SebKuzminsky/MazakVQC1540/machine-pics/PXL_20220612_192915210.jpg

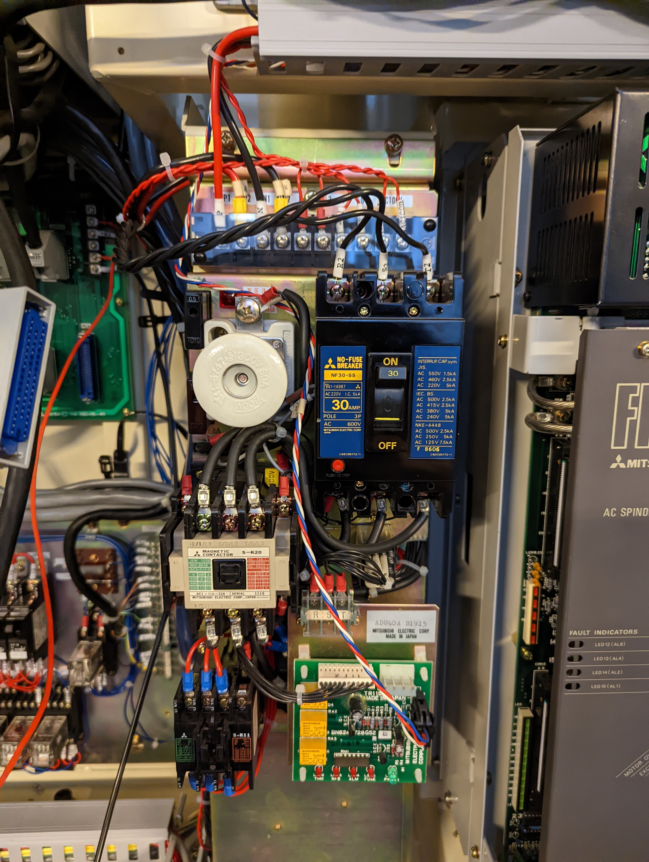
machine-pics/PXL_20220612_192915210.jpg
