SebKuzminsky/MazakVQC1540/machine-pics/PXL_20220614_065109930.jpg

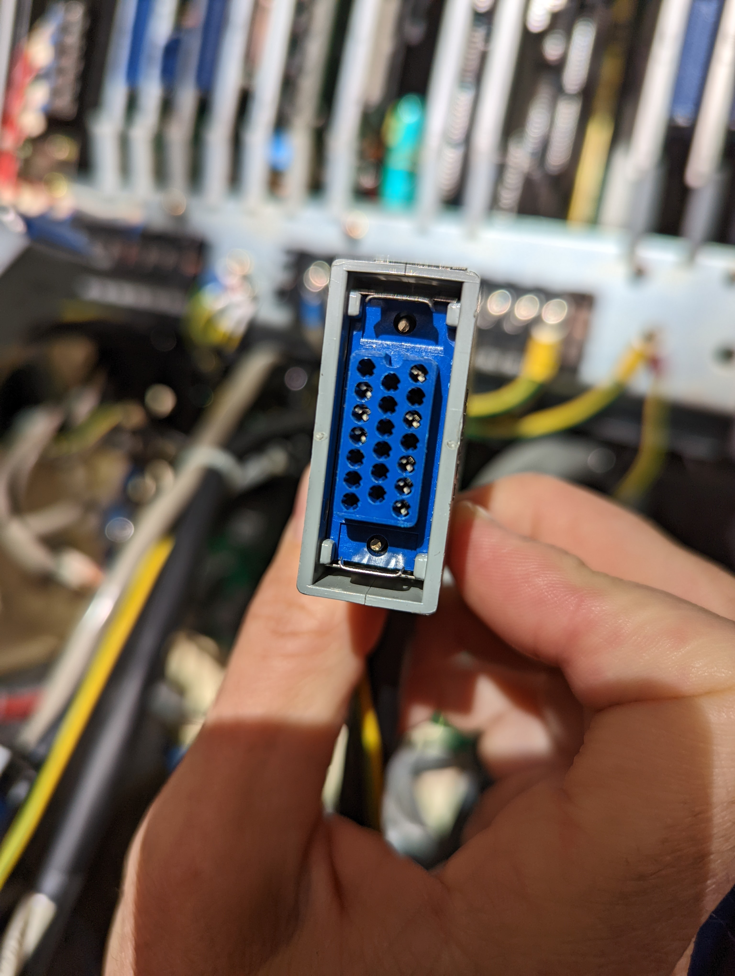
machine-pics/PXL_20220614_065109930.jpg
