SebKuzminsky/MazakVQC1540/docs/README.md

Documentation downloaded from the Internet
==========================================

* 8-channel-5v-relay-module/
* mesa/

* Meldas-Servo-Amp-maintenance-manual.pdf
  https://www.rgbautomatyka.pl/en/p/file/f828d04fb4ae38ead861076fa228e53f/TRA-41A-SERVO-DRIVE-MITSUBISHI-MANUAL.pdf
* meldas_trs50.pdf
  https://www.manualslib.com/manual/2310879/Mitsubishi-Meldas-Trs50.html
* Mitsubishi-Freqrol-SF-maintenance-manual.pdf
  http://cncmanual.com/mitsubishi-ac-spindle-drive-freqrol-sf-maintenance-manual/
* Mitsubishi-Freqrol-FR-SE-Maintenance-Manual.pdf
  http://cncmanual.com/mitsubishi-freqrol-ac-spindle-controller-fr-se-maintenance-manual/
* MR-connectors.pdf
  https://www.onlinecomponents.com/en/datasheet/mr50l-42248021/
* mrp-m1( )( ).pdf
  https://www.onlinecomponents.com/en/datasheet/mrpm112-41909323/
* MazatrolM2OperatorManual.pdf - Operating Manual for Mazak Mazatrol Cam M-2
  http://catiadoc.free.fr/img/MazatrolM2OperatorManual.pdf
* Mitsubishi-Freqrol-SE-Standard-Specification.pdf
  https://elektrotanya.com/mitsubishi_freqrol_fr-se_ac-spindle-controller_ver-3.00_instruction_sm.zip/download.html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
* Mazak-VQC-15-40-1986-Electrical-Circuit-Diagrams.pdf
  https://pastebin.com/uzooZah6
