SebKuzminsky/MazakVQC1540/Mazak-Oil.md

| CHEVRON | MOBIL |
|---|---|
| Waylube 68? $73.45  | Vactra 2 |
| Regal R&O 32 $70.80 | DTE Light  |
| Rando 10 $67.80 | Velocite 6 |
