SebKuzminsky/MazakVQC1540/machine-pics/mesa-cutting-board.jpeg

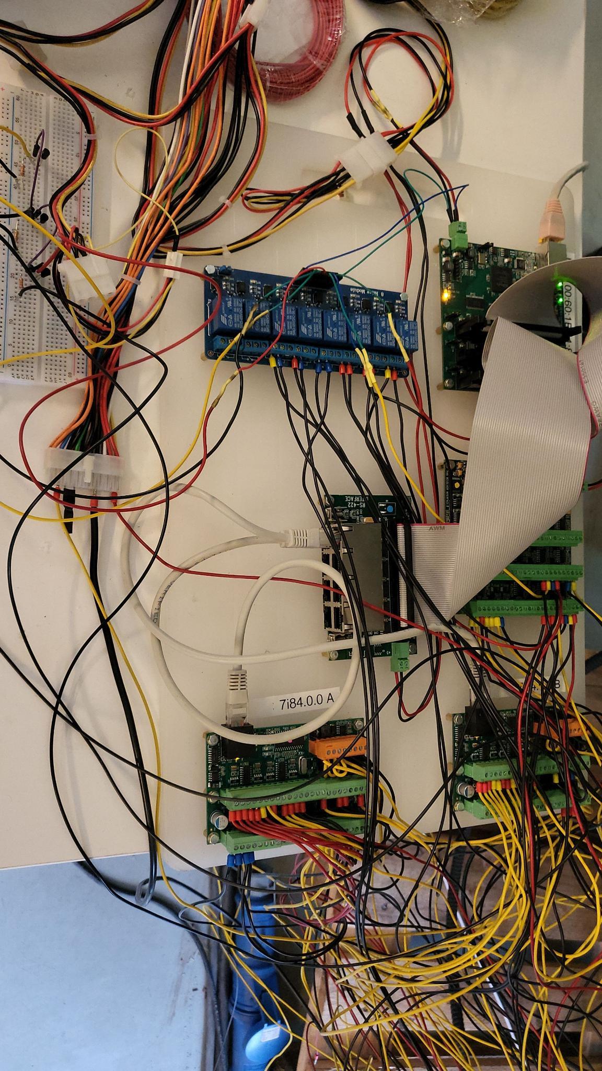
machine-pics/mesa-cutting-board.jpeg
