SebKuzminsky/MazakVQC1540/machine-pics/PXL_20220612_154800086.jpg

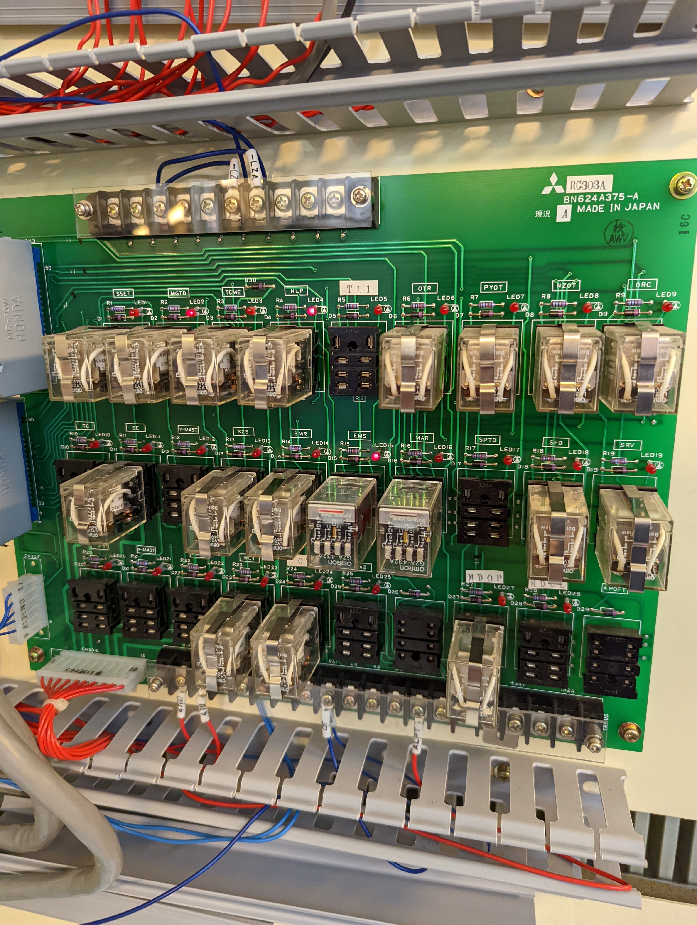
machine-pics/PXL_20220612_154800086.jpg
