SebKuzminsky/MazakVQC1540/machine-pics/PXL_20220612_192840629.jpg

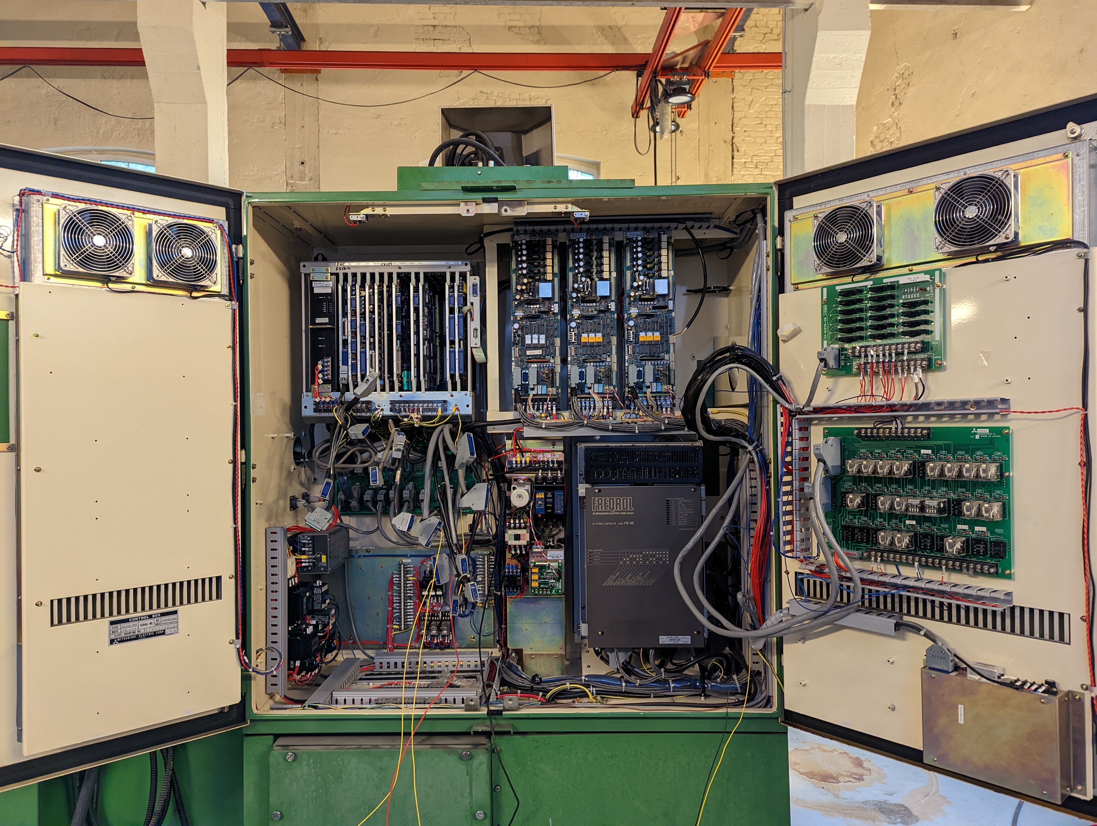
machine-pics/PXL_20220612_192840629.jpg
