SebKuzminsky/MazakVQC1540/machine-pics/PXL_20220612_192848661.jpg

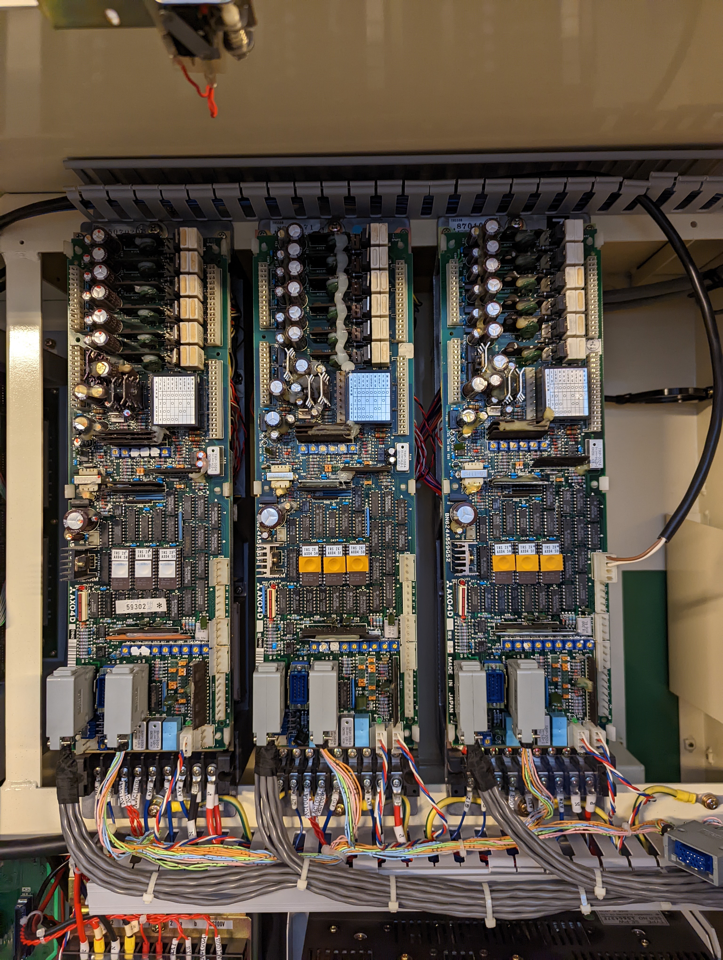
machine-pics/PXL_20220612_192848661.jpg
