SebKuzminsky/MazakVQC1540/machine-pics/PXL_20220612_192853894.jpg

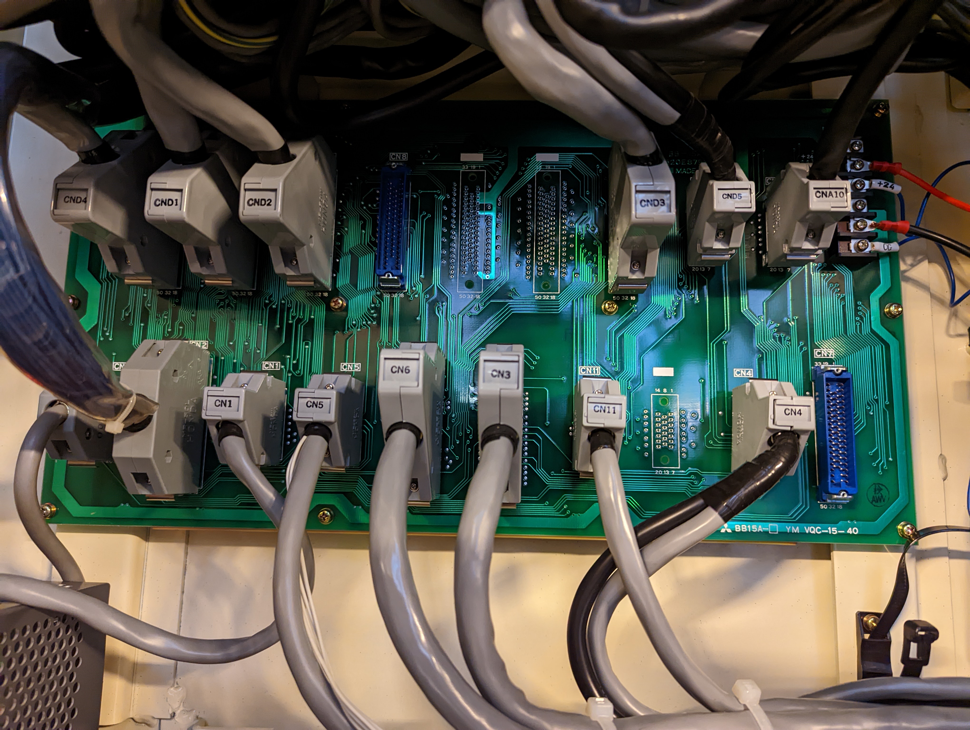
machine-pics/PXL_20220612_192853894.jpg
