SebKuzminsky/MazakVQC1540/machine-pics/PXL_20220612_192858269.jpg

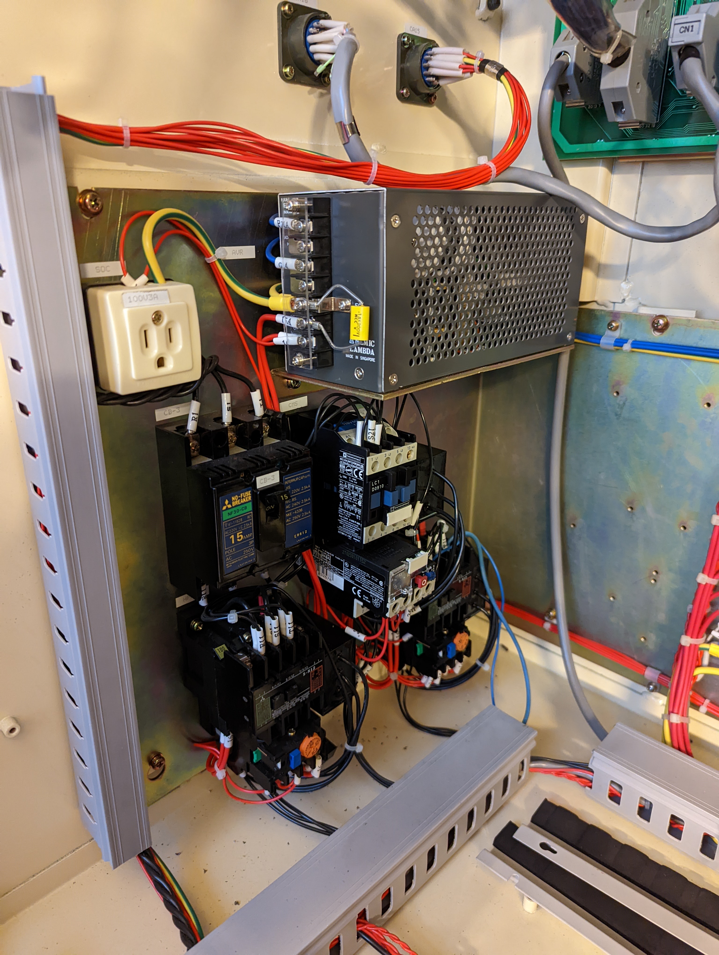
machine-pics/PXL_20220612_192858269.jpg
