SebKuzminsky/MazakVQC1540/machine-pics/PXL_20220612_192907922.jpg

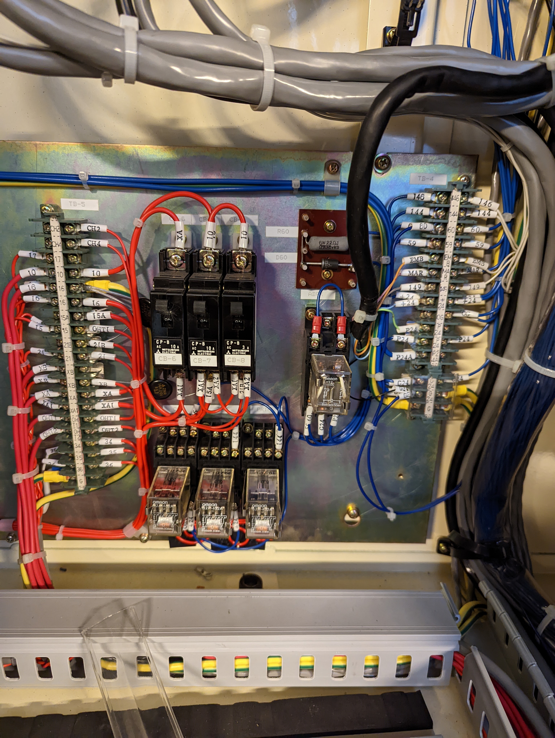
machine-pics/PXL_20220612_192907922.jpg
