SebKuzminsky/MazakVQC1540/machine-pics/PXL_20220612_192912369.jpg

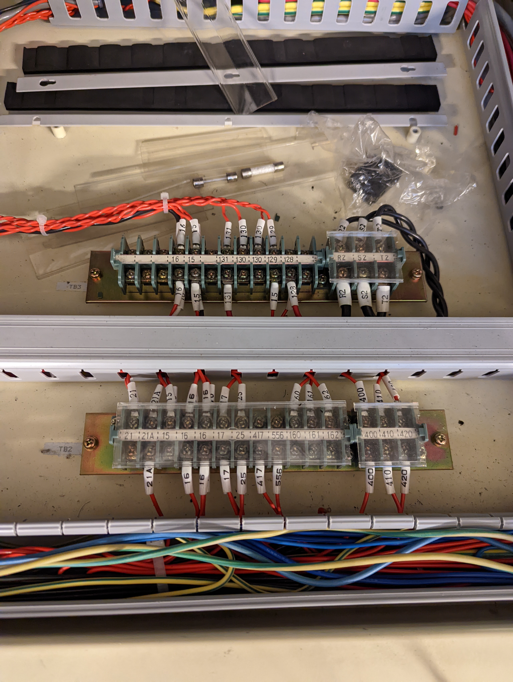
machine-pics/PXL_20220612_192912369.jpg
