SebKuzminsky/MazakVQC1540/machine-pics/PXL_20220612_192921102.jpg

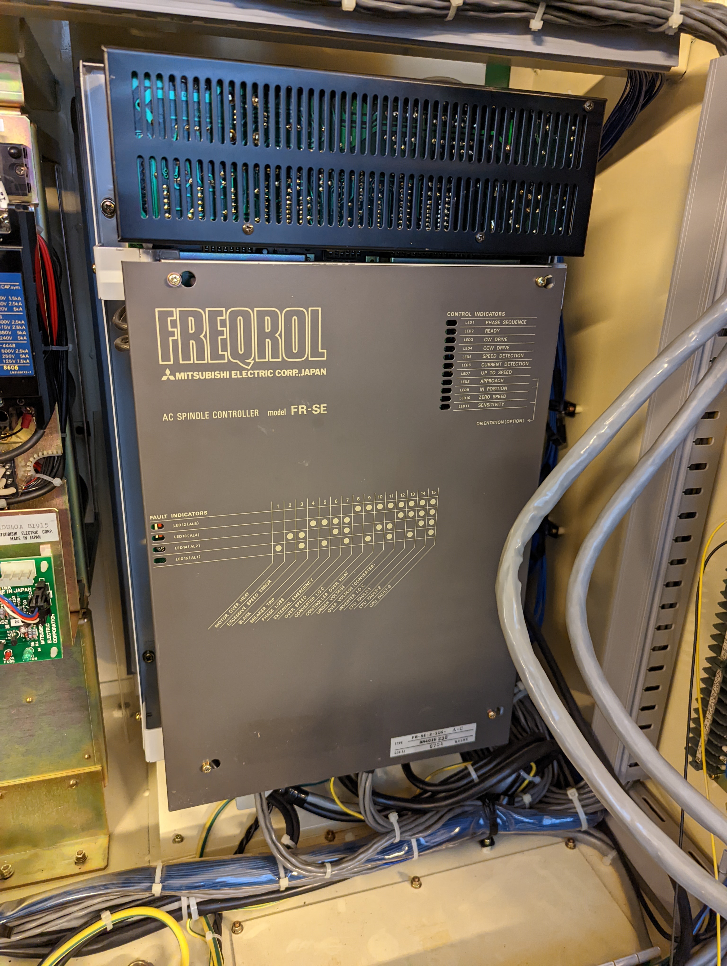
machine-pics/PXL_20220612_192921102.jpg
