SebKuzminsky/MazakVQC1540/machine-pics/PXL_20220612_192928278.jpg

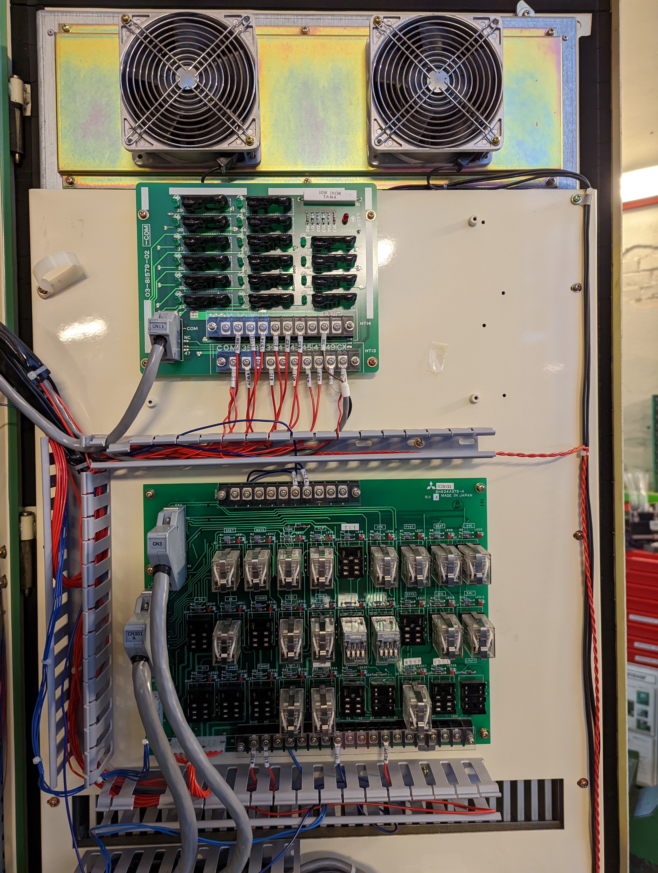
machine-pics/PXL_20220612_192928278.jpg
