SebKuzminsky/MazakVQC1540/machine-pics/PXL_20220613_133133988.jpg

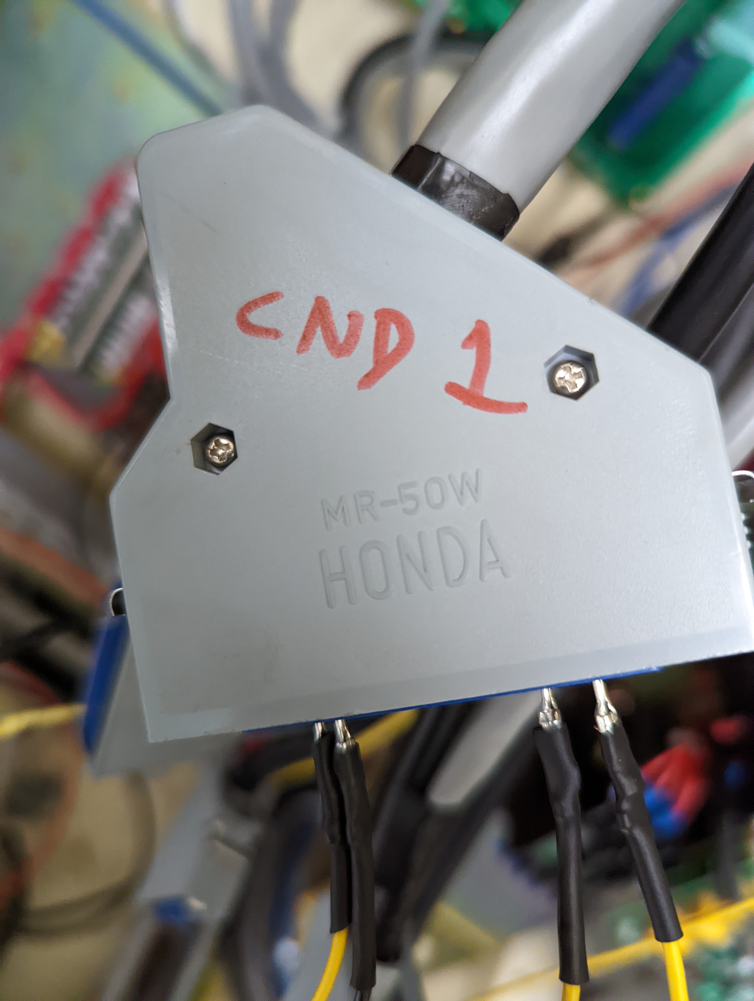
machine-pics/PXL_20220613_133133988.jpg
