SebKuzminsky/MazakVQC1540/machine-pics/PXL_20220614_065118337.jpg

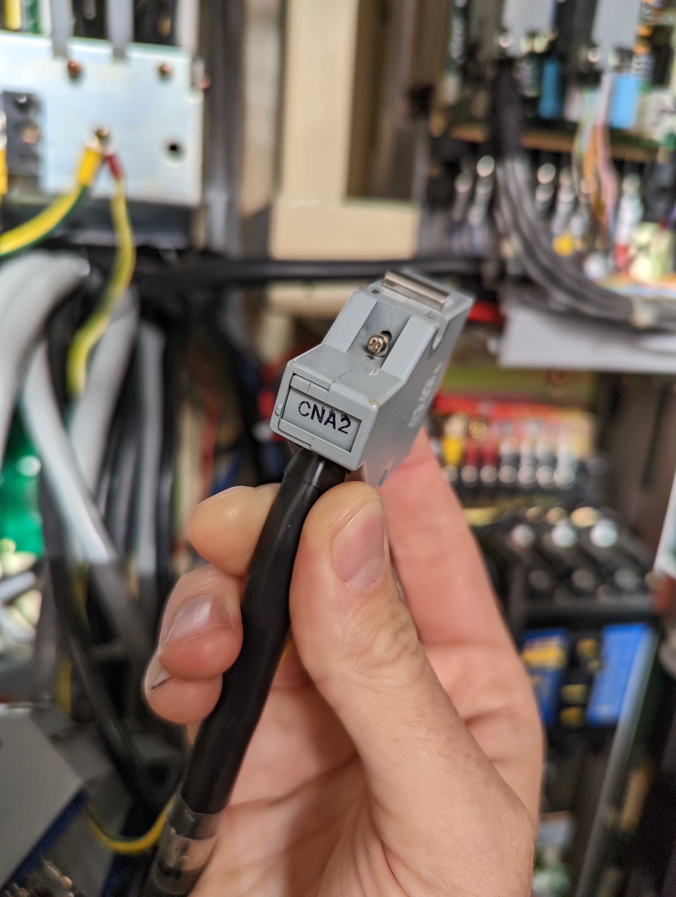
machine-pics/PXL_20220614_065118337.jpg
