SebKuzminsky/MazakVQC1540/machine-pics/PXL_20220614_075249411.jpg

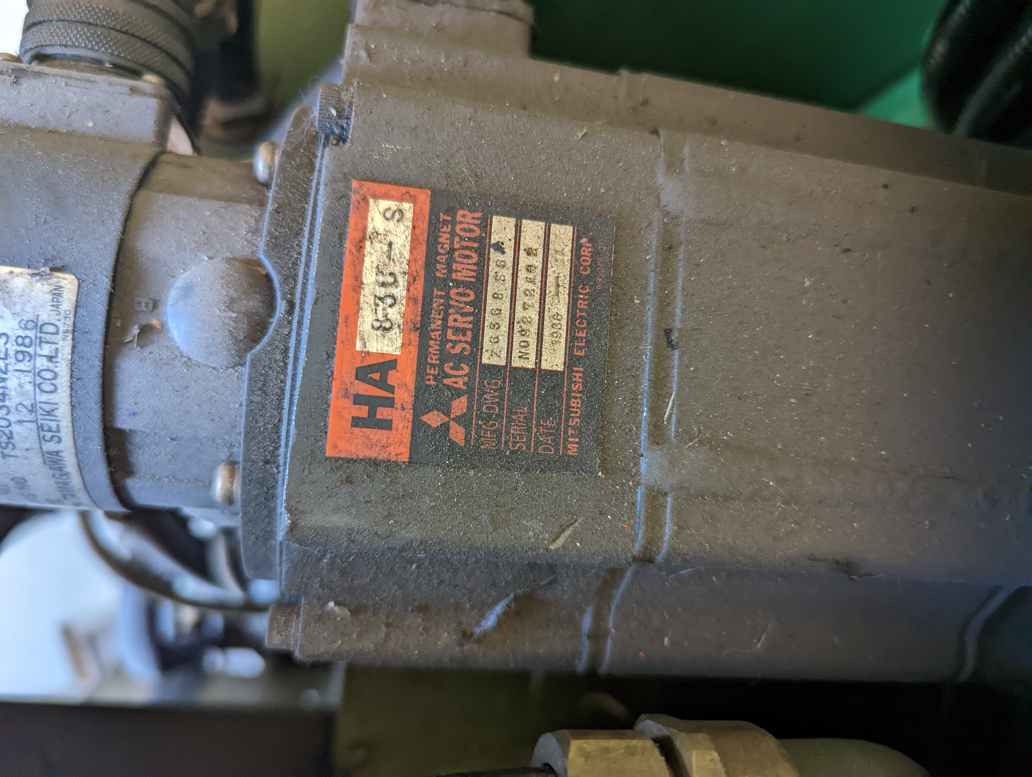
machine-pics/PXL_20220614_075249411.jpg
