SebKuzminsky/MazakVQC1540/machine-pics/PXL_20220614_075259628.jpg

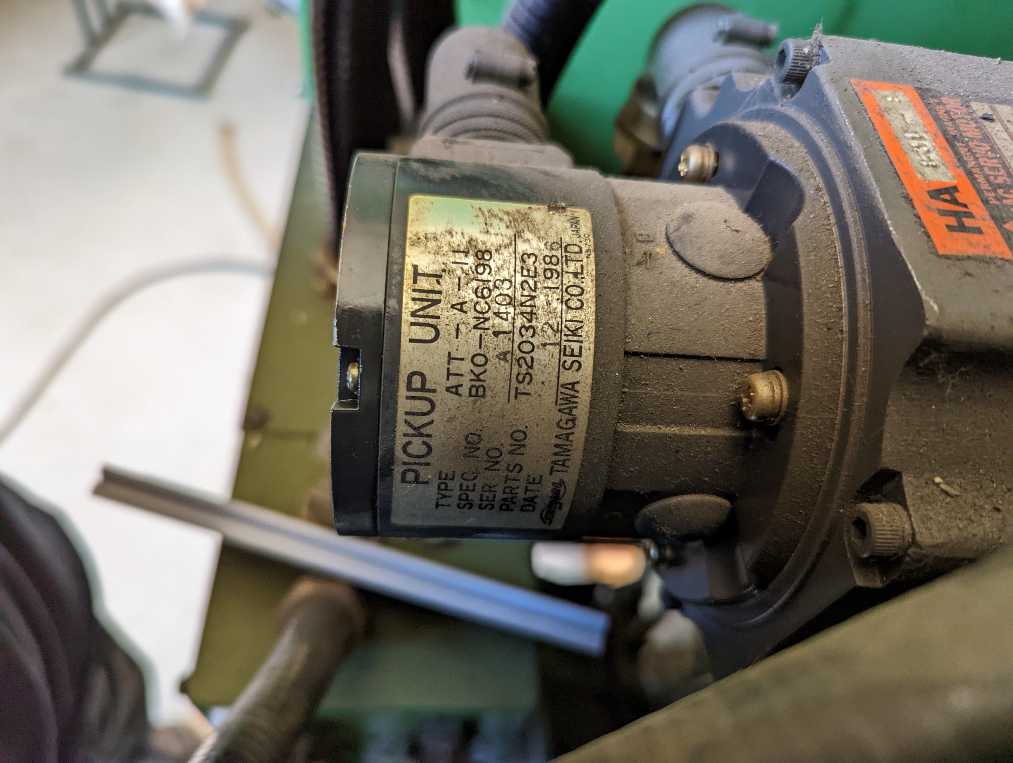
machine-pics/PXL_20220614_075259628.jpg
