SebKuzminsky/MazakVQC1540/machine-pics/PXL_20220614_083736623.jpg

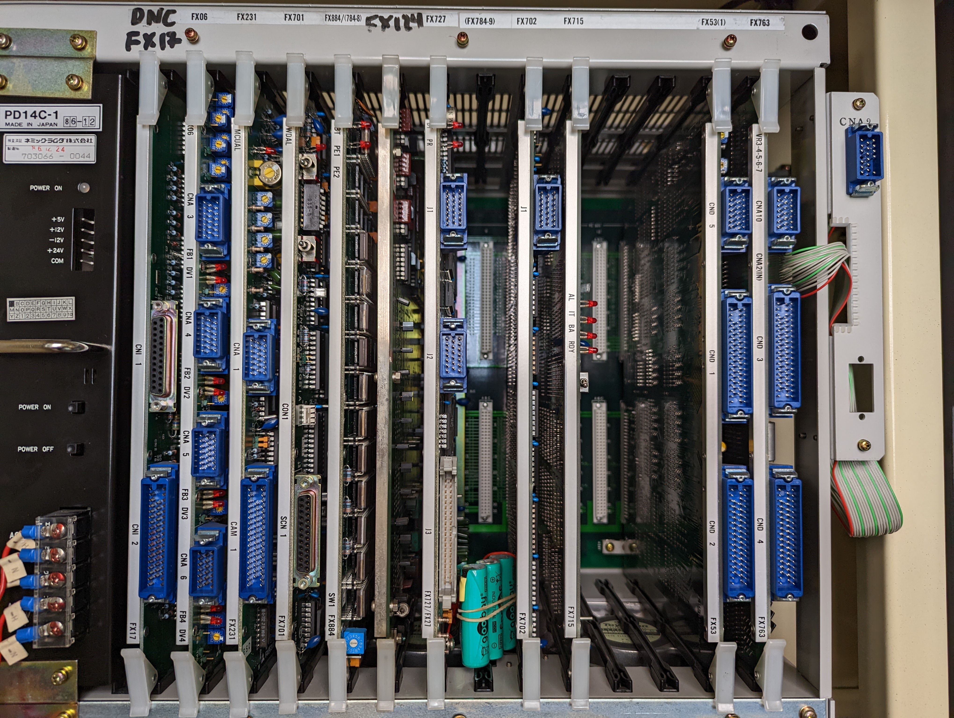
machine-pics/PXL_20220614_083736623.jpg
