SebKuzminsky/MazakVQC1540/docs/Altivar-71-3kW-240V/ATV71_communication_parameters_EN_V5.7_IE67.xls

Sheet: Parameters
Code | Name | Logic address | CANopen index | INTERBUS index | DeviceNet path | Link | Category | Access | Type | Units | Factory setting | Range | Display | Menu | Order
CMD | Control word | 16#2199 = 8601 (speed) 16#2135 = 8501 (frequency) | 16#6040/00 | 16#6040/00 | 16#8B/01/66 = 139/01/102 | CMD | Control parameters | R/W | WORD (BitString16) | - |  | - | [Cmd value] (CMd) | [COMMUNICATION MAP] (CMM-) | 1
CMI | Extended control word | 16#2138 = 8504 | 16#2037/5 | 16#5FB6/1E | 16#8B/01/69 = 139/01/105 | CMI | Control parameters | R/W | WORD (BitString16) | - |  | - |  |  | 2
RPR | Reset counters command | 16#0C30 = 3120 | 16#2001/15 | 16#5FB6/01 | 16#70/01/79 = 112/01/121 | RPR | Control parameters | R/W | WORD (Enumeration) | - | [No] (nO) | - | [Operating t. reset] (rPr) | [RUN Elapsed Time Reset] (Etr-) | 3
LFRD | Speed setpoint | 16#219A = 8602 | 16#6042/00 | 16#6042/00 | 16#2A/01/08 = 42/1/8 (messaging) 16#8C/01/03 = 140/1/3 (assembly) | - | Setpoint parameters | R/W | INT (Signed16) | 1 rpm | 0 rpm | - |  |  | 4
LFR | Frequency setpoint | 16#2136 = 8502 | 16#2037/3 | 16#5FB6/1C | 16#8B/01/67 = 139/01/103 | - | Setpoint parameters | R/W | INT (Signed16) | 0.1 Hz | 0.0 Hz | -3276.7 Hz ... 3276.7 Hz | [Frequency ref.] (LFr) | [MONITORING] (SUP-) | 5
LTR | Torque setpoint | 16#2139 = 8505 | 16#6071/00 | 16#5FB6/1F | 16#8B/01/6A = 139/01/106 | - | Setpoint parameters | R/W | INT (Signed16) | 0.1 % | 0.0 % | -300.0 % ... 300.0 % | [Torque ref.] (Ltr) | [MONITORING] (SUP-) | 6
PISP | PID regulator setpoint | 16#2137 = 8503 | 16#2037/4 | 16#5FB6/1D | 16#8B/01/68 = 139/01/104 | - | Setpoint parameters | R/W | UINT (Unsigned16) | 1 |  | 0 ... 1000 |  |  | 7
AIV1 | PID regulator feedback | 16#14A1 = 5281 | 16#2016/52 | 16#5FB6/5B | 16#7B/01/52 = 123/01/82 | - | Setpoint parameters | R/W | INT (Signed16) | 1 | 0 | -8192 ... 8192 |  |  | 8
MFR | Multiplying coefficient | 16#2E37 = 11831 | 16#2058/20 | 16#5FB6/3E | 16#9C/01/20 = 156/01/32 | - | Setpoint parameters | R/W | UINT (Unsigned16) | 1 % |  | 0 % ... 100 % | [Multiplying coeff.] (MFr) | [MONITORING] (SUP-) [SETTINGS] (SEt-) | 9
ETA | Status word | 16#219B = 8603 (speed) 16#0C81 = 3201 (frequency) | 16#6041/00 | 16#6041/00 | 16#71/01/02 = 113/01/02 | ETA | Status parameters | R | WORD (BitString16) | - |  | - | [ETA state word] (EtA) | [COMMUNICATION MAP] (CMM-) | 10
HMIS | Drive state | 16#0CA8 = 3240 | 16#2002/29 | 16#5FB9/1B | 16#71/01/29 = 113/01/41 | HMIS | Status parameters | R | WORD (Enumeration) | - |  | - |  |  | 11
ETI | Extended status word | 16#0C86 = 3206 | 16#2002/7 | 16#5FB9/08 | 16#71/01/07 = 113/01/07 | ETI | Status parameters | R | WORD (BitString16) | - |  | - |  |  | 12
LRS1 | Extended status word 1 | 16#0CB2 = 3250 | 16#2002/33 | 16#5FB9/1C | 16#71/01/33 = 113/01/51 | LRS1 | Status parameters | R | WORD (BitString16) | - |  | - |  |  | 13
LRS2 | Extended status word 2 | 16#0CB3 = 3251 | 16#2002/34 | 16#5FB9/1D | 16#71/01/34 = 113/01/52 | LRS2 | Status parameters | R | WORD (BitString16) | - |  | - |  |  | 14
LRS3 | Extended status word 3 | 16#0CB4 = 3252 | 16#2002/35 | 16#5FB9/1E | 16#71/01/35 = 113/01/53 | LRS3 | Status parameters | R | WORD (BitString16) | - |  | - |  |  | 15
LRS4 | Extended status word 4 | 16#0CB5 = 3253 | 16#2002/36 | 16#5FB9/1F | 16#71/01/36 = 113/01/54 | LRS4 | Status parameters | R | WORD (BitString16) | - |  | - |  |  | 16
LRS5 | Extended status word 5 | 16#0CB6 = 3254 | 16#2002/37 | 16#5FB9/20 | 16#71/01/37 = 113/01/55 | LRS5 | Status parameters | R | WORD (BitString16) | - |  | - |  |  | 17
LRS6 | Extended status word 6 | 16#0CB7 = 3255 | 16#2002/38 | 16#5FB9/21 | 16#71/01/38 = 113/01/56 | LRS6 | Status parameters | R | WORD (BitString16) | - |  | - |  |  | 18
LRS7 | Extended status word 7 | 16#0CB8 = 3256 | 16#2002/39 | 16#5FB9/22 | 16#71/01/39 = 113/01/57 | LRS7 | Status parameters | R | WORD (BitString16) | - |  | - |  |  | 19
LRS8 | Extended status word 8 | 16#0CB9 = 3257 | 16#2002/3A | 16#5FB9/23 | 16#71/01/3A = 113/01/58 | LRS8 | Status parameters | R | WORD (BitString16) | - |  | - |  |  | 20
CRC | Active reference channel | 16#20F9 = 8441 | 16#2036/2A | 16#5FB9/CE | 16#8B/01/2A = 139/01/42 | CRC | Status parameters | R | WORD (BitString16) | - |  | - |  |  | 21
CCC | Active command channel | 16#20FA = 8442 | 16#2036/2B | 16#5FB9/CF | 16#8B/01/2B = 139/01/43 | CCC | Status parameters | R | WORD (BitString16) | - |  | - |  |  | 22
CNFS | Config. active | 16#1F54 = 8020 | 16#2032/15 | 16#5FB9/CD | 16#89/01/15 = 137/01/21 | CNFS | Status parameters | R | WORD (Enumeration) | - |  | - | [Config. active] (CnFS) | [MONITORING] (SUP-) | 23
ECSS | EtherCAT Slave Status | 16#1A22 = 6690 | 16#2024/5B | - | 16#82/01/5B = 130/01/91 | ETST | Status parameters | R | WORD (Enumeration) | - |  | - | [EthCat slave status] (ECSS) | [COMMUNICATION CARD] (Cbd-) | 24
ECAA | EtherCAT second Address actual value | 16#1A24 = 6692 | 16#2024/5D | - | 16#82/01/5D = 130/01/93 | - | Status parameters | R | UINT (Unsigned16) | 1 | 0 | 0 ... 65535 | [EthCat addr] (ECAA) | [COMMUNICATION CARD] (Cbd-) | 25
RFRD | Output velocity | 16#219C = 8604 | 16#6044/00 | 16#6044/00 | 16#2A/01/07 = 42/1/7 (messaging) 16#8C/01/05 = 140/1/5 (assembly) | - | Actual values parameters | R | INT (Signed16) | 1 rpm |  | - |  |  | 26
RFR | Output frequency | 16#0C82 = 3202 | 16#2002/3 | 16#5FB9/04 | 16#71/01/03 = 113/01/03 | - | Actual values parameters | R | INT (Signed16) | 0.1 Hz |  | -3276.7 Hz ... 3276.7 Hz | [Output frequency] (rFr) | [MONITORING] (SUP-) | 27
OTR | Motor torque | 16#0C85 = 3205 | 16#6077/00 | 16#5FB9/07 | 16#71/01/06 = 113/01/06 | - | Actual values parameters | R | INT (Signed16) | Refer to programming manual |  | Refer to programming manual | [Motor torque] (Otr) | [MONITORING] (SUP-) | 28
LCR | Motor current | 16#0C84 = 3204 | 16#2002/5 | 16#5FB9/06 | 16#2A/01/09 = 42/1/9 (messaging) 16#71/01/05 = 113/1/5 (assembly) | - | Actual values parameters | R | UINT (Unsigned16) | Refer to programming manual |  | Refer to programming manual | [Motor current] (LCr) | [MONITORING] (SUP-) | 29
UOP | Motor voltage | 16#0C88 = 3208 | 16#2002/9 | 16#5FB9/0A | 16#71/01/09 = 113/01/09 | - | Actual values parameters | R | UINT (Unsigned16) | 1 V |  | 0 V ... 65535 V | [Motor voltage] (UOP) | [MONITORING] (SUP-) | 30
OPR | Motor power | 16#0C8B = 3211 | 16#2002/C | 16#5FB9/0C | 16#71/01/0C = 113/01/12 | - | Actual values parameters | R | INT (Signed16) | 1 % |  | -32767 % ... 32767 % | [Motor power] (OPr) | [MONITORING] (SUP-) | 31
AVS | ENA average speed | 16#2F46 = 12102 | 16#205B/3 | 16#5FB9/EA | 16#9D/01/67 = 157/01/103 | - | Actual values parameters | R | INT (Signed16) | 0.1 Hz |  | -3276.7 Hz ... 3276.7 Hz | [ENA avg speed] (AUS) | [MONITORING] (SUP-) | 32
FRHD | Speed reference before ramp | 16#219D = 8605 | 16#2038/6 | 16#6043/00 | 16#8C/01/06 = 140/01/06 | - | Reference parameters | R | INT (Signed16) | 1 rpm |  | - |  |  | 33
FROD | Speed reference after ramp | 16#21C1 = 8641 | 16#6043/00 | 16#5FB9/D8 | 16#8C/01/2A = 140/01/42 | - | Reference parameters | R | INT (Signed16) | 1 rpm |  | - |  |  | 34
FRH | Frequency reference before ramp | 16#0C83 = 3203 | 16#2002/4 | 16#5FB9/05 | 16#71/01/04 = 113/01/04 | - | Reference parameters | R | INT (Signed16) | 0.1 Hz |  | -1600.0 Hz ... 1600.0 Hz | [Frequency ref.] (FrH) | [MONITORING] (SUP-) [COMMUNICATION MAP] (CMM-) | 35
FRO | Frequency reference after ramp | 16#233D = 9021 | 16#203C/16 | 16#5FB9/D9 | 16#8E/01/16 = 142/01/22 | - | Reference parameters | R | INT (Signed16) | 0.1 Hz |  | - |  |  | 36
TRR | Torque reference before ramp | 16#240F = 9231 | 16#203E/20 | 16#5FB9/DB | 16#8F/01/20 = 143/01/32 | - | Reference parameters | R | INT (Signed16) | 0.1 % |  | - | [Torque reference] (trr) | [MONITORING] (SUP-) | 37
RPC | PID reference after ramp | 16#2ECE = 11982 | 16#2059/53 | 16#5FB9/E7 | 16#9C/01/B7 = 156/01/183 | - | Reference parameters | R | UINT (Unsigned16) | 1 |  | 0 ... 65535 | [PID reference] (rPC) | [MONITORING] (SUP-) | 38
RPF | PID regulator feedback reference | 16#2ECD = 11981 | 16#2059/52 | 16#5FB9/E6 | 16#9C/01/B6 = 156/01/182 | - | Reference parameters | R | UINT (Unsigned16) | 1 |  | 0 ... 65535 | [PID feedback] (rPF) | [MONITORING] (SUP-) | 39
RPE | PID regulator discrepancy | 16#2ECC = 11980 | 16#2059/51 | 16#5FB9/E5 | 16#9C/01/B5 = 156/01/181 | - | Reference parameters | R | INT (Signed16) | 1 |  | -32767 ... 32767 | [PID error] (rPE) | [MONITORING] (SUP-) | 40
RPO | PID regulator limit output reference | 16#2ECF = 11983 | 16#2059/54 | 16#5FB9/E8 | 16#9C/01/B8 = 156/01/184 | - | Reference parameters | R | INT (Signed16) | 0.1 Hz |  | -3276.7 Hz ... 3276.7 Hz | [PID Output] (rPO) | [MONITORING] (SUP-) | 41
DAY | Date | 16#1CDF = 7391 | 16#202B/5C | 16#5FB9/CA | 16#85/01/C0 = 133/01/192 | - | Measurement parameters | R/W | UINT (Unsigned16) | 1 |  | 0 ... 65535 | (dAY) | (CLO-) | 42
TIME | Time | 16#1CE0 = 7392 | 16#202B/5D | 16#5FB9/CB | 16#85/01/C1 = 133/01/193 | - | Measurement parameters | R/W | UINT (Unsigned16) | 1 |  | 0 ... 65535 | (tIME) | (CLO-) | 43
ULN | Mains voltage | 16#0C87 = 3207 | 16#2002/8 | 16#5FB9/09 | 16#71/01/08 = 113/01/08 | - | Measurement parameters | R | UINT (Unsigned16) | 0.1 V |  | [No meas.] (----) ... 6553.5 V | [Mains voltage] (ULn) | [U CALIBRATION RESULT] (CAU-) [MONITORING] (SUP-) | 44
APH | Energy consumption | 16#0C9E = 3230 | 16#2002/1F | 16#5FB9/15 | 16#71/01/1F = 113/01/31 | - | Measurement parameters | R | UINT (Unsigned16) | Refer to programming manual |  | Refer to programming manual | [Consumption] (APH) | [MONITORING] (SUP-) | 45
THD | Drive thermal state | 16#0C89 = 3209 | 16#2002/A | 16#5FB9/0B | 16#71/01/0A = 113/01/10 | - | Measurement parameters | R | UINT (Unsigned16) | 1 % |  | 0 % ... 200 % | [Drv. thermal state] (tHd) | [MONITORING] (SUP-) | 46
THR | Motor thermal state | 16#259E = 9630 | 16#2042/1F | 16#5FB9/DE | 16#91/01/1F = 145/01/31 | - | Measurement parameters | R | UINT (Unsigned16) | 1 % |  | 0 % ... 200 % | [Motor thermal state] (tHr) | [MONITORING] (SUP-) | 47
THB | Resistor thermal state | 16#3722 = 14114 | 16#206F/F | 16#5FBA/6A | 16#A7/01/73 = 167/01/115 | - | Measurement parameters | R | UINT (Unsigned16) | 1 % |  | 0 % ... 65535 % | [DBR thermal state] (tHb) | [MONITORING] (SUP-) | 48
RTH | Total motor operating time | 16#0C9F = 3231 | 16#2002/20 | 16#5FB9/16 | 16#71/01/20 = 113/01/32 | - | Measurement parameters | R | UINT (Unsigned16) | Refer to programming manual |  | Refer to programming manual | [Run time] (rtH) | [MONITORING] (SUP-) | 49
PTH | Total drive operating time | 16#0CA1 = 3233 | 16#2002/22 | 16#5FB9/18 | 16#71/01/22 = 113/01/34 | - | Measurement parameters | R | UINT (Unsigned16) | Refer to programming manual |  | Refer to programming manual | [Power on time] (PtH) | [MONITORING] (SUP-) | 50
TAC | IGBT alarm time | 16#0CA3 = 3235 | 16#2002/24 | 16#5FB9/1A | 16#71/01/24 = 113/01/36 | - | Measurement parameters | R/WS | UINT (Unsigned16) | 1 s |  | 0 s ... 65535 s | [IGBT alarm counter] (tAC) | [MONITORING] (SUP-) | 51
IL1R | Logic inputs states | 16#1452 = 5202 | 16#2016/3 | 16#5FB9/28 | 16#7B/01/03 = 123/01/03 | IL1R | I/O parameters | R | WORD (BitString16) | - |  | - |  |  | 52
OL1R | Logic outputs states | 16#145C = 5212 | 16#2016/D | 16#5FB9/2A (R) 16#5FB6/54 (W) | 16#7B/01/0D = 123/01/13 | OL1R | I/O parameters | R/W | WORD (BitString16) | - |  | - |  |  | 53
AI1C | Analog input 1 physical value | 16#147A = 5242 | 16#2016/2B | 16#5FB9/33 | 16#7B/01/2B = 123/01/43 | - | I/O parameters | R | INT (Signed16) | Refer to programming manual |  | - |  |  | 54
AI1R | Analog input 1 standardized value | 16#1470 = 5232 | 16#2016/21 | 16#5FB9/2F | 16#7B/01/21 = 123/01/33 | - | I/O parameters | R | INT (Signed16) | 1 |  | - |  |  | 55
AI2C | Analog input 2 physical value | 16#147B = 5243 | 16#2016/2C | 16#5FB9/34 | 16#7B/01/2C = 123/01/44 | - | I/O parameters | R | INT (Signed16) | Refer to programming manual |  | - |  |  | 56
AI2R | Analog input 2 standardized value | 16#1471 = 5233 | 16#2016/22 | 16#5FB9/30 | 16#7B/01/22 = 123/01/34 | - | I/O parameters | R | INT (Signed16) | 1 |  | - |  |  | 57
AI3C | Analog input 3 physical value | 16#147C = 5244 | 16#2016/2D | 16#5FB9/35 | 16#7B/01/2D = 123/01/45 | - | I/O parameters | R | INT (Signed16) | Refer to programming manual |  | - |  |  | 58
AI3R | Analog input 3 standardized value | 16#1472 = 5234 | 16#2016/23 | 16#5FB9/31 | 16#7B/01/23 = 123/01/35 | - | I/O parameters | R/W | INT (Signed16) | 1 |  | - |  |  | 59
AI4C | Analog input 4 physical value | 16#147D = 5245 | 16#2016/2E | 16#5FB9/36 | 16#7B/01/2E = 123/01/46 | - | I/O parameters | R | INT (Signed16) | Refer to programming manual |  | - |  |  | 60
AI4R | Analog input 4 standardized value | 16#1473 = 5235 | 16#2016/24 | 16#5FB9/32 | 16#7B/01/24 = 123/01/36 | - | I/O parameters | R | INT (Signed16) | 1 |  | - |  |  | 61
AO1C | Analog output 1 physical value | 16#1497 = 5271 | 16#2016/48 | 16#5FB9/3D (R) 16#5FB6/56 (W) | 16#7B/01/48 = 123/01/72 | - | I/O parameters | R/W | INT (Signed16) | Refer to programming manual |  | - |  |  | 62
AO1R | Analog output 1 standardized value | 16#148D = 5261 | 16#2016/3E | 16#5FB9/3A (R) 16#5FB6/55 (W) | 16#7B/01/3E = 123/01/62 | - | I/O parameters | R/W | INT (Signed16) | 1 |  | - |  |  | 63
AO2C | Analog output 2 physical value | 16#1498 = 5272 | 16#2016/49 | 16#5FB9/3E (R) 16#5FB6/58 (W) | 16#7B/01/49 = 123/01/73 | - | I/O parameters | R/W | INT (Signed16) | Refer to programming manual |  | - |  |  | 64
AO2R | Analog output 2 standardized value | 16#148E = 5262 | 16#2016/3F | 16#5FB9/3B (R) 16#5FB6/57 (W) | 16#7B/01/3F = 123/01/63 | - | I/O parameters | R/W | INT (Signed16) | 1 |  | - |  |  | 65
AO3C | Analog output 3 physical value | 16#1499 = 5273 | 16#2016/4A | 16#5FB9/3F (R) 16#5FB6/5A (W) | 16#7B/01/4A = 123/01/74 | - | I/O parameters | R/W | INT (Signed16) | Refer to programming manual |  | - |  |  | 66
AO3R | Analog output 3 standardized value | 16#148F = 5263 | 16#2016/40 | 16#5FB9/3C (R) 16#5FB6/59 (W) | 16#7B/01/40 = 123/01/64 | - | I/O parameters | R/W | INT (Signed16) | 1 |  | - |  |  | 67
FQS | Pulse input frequency | 16#390B = 14603 | 16#2074/4 | 16#5FBA/6B | 16#AA/01/04 = 170/01/04 | - | I/O parameters | R | UINT (Unsigned16) | 1 Hz |  | 0 Hz ... 30000 Hz | [Pulse in. work. freq.] (FqS) | [MONITORING] (SUP-) | 68
PUC | Encoder counter value | 16#15EB = 5611 | 16#201A/C | 16#5FB9/41 | 16#7D/01/0C = 125/01/12 | - | I/O parameters | R | UINT (Unsigned16) | 1 |  | - |  |  | 69
MMF | Encoder frequency | 16#0C93 = 3219 | 16#2002/14 | 16#5FBA/28 | 16#71/01/14 = 113/01/20 | - | I/O parameters | R | INT (Signed16) | 0.1 Hz |  | -3276.7 Hz ... 3276.7 Hz | [Measured output fr.] (MMF) | [MONITORING] (SUP-) | 70
PIL1 | Controller logic inputs states | 16#1AF5 = 6901 | 16#2027/2 | 16#5FB9/49 | 16#83/01/66 = 131/01/102 | PIL1 | I/O parameters | R | WORD (BitString16) | - |  | - |  |  | 71
POL1 | Controller logic outputs states | 16#1AFF = 6911 | 16#2027/C | 16#5FB9/4A | 16#83/01/70 = 131/01/112 | POL1 | I/O parameters | R | WORD (BitString16) | - |  | - |  |  | 72
PAI1 | Controller analog input 1 physical value | 16#1B1E = 6942 | 16#2027/2B | 16#5FB9/4B | 16#83/01/8F = 131/01/143 | - | I/O parameters | R | UINT (Unsigned16) | 0.001 mA |  | 0.000 mA ... 65.535 mA | [AI51] (PAI1) | [Controller inside AI MAP] (PAI-) | 73
PAI2 | Controller analog input 2 physical value | 16#1B1F = 6943 | 16#2027/2C | 16#5FB9/4C | 16#83/01/90 = 131/01/144 | - | I/O parameters | R | UINT (Unsigned16) | 0.001 mA |  | 0.000 mA ... 65.535 mA | [AI52] (PAI2) | [Controller inside AI MAP] (PAI-) | 74
PAO1 | Controller analog output 1 physical value | 16#1B3B = 6971 | 16#2027/48 | 16#5FB9/4D | 16#83/01/AC = 131/01/172 | - | I/O parameters | R | UINT (Unsigned16) | 0.001 mA |  | 0.000 mA ... 65.535 mA | [AO51] (PAO1) | [Controller inside AO MAP] (PAO-) | 75
PAO2 | Controller analog output 2 physical value | 16#1B3C = 6972 | 16#2027/49 | 16#5FB9/4E | 16#83/01/AD = 131/01/173 | - | I/O parameters | R | UINT (Unsigned16) | 0.001 mA |  | 0.000 mA ... 65.535 mA | [AO52] (PAO2) | [Controller inside AO MAP] (PAO-) | 76
ERRD | CiA402 fault code | 16#219E = 8606 | 16#603F/00 | 16#603F/00 | 16#29/01/0D = 41/1/13 (messaging) 16#8C/01/07 = 140/1/7 (assembly) | ERRD | Fault parameters | R | WORD (BitString16) | - |  | - |  |  | 77
LFT | Altivar fault code | 16#1BD1 = 7121 | 16#2029/16 | 16#5FB9/54 | 16#84/01/7A = 132/01/122 | LFT | Fault parameters | R | WORD (Enumeration) | - |  | - |  |  | 78
CIC | Incorrect configuration | 16#1BDA = 7130 | 16#2029/1F | 16#5FB6/1A | 16#84/01/83 = 132/01/131 | CIC | Fault parameters | R/WS | WORD (BitString16) | - |  | - |  |  | 79
APF | Controller Inside card fault code | 16#1BDD = 7133 | 16#2029/22 | 16#5FB0/97 | 16#84/01/86 = 132/01/134 | - | Fault parameters | R | UINT (Unsigned16) | 1 |  | 0 ... 65535 | [Application fault] (APF) | [MORE FAULT INFO] (AFI-) | 80
CNF | Network card fault code | 16#1BDC = 7132 | 16#2029/21 | 16#5FB0/96 | 16#84/01/85 = 132/01/133 | - | Fault parameters | R | UINT (Unsigned16) | 1 |  | 0 ... 65535 | [Network fault] (CnF) | [MORE FAULT INFO] (AFI-) | 81
ILF1 | Option card 1 fault code | 16#1BDE = 7134 | 16#2029/23 | 16#5FB0/98 | 16#84/01/87 = 132/01/135 | - | Fault parameters | R | UINT (Unsigned16) | 1 |  | 0 ... 65535 | [Internal link fault 1] (ILF1) | [MORE FAULT INFO] (AFI-) | 82
ILF2 | Option card 2 fault code | 16#1BDF = 7135 | 16#2029/24 | 16#5FB0/99 | 16#84/01/88 = 132/01/136 | - | Fault parameters | R | UINT (Unsigned16) | 1 |  | 0 ... 65535 | [Internal link fault 2] (ILF2) | [MORE FAULT INFO] (AFI-) | 83
FDRD | Ethernet fault code | 16#FAE9 = 64233 | - | - | - | - | Fault parameters | R | UINT (Unsigned16) | 1 |  | 0 ... 65535 | [FDR fault] (Fdrd) | [COMMUNICATION CARD] (Cbd-) | 84
FNB | Fault counter | 16#1CE1 = 7393 | 16#202B/5E | 16#5FB9/CC | 16#85/01/C2 = 133/01/194 | - | Fault parameters | R | UINT (Unsigned16) | 1 |  | 0 ... 65535 |  |  | 85
RZOP | Option Card auto reset | 16#1BE4 = 7140 | 16#2029/29 | - | 16#84/01/8D = 132/01/141 | - | Fault parameters | R | UINT (Unsigned16) | 1 |  | 0 ... 65535 |  |  | 86
IPAD | Profinet: Last error Code | 16#FB18 = 64280 | - | - | - | - | Fault parameters | R | UINT (Unsigned16) | 1 |  | 0 ... 5 | [iPar Error Cod] (IPAd) | [COMMUNICATION CARD] (Cbd-) | 87
ERR | Communication option: Ethernet specific error code | 16#FB0E = 64270 | - | - | - | - | Fault parameters | R | UINT (Unsigned16) | 1 | 0 | 0 ... 65535 | [Ethernet Error Code] (Err) | [COMMUNICATION CARD] (Cbd-) | 88
DP0 | Fault code on last fault | 16#1C20 = 7200 | 16#202A/1 | 16#5FB9/55 | 16#85/01/01 = 133/01/01 | LFT | History parameters | R | WORD (Enumeration) | - |  | - |  |  | 89
ULP0 | Power supply voltage on last fault | 16#1C66 = 7270 | 16#202A/47 | 16#5FB9/94 | 16#85/01/47 = 133/01/71 | - | History parameters | R | UINT (Unsigned16) | 0.1 V |  | [No meas.] (----) ... 6553.5 V |  |  | 90
LCP0 | Motor current on last fault | 16#1C48 = 7240 | 16#202A/29 | 16#5FB9/79 | 16#85/01/29 = 133/01/41 | - | History parameters | R | INT (Signed16) | Refer to programming manual |  | Refer to programming manual |  |  | 91
RFP0 | Output frequency on last fault | 16#1C52 = 7250 | 16#202A/33 | 16#5FB9/82 | 16#85/01/33 = 133/01/51 | - | History parameters | R | INT (Signed16) | 0.1 Hz |  | -3276.7 Hz ... 3276.7 Hz |  |  | 92
THP0 | Motor thermal state on last fault | 16#1C70 = 7280 | 16#202A/51 | 16#5FB9/9D | 16#85/01/51 = 133/01/81 | - | History parameters | R | UINT (Unsigned16) | 1 % |  | 0 % ... 65535 % |  |  | 93
EP0 | Status word on last fault | 16#1C2A = 7210 | 16#202A/B | 16#5FB9/5E | 16#85/01/0B = 133/01/11 | ETA | History parameters | R | WORD (BitString16) | - |  | - |  |  | 94
IP0 | Extended status word on last fault | 16#1C34 = 7220 | 16#202A/15 | 16#5FB9/67 | 16#85/01/15 = 133/01/21 | ETI | History parameters | R | WORD (BitString16) | - |  | - |  |  | 95
CMP0 | Command word on last fault | 16#1C3E = 7230 | 16#202A/1F | 16#5FB9/70 | 16#85/01/1F = 133/01/31 | CMD | History parameters | R | WORD (BitString16) | - |  | - |  |  | 96
DCC0 | Command channel active on last fault | 16#FB2C = 64300 | - | 16#5FBA/08 | - | CNL | History parameters | R | WORD (Enumeration) | - |  | - |  |  | 97
DRC0 | Reference channel active on last fault | 16#FB36 = 64310 | - | 16#5FBA/11 | - | CNL | History parameters | R | WORD (Enumeration) | - |  | - |  |  | 98
CRP0 | Channels active on last fault | 16#1C7A = 7290 | 16#202A/5B | 16#5FB9/A6 | 16#85/01/5B = 133/01/91 | CRP0 | History parameters | R | WORD (BitString16) | - |  | - |  |  | 99
RTP0 | Motor operating time on last fault | 16#1C5C = 7260 | 16#202A/3D | 16#5FB9/8B | 16#85/01/3D = 133/01/61 | - | History parameters | R | UINT (Unsigned16) | 1 h |  | 0 h ... 65535 h |  |  | 100
MD0 | Date on last fault | 16#1C84 = 7300 | 16#202B/1 | 16#5FB9/AF | 16#85/01/65 = 133/01/101 | - | History parameters | R | UINT (Unsigned16) | 1 |  | 0 ... 65535 |  |  | 101
DM0 | Time on last fault | 16#1C8E = 7310 | 16#202B/B | 16#5FB9/B8 | 16#85/01/6F = 133/01/111 | - | History parameters | R | UINT (Unsigned16) | 1 |  | 0 ... 65535 |  |  | 102
DP1 | Fault code on fault n-1 | 16#1C21 = 7201 | 16#202A/2 | 16#5FB9/56 | 16#85/01/02 = 133/01/02 | LFT | History parameters | R | WORD (Enumeration) | - |  | - |  |  | 103
ULP1 | Supply voltage on fault n-1 | 16#1C67 = 7271 | 16#202A/48 | 16#5FB9/95 | 16#85/01/48 = 133/01/72 | - | History parameters | R | UINT (Unsigned16) | 0.1 V |  | [No meas.] (----) ... 6553.5 V |  |  | 104
LCP1 | Motor current on fault n-1 | 16#1C49 = 7241 | 16#202A/2A | 16#5FB9/7A | 16#85/01/2A = 133/01/42 | - | History parameters | R | INT (Signed16) | Refer to programming manual |  | Refer to programming manual |  |  | 105
RFP1 | Output frequency on fault n-1 | 16#1C53 = 7251 | 16#202A/34 | 16#5FB9/83 | 16#85/01/34 = 133/01/52 | - | History parameters | R | INT (Signed16) | 0.1 Hz |  | -3276.7 Hz ... 3276.7 Hz |  |  | 106
THP1 | Motor thermal state on fault n-1 | 16#1C71 = 7281 | 16#202A/52 | 16#5FB9/9E | 16#85/01/52 = 133/01/82 | - | History parameters | R | UINT (Unsigned16) | 1 % |  | 0 % ... 65535 % |  |  | 107
EP1 | Status word on fault n-1 | 16#1C2B = 7211 | 16#202A/C | 16#5FB9/5F | 16#85/01/0C = 133/01/12 | ETA | History parameters | R | WORD (BitString16) | - |  | - |  |  | 108
IP1 | Extended status word on fault n-1 | 16#1C35 = 7221 | 16#202A/16 | 16#5FB9/68 | 16#85/01/16 = 133/01/22 | ETI | History parameters | R | WORD (BitString16) | - |  | - |  |  | 109
CMP1 | Command word on fault n-1 | 16#1C3F = 7231 | 16#202A/20 | 16#5FB9/71 | 16#85/01/20 = 133/01/32 | CMD | History parameters | R | WORD (BitString16) | - |  | - |  |  | 110
DCC1 | Active command channel on fault n-1 | 16#FB2D = 64301 | - | 16#5FBA/09 | - | CNL | History parameters | R | WORD (Enumeration) | - |  | - |  |  | 111
DRC1 | Active reference channel on fault n-1 | 16#FB37 = 64311 | - | 16#5FBA/12 | - | CNL | History parameters | R | WORD (Enumeration) | - |  | - |  |  | 112
CRP1 | Active channels on fault n-1 | 16#1C7B = 7291 | 16#202A/5C | 16#5FB9/A7 | 16#85/01/5C = 133/01/92 | CRP0 | History parameters | R | WORD (BitString16) | - |  | - |  |  | 113
RTP1 | Motor operating time on fault n-1 | 16#1C5D = 7261 | 16#202A/3E | 16#5FB9/8C | 16#85/01/3E = 133/01/62 | - | History parameters | R | UINT (Unsigned16) | 1 h |  | 0 h ... 65535 h |  |  | 114
MD1 | Date on fault n-1 | 16#1C85 = 7301 | 16#202B/2 | 16#5FB9/B0 | 16#85/01/66 = 133/01/102 | - | History parameters | R | UINT (Unsigned16) | 1 |  | 0 ... 65535 |  |  | 115
DM1 | Time on fault n-1 | 16#1C8F = 7311 | 16#202B/C | 16#5FB9/B9 | 16#85/01/70 = 133/01/112 | - | History parameters | R | UINT (Unsigned16) | 1 |  | 0 ... 65535 |  |  | 116
DP2 | Fault code on fault n-2 | 16#1C22 = 7202 | 16#202A/3 | 16#5FB9/57 | 16#85/01/03 = 133/01/03 | LFT | History parameters | R | WORD (Enumeration) | - |  | - |  |  | 117
ULP2 | Supply voltage on fault n-2 | 16#1C68 = 7272 | 16#202A/49 | 16#5FB9/96 | 16#85/01/49 = 133/01/73 | - | History parameters | R | UINT (Unsigned16) | 0.1 V |  | [No meas.] (----) ... 6553.5 V |  |  | 118
LCP2 | Motor current on fault n-2 | 16#1C4A = 7242 | 16#202A/2B | 16#5FB9/7B | 16#85/01/2B = 133/01/43 | - | History parameters | R | INT (Signed16) | Refer to programming manual |  | Refer to programming manual |  |  | 119
RFP2 | Output frequency on fault n-2 | 16#1C54 = 7252 | 16#202A/35 | 16#5FB9/84 | 16#85/01/35 = 133/01/53 | - | History parameters | R | INT (Signed16) | 0.1 Hz |  | -3276.7 Hz ... 3276.7 Hz |  |  | 120
THP2 | Motor thermal state on fault n-2 | 16#1C72 = 7282 | 16#202A/53 | 16#5FB9/9F | 16#85/01/53 = 133/01/83 | - | History parameters | R | UINT (Unsigned16) | 1 % |  | 0 % ... 65535 % |  |  | 121
EP2 | Status word on fault n-2 | 16#1C2C = 7212 | 16#202A/D | 16#5FB9/60 | 16#85/01/0D = 133/01/13 | ETA | History parameters | R | WORD (BitString16) | - |  | - |  |  | 122
IP2 | Extended status word on fault n-2 | 16#1C36 = 7222 | 16#202A/17 | 16#5FB9/69 | 16#85/01/17 = 133/01/23 | ETI | History parameters | R | WORD (BitString16) | - |  | - |  |  | 123
CMP2 | Command word on fault n-2 | 16#1C40 = 7232 | 16#202A/21 | 16#5FB9/72 | 16#85/01/21 = 133/01/33 | CMD | History parameters | R | WORD (BitString16) | - |  | - |  |  | 124
DCC2 | Active command channel on fault n-2 | 16#FB2E = 64302 | - | 16#5FBA/0A | - | CNL | History parameters | R | WORD (Enumeration) | - |  | - |  |  | 125
DRC2 | Active reference channel on fault n-2 | 16#FB38 = 64312 | - | 16#5FBA/13 | - | CNL | History parameters | R | WORD (Enumeration) | - |  | - |  |  | 126
CRP2 | Active channels on fault n-2 | 16#1C7C = 7292 | 16#202A/5D | 16#5FB9/A8 | 16#85/01/5D = 133/01/93 | CRP0 | History parameters | R | WORD (BitString16) | - |  | - |  |  | 127
RTP2 | Motor operating time on fault n-2 | 16#1C5E = 7262 | 16#202A/3F | 16#5FB9/8D | 16#85/01/3F = 133/01/63 | - | History parameters | R | UINT (Unsigned16) | 1 h |  | 0 h ... 65535 h |  |  | 128
MD2 | Date on fault n-2 | 16#1C86 = 7302 | 16#202B/3 | 16#5FB9/B1 | 16#85/01/67 = 133/01/103 | - | History parameters | R | UINT (Unsigned16) | 1 |  | 0 ... 65535 |  |  | 129
DM2 | Time on fault n-2 | 16#1C90 = 7312 | 16#202B/D | 16#5FB9/BA | 16#85/01/71 = 133/01/113 | - | History parameters | R | UINT (Unsigned16) | 1 |  | 0 ... 65535 |  |  | 130
DP3 | Fault code on fault n-3 | 16#1C23 = 7203 | 16#202A/4 | 16#5FB9/58 | 16#85/01/04 = 133/01/04 | LFT | History parameters | R | WORD (Enumeration) | - |  | - |  |  | 131
ULP3 | Supply voltage on fault n-3 | 16#1C69 = 7273 | 16#202A/4A | 16#5FB9/97 | 16#85/01/4A = 133/01/74 | - | History parameters | R | UINT (Unsigned16) | 0.1 V |  | [No meas.] (----) ... 6553.5 V |  |  | 132
LCP3 | Motor current on fault n-3 | 16#1C4B = 7243 | 16#202A/2C | 16#5FB9/7C | 16#85/01/2C = 133/01/44 | - | History parameters | R | INT (Signed16) | Refer to programming manual |  | Refer to programming manual |  |  | 133
RFP3 | Output frequency on fault n-3 | 16#1C55 = 7253 | 16#202A/36 | 16#5FB9/85 | 16#85/01/36 = 133/01/54 | - | History parameters | R | INT (Signed16) | 0.1 Hz |  | -3276.7 Hz ... 3276.7 Hz |  |  | 134
THP3 | Motor thermal state on fault n-3 | 16#1C73 = 7283 | 16#202A/54 | 16#5FB9/A0 | 16#85/01/54 = 133/01/84 | - | History parameters | R | UINT (Unsigned16) | 1 % |  | 0 % ... 65535 % |  |  | 135
EP3 | Status word on fault n-3 | 16#1C2D = 7213 | 16#202A/E | 16#5FB9/61 | 16#85/01/0E = 133/01/14 | ETA | History parameters | R | WORD (BitString16) | - |  | - |  |  | 136
IP3 | Extended status word on fault n-3 | 16#1C37 = 7223 | 16#202A/18 | 16#5FB9/6A | 16#85/01/18 = 133/01/24 | ETI | History parameters | R | WORD (BitString16) | - |  | - |  |  | 137
CMP3 | Command word on fault n-3 | 16#1C41 = 7233 | 16#202A/22 | 16#5FB9/73 | 16#85/01/22 = 133/01/34 | CMD | History parameters | R | WORD (BitString16) | - |  | - |  |  | 138
DCC3 | Active command channel on fault n-3 | 16#FB2F = 64303 | - | 16#5FBA/0B | - | CNL | History parameters | R | WORD (Enumeration) | - |  | - |  |  | 139
DRC3 | Active reference channel on fault n-3 | 16#FB39 = 64313 | - | 16#5FBA/14 | - | CNL | History parameters | R | WORD (Enumeration) | - |  | - |  |  | 140
CRP3 | Active channels on fault n-3 | 16#1C7D = 7293 | 16#202A/5E | 16#5FB9/A9 | 16#85/01/5E = 133/01/94 | CRP0 | History parameters | R | WORD (BitString16) | - |  | - |  |  | 141
RTP3 | Motor operating time on fault n-3 | 16#1C5F = 7263 | 16#202A/40 | 16#5FB9/8E | 16#85/01/40 = 133/01/64 | - | History parameters | R | UINT (Unsigned16) | 1 h |  | 0 h ... 65535 h |  |  | 142
MD3 | Date on fault n-3 | 16#1C87 = 7303 | 16#202B/4 | 16#5FB9/B2 | 16#85/01/68 = 133/01/104 | - | History parameters | R | UINT (Unsigned16) | 1 |  | 0 ... 65535 |  |  | 143
DM3 | Time on fault n-3 | 16#1C91 = 7313 | 16#202B/E | 16#5FB9/BB | 16#85/01/72 = 133/01/114 | - | History parameters | R | UINT (Unsigned16) | 1 |  | 0 ... 65535 |  |  | 144
DP4 | Fault code on fault n-4 | 16#1C24 = 7204 | 16#202A/5 | 16#5FB9/59 | 16#85/01/05 = 133/01/05 | LFT | History parameters | R | WORD (Enumeration) | - |  | - |  |  | 145
ULP4 | Supply voltage on fault n-4 | 16#1C6A = 7274 | 16#202A/4B | 16#5FB9/98 | 16#85/01/4B = 133/01/75 | - | History parameters | R | UINT (Unsigned16) | 0.1 V |  | [No meas.] (----) ... 6553.5 V |  |  | 146
LCP4 | Motor current on fault n-4 | 16#1C4C = 7244 | 16#202A/2D | 16#5FB9/7D | 16#85/01/2D = 133/01/45 | - | History parameters | R | INT (Signed16) | Refer to programming manual |  | Refer to programming manual |  |  | 147
RFP4 | Output frequency on fault n-4 | 16#1C56 = 7254 | 16#202A/37 | 16#5FB9/86 | 16#85/01/37 = 133/01/55 | - | History parameters | R | INT (Signed16) | 0.1 Hz |  | -3276.7 Hz ... 3276.7 Hz |  |  | 148
THP4 | Motor thermal state on fault n-4 | 16#1C74 = 7284 | 16#202A/55 | 16#5FB9/A1 | 16#85/01/55 = 133/01/85 | - | History parameters | R | UINT (Unsigned16) | 1 % |  | 0 % ... 65535 % |  |  | 149
EP4 | Status word on fault n-4 | 16#1C2E = 7214 | 16#202A/F | 16#5FB9/62 | 16#85/01/0F = 133/01/15 | ETA | History parameters | R | WORD (BitString16) | - |  | - |  |  | 150
IP4 | Extended status word on fault n-4 | 16#1C38 = 7224 | 16#202A/19 | 16#5FB9/6B | 16#85/01/19 = 133/01/25 | ETI | History parameters | R | WORD (BitString16) | - |  | - |  |  | 151
CMP4 | Command word on fault n-4 | 16#1C42 = 7234 | 16#202A/23 | 16#5FB9/74 | 16#85/01/23 = 133/01/35 | CMD | History parameters | R | WORD (BitString16) | - |  | - |  |  | 152
DCC4 | Active command channel on fault n-4 | 16#FB30 = 64304 | - | 16#5FBA/0C | - | CNL | History parameters | R | WORD (Enumeration) | - |  | - |  |  | 153
DRC4 | Active reference channel on fault n-4 | 16#FB3A = 64314 | - | 16#5FBA/15 | - | CNL | History parameters | R | WORD (Enumeration) | - |  | - |  |  | 154
CRP4 | Active channels on fault n-4 | 16#1C7E = 7294 | 16#202A/5F | 16#5FB9/AA | 16#85/01/5F = 133/01/95 | CRP0 | History parameters | R | WORD (BitString16) | - |  | - |  |  | 155
RTP4 | Motor operating time on fault n-4 | 16#1C60 = 7264 | 16#202A/41 | 16#5FB9/8F | 16#85/01/41 = 133/01/65 | - | History parameters | R | UINT (Unsigned16) | 1 h |  | 0 h ... 65535 h |  |  | 156
MD4 | Date on fault n-4 | 16#1C88 = 7304 | 16#202B/5 | 16#5FB9/B3 | 16#85/01/69 = 133/01/105 | - | History parameters | R | UINT (Unsigned16) | 1 |  | 0 ... 65535 |  |  | 157
DM4 | Time on fault n-4 | 16#1C92 = 7314 | 16#202B/F | 16#5FB9/BC | 16#85/01/73 = 133/01/115 | - | History parameters | R | UINT (Unsigned16) | 1 |  | 0 ... 65535 |  |  | 158
DP5 | Fault code on fault n-5 | 16#1C25 = 7205 | 16#202A/6 | 16#5FB9/5A | 16#85/01/06 = 133/01/06 | LFT | History parameters | R | WORD (Enumeration) | - |  | - |  |  | 159
ULP5 | Supply voltage on fault n-5 | 16#1C6B = 7275 | 16#202A/4C | 16#5FB9/99 | 16#85/01/4C = 133/01/76 | - | History parameters | R | UINT (Unsigned16) | 0.1 V |  | [No meas.] (----) ... 6553.5 V |  |  | 160
LCP5 | Motor current on fault n-5 | 16#1C4D = 7245 | 16#202A/2E | 16#5FB9/7E | 16#85/01/2E = 133/01/46 | - | History parameters | R | INT (Signed16) | Refer to programming manual |  | Refer to programming manual |  |  | 161
RFP5 | Output frequency on fault n-5 | 16#1C57 = 7255 | 16#202A/38 | 16#5FB9/87 | 16#85/01/38 = 133/01/56 | - | History parameters | R | INT (Signed16) | 0.1 Hz |  | -3276.7 Hz ... 3276.7 Hz |  |  | 162
THP5 | Motor thermal state on fault n-5 | 16#1C75 = 7285 | 16#202A/56 | 16#5FB9/A2 | 16#85/01/56 = 133/01/86 | - | History parameters | R | UINT (Unsigned16) | 1 % |  | 0 % ... 65535 % |  |  | 163
EP5 | Status word on fault n-5 | 16#1C2F = 7215 | 16#202A/10 | 16#5FB9/63 | 16#85/01/10 = 133/01/16 | ETA | History parameters | R | WORD (BitString16) | - |  | - |  |  | 164
IP5 | Extended status word on fault n-5 | 16#1C39 = 7225 | 16#202A/1A | 16#5FB9/6C | 16#85/01/1A = 133/01/26 | ETI | History parameters | R | WORD (BitString16) | - |  | - |  |  | 165
CMP5 | Command word on fault n-5 | 16#1C43 = 7235 | 16#202A/24 | 16#5FB9/75 | 16#85/01/24 = 133/01/36 | CMD | History parameters | R | WORD (BitString16) | - |  | - |  |  | 166
DCC5 | Active command channel on fault n-5 | 16#FB31 = 64305 | - | 16#5FBA/0D | - | CNL | History parameters | R | WORD (Enumeration) | - |  | - |  |  | 167
DRC5 | Active reference channel on fault n-5 | 16#FB3B = 64315 | - | 16#5FBA/16 | - | CNL | History parameters | R | WORD (Enumeration) | - |  | - |  |  | 168
CRP5 | Active channels on fault n-5 | 16#1C7F = 7295 | 16#202A/60 | 16#5FB9/AB | 16#85/01/60 = 133/01/96 | CRP0 | History parameters | R | WORD (BitString16) | - |  | - |  |  | 169
RTP5 | Motor operating time on fault n-5 | 16#1C61 = 7265 | 16#202A/42 | 16#5FB9/90 | 16#85/01/42 = 133/01/66 | - | History parameters | R | UINT (Unsigned16) | 1 h |  | 0 h ... 65535 h |  |  | 170
MD5 | Date on fault n-5 | 16#1C89 = 7305 | 16#202B/6 | 16#5FB9/B4 | 16#85/01/6A = 133/01/106 | - | History parameters | R | UINT (Unsigned16) | 1 |  | 0 ... 65535 |  |  | 171
DM5 | Time on fault n-5 | 16#1C93 = 7315 | 16#202B/10 | 16#5FB9/BD | 16#85/01/74 = 133/01/116 | - | History parameters | R | UINT (Unsigned16) | 1 |  | 0 ... 65535 |  |  | 172
DP6 | Fault code on fault n-6 | 16#1C26 = 7206 | 16#202A/7 | 16#5FB9/5B | 16#85/01/07 = 133/01/07 | LFT | History parameters | R | WORD (Enumeration) | - |  | - |  |  | 173
ULP6 | Supply voltage on fault n-6 | 16#1C6C = 7276 | 16#202A/4D | 16#5FB9/9A | 16#85/01/4D = 133/01/77 | - | History parameters | R | UINT (Unsigned16) | 0.1 V |  | [No meas.] (----) ... 6553.5 V |  |  | 174
LCP6 | Motor current on fault n-6 | 16#1C4E = 7246 | 16#202A/2F | 16#5FB9/7F | 16#85/01/2F = 133/01/47 | - | History parameters | R | INT (Signed16) | Refer to programming manual |  | Refer to programming manual |  |  | 175
RFP6 | Output frequency on fault n-6 | 16#1C58 = 7256 | 16#202A/39 | 16#5FB9/88 | 16#85/01/39 = 133/01/57 | - | History parameters | R | INT (Signed16) | 0.1 Hz |  | -3276.7 Hz ... 3276.7 Hz |  |  | 176
THP6 | Motor thermal state on fault n-6 | 16#1C76 = 7286 | 16#202A/57 | 16#5FB9/A3 | 16#85/01/57 = 133/01/87 | - | History parameters | R | UINT (Unsigned16) | 1 % |  | 0 % ... 65535 % |  |  | 177
EP6 | Status word on fault n-6 | 16#1C30 = 7216 | 16#202A/11 | 16#5FB9/64 | 16#85/01/11 = 133/01/17 | ETA | History parameters | R | WORD (BitString16) | - |  | - |  |  | 178
IP6 | Extended status word on fault n-6 | 16#1C3A = 7226 | 16#202A/1B | 16#5FB9/6D | 16#85/01/1B = 133/01/27 | ETI | History parameters | R | WORD (BitString16) | - |  | - |  |  | 179
CMP6 | Command word on fault n-6 | 16#1C44 = 7236 | 16#202A/25 | 16#5FB9/76 | 16#85/01/25 = 133/01/37 | CMD | History parameters | R | WORD (BitString16) | - |  | - |  |  | 180
DCC6 | Active command channel on fault n-6 | 16#FB32 = 64306 | - | 16#5FBA/0E | - | CNL | History parameters | R | WORD (Enumeration) | - |  | - |  |  | 181
DRC6 | Active reference channel on fault n-6 | 16#FB3C = 64316 | - | 16#5FBA/17 | - | CNL | History parameters | R | WORD (Enumeration) | - |  | - |  |  | 182
CRP6 | Active channels on fault n-6 | 16#1C80 = 7296 | 16#202A/61 | 16#5FB9/AC | 16#85/01/61 = 133/01/97 | CRP0 | History parameters | R | WORD (BitString16) | - |  | - |  |  | 183
RTP6 | Motor operating time on fault n-6 | 16#1C62 = 7266 | 16#202A/43 | 16#5FB9/91 | 16#85/01/43 = 133/01/67 | - | History parameters | R | UINT (Unsigned16) | 1 h |  | 0 h ... 65535 h |  |  | 184
MD6 | Date on fault n-6 | 16#1C8A = 7306 | 16#202B/7 | 16#5FB9/B5 | 16#85/01/6B = 133/01/107 | - | History parameters | R | UINT (Unsigned16) | 1 |  | 0 ... 65535 |  |  | 185
DM6 | Time on fault n-6 | 16#1C94 = 7316 | 16#202B/11 | 16#5FB9/BE | 16#85/01/75 = 133/01/117 | - | History parameters | R | UINT (Unsigned16) | 1 |  | 0 ... 65535 |  |  | 186
DP7 | Fault code on fault n-7 | 16#1C27 = 7207 | 16#202A/8 | 16#5FB9/5C | 16#85/01/08 = 133/01/08 | LFT | History parameters | R | WORD (Enumeration) | - |  | - |  |  | 187
ULP7 | Supply voltage on fault n-7 | 16#1C6D = 7277 | 16#202A/4E | 16#5FB9/9B | 16#85/01/4E = 133/01/78 | - | History parameters | R | UINT (Unsigned16) | 0.1 V |  | [No meas.] (----) ... 6553.5 V |  |  | 188
LCP7 | Motor current on fault n-7 | 16#1C4F = 7247 | 16#202A/30 | 16#5FB9/80 | 16#85/01/30 = 133/01/48 | - | History parameters | R | INT (Signed16) | Refer to programming manual |  | Refer to programming manual |  |  | 189
RFP7 | Output frequency on fault n-7 | 16#1C59 = 7257 | 16#202A/3A | 16#5FB9/89 | 16#85/01/3A = 133/01/58 | - | History parameters | R | INT (Signed16) | 0.1 Hz |  | -3276.7 Hz ... 3276.7 Hz |  |  | 190
THP7 | Motor thermal state on fault n-7 | 16#1C77 = 7287 | 16#202A/58 | 16#5FB9/A4 | 16#85/01/58 = 133/01/88 | - | History parameters | R | UINT (Unsigned16) | 1 % |  | 0 % ... 65535 % |  |  | 191
EP7 | Status word on fault n-7 | 16#1C31 = 7217 | 16#202A/12 | 16#5FB9/65 | 16#85/01/12 = 133/01/18 | ETA | History parameters | R | WORD (BitString16) | - |  | - |  |  | 192
IP7 | Extended status word on fault n-7 | 16#1C3B = 7227 | 16#202A/1C | 16#5FB9/6E | 16#85/01/1C = 133/01/28 | ETI | History parameters | R | WORD (BitString16) | - |  | - |  |  | 193
CMP7 | Command word on fault n-7 | 16#1C45 = 7237 | 16#202A/26 | 16#5FB9/77 | 16#85/01/26 = 133/01/38 | CMD | History parameters | R | WORD (BitString16) | - |  | - |  |  | 194
DCC7 | Active command channel on fault n-7 | 16#FB33 = 64307 | - | 16#5FBA/0F | - | CNL | History parameters | R | WORD (Enumeration) | - |  | - |  |  | 195
DRC7 | Active reference channel on fault n-7 | 16#FB3D = 64317 | - | 16#5FBA/18 | - | CNL | History parameters | R | WORD (Enumeration) | - |  | - |  |  | 196
CRP7 | Active channels on fault n-7 | 16#1C81 = 7297 | 16#202A/62 | 16#5FB9/AD | 16#85/01/62 = 133/01/98 | CRP0 | History parameters | R | WORD (BitString16) | - |  | - |  |  | 197
RTP7 | Motor operating time on fault n-7 | 16#1C63 = 7267 | 16#202A/44 | 16#5FB9/92 | 16#85/01/44 = 133/01/68 | - | History parameters | R | UINT (Unsigned16) | 1 h |  | 0 h ... 65535 h |  |  | 198
MD7 | Date on fault n-7 | 16#1C8B = 7307 | 16#202B/8 | 16#5FB9/B6 | 16#85/01/6C = 133/01/108 | - | History parameters | R | UINT (Unsigned16) | 1 |  | 0 ... 65535 |  |  | 199
DM7 | Time on fault n-7 | 16#1C95 = 7317 | 16#202B/12 | 16#5FB9/BF | 16#85/01/76 = 133/01/118 | - | History parameters | R | UINT (Unsigned16) | 1 |  | 0 ... 65535 |  |  | 200
DP8 | Fault code on fault n-8 | 16#1C28 = 7208 | 16#202A/9 | 16#5FB9/5D | 16#85/01/09 = 133/01/09 | LFT | History parameters | R | WORD (Enumeration) | - |  | - |  |  | 201
ULP8 | Supply voltage on fault n-8 | 16#1C6E = 7278 | 16#202A/4F | 16#5FB9/9C | 16#85/01/4F = 133/01/79 | - | History parameters | R | UINT (Unsigned16) | 0.1 V |  | [No meas.] (----) ... 6553.5 V |  |  | 202
LCP8 | Motor current on fault n-8 | 16#1C50 = 7248 | 16#202A/31 | 16#5FB9/81 | 16#85/01/31 = 133/01/49 | - | History parameters | R | INT (Signed16) | Refer to programming manual |  | Refer to programming manual |  |  | 203
RFP8 | Output frequency on fault n-8 | 16#1C5A = 7258 | 16#202A/3B | 16#5FB9/8A | 16#85/01/3B = 133/01/59 | - | History parameters | R | INT (Signed16) | 0.1 Hz |  | -3276.7 Hz ... 3276.7 Hz |  |  | 204
THP8 | Motor thermal state on fault n-8 | 16#1C78 = 7288 | 16#202A/59 | 16#5FB9/A5 | 16#85/01/59 = 133/01/89 | - | History parameters | R | UINT (Unsigned16) | 1 % |  | 0 % ... 65535 % |  |  | 205
EP8 | Status word on fault n-8 | 16#1C32 = 7218 | 16#202A/13 | 16#5FB9/66 | 16#85/01/13 = 133/01/19 | ETA | History parameters | R | WORD (BitString16) | - |  | - |  |  | 206
IP8 | Extended status word on fault n-8 | 16#1C3C = 7228 | 16#202A/1D | 16#5FB9/6F | 16#85/01/1D = 133/01/29 | ETI | History parameters | R | WORD (BitString16) | - |  | - |  |  | 207
CMP8 | Command word on fault n-8 | 16#1C46 = 7238 | 16#202A/27 | 16#5FB9/78 | 16#85/01/27 = 133/01/39 | CMD | History parameters | R | WORD (BitString16) | - |  | - |  |  | 208
DCC8 | Active command channel on fault n-8 | 16#FB34 = 64308 | - | 16#5FBA/10 | - | CNL | History parameters | R | WORD (Enumeration) | - |  | - |  |  | 209
DRC8 | Active reference channel on fault n-8 | 16#FB3E = 64318 | - | 16#5FBA/19 | - | CNL | History parameters | R | WORD (Enumeration) | - |  | - |  |  | 210
CRP8 | Active channels on fault n-8 | 16#1C82 = 7298 | 16#202A/63 | 16#5FB9/AE | 16#85/01/63 = 133/01/99 | CRP0 | History parameters | R | WORD (BitString16) | - |  | - |  |  | 211
RTP8 | Motor operating time on fault n-8 | 16#1C64 = 7268 | 16#202A/45 | 16#5FB9/93 | 16#85/01/45 = 133/01/69 | - | History parameters | R | UINT (Unsigned16) | 1 h |  | 0 h ... 65535 h |  |  | 212
MD8 | Date on fault n-8 | 16#1C8C = 7308 | 16#202B/9 | 16#5FB9/B7 | 16#85/01/6D = 133/01/109 | - | History parameters | R | UINT (Unsigned16) | 1 |  | 0 ... 65535 |  |  | 213
DM8 | Time on fault n-8 | 16#1C96 = 7318 | 16#202B/13 | 16#5FB9/C0 | 16#85/01/77 = 133/01/119 | - | History parameters | R | UINT (Unsigned16) | 1 |  | 0 ... 65535 |  |  | 214
NCV | Drive nominal rating | 16#0BC3 = 3011 | 16#2000/C | 16#5FB0/02 | 16#70/01/0C = 112/01/12 | NCV | Identification parameters | R | WORD (Enumeration) | - | [Unknown rating] (nO) | - |  |  | 215
VCAL | Drive line voltage | 16#0BC4 = 3012 | 16#2000/D | 16#5FB0/03 | 16#70/01/0D = 112/01/13 | VCAL | Identification parameters | R | WORD (Enumeration) | - | [No] (nO) | - |  |  | 216
INV | Rated drive current | 16#0BC9 = 3017 | 16#2000/12 | 16#5FB0/07 | 16#70/01/12 = 112/01/18 | - | Identification parameters | R | UINT (Unsigned16) | Refer to programming manual | Depends of rating | - |  |  | 217
VDP | Drive software version | 16#0CE6 = 3302 | 16#2003/3 | 16#5FB0/0D | 16#71/01/67 = 113/01/103 | - | Identification parameters | R | UINT (Unsigned16) | 1 |  | 0 ... 65535 |  |  | 218
PAN0 | Device name (char 1 and 2) | 16#0D0C = 3340 | 16#2003/29 | 16#5FB0/25 | 16#71/01/8D = 113/01/141 | - | Identification parameters | R/W | UINT (Unsigned16) | 1 | 0 | 0 ... 65535 |  |  | 219
PAN1 | Device name (char 3 and 4) | 16#0D0D = 3341 | 16#2003/2A | 16#5FB0/26 | 16#71/01/8E = 113/01/142 | - | Identification parameters | R/W | UINT (Unsigned16) | 1 | 0 | 0 ... 65535 |  |  | 220
PAN2 | Device name (char 5 and 6) | 16#0D0E = 3342 | 16#2003/2B | 16#5FB0/27 | 16#71/01/8F = 113/01/143 | - | Identification parameters | R/W | UINT (Unsigned16) | 1 | 0 | 0 ... 65535 |  |  | 221
PAN3 | Device name (char 7 and 8) | 16#0D0F = 3343 | 16#2003/2C | 16#5FB0/28 | 16#71/01/90 = 113/01/144 | - | Identification parameters | R/W | UINT (Unsigned16) | 1 | 0 | 0 ... 65535 |  |  | 222
PAN4 | Device name (char 9 and 10) | 16#0D10 = 3344 | 16#2003/2D | 16#5FB0/29 | 16#71/01/91 = 113/01/145 | - | Identification parameters | R/W | UINT (Unsigned16) | 1 | 0 | 0 ... 65535 |  |  | 223
PAN5 | Device name (char 11 and 12) | 16#0D11 = 3345 | 16#2003/2E | 16#5FB0/2A | 16#71/01/92 = 113/01/146 | - | Identification parameters | R/W | UINT (Unsigned16) | 1 | 0 | 0 ... 65535 |  |  | 224
PAN6 | Device name (char 13 and 14) | 16#0D12 = 3346 | 16#2003/2F | 16#5FB0/2B | 16#71/01/93 = 113/01/147 | - | Identification parameters | R/W | UINT (Unsigned16) | 1 | 0 | 0 ... 65535 |  |  | 225
PAN7 | Device name (char 15 and 16) | 16#0D13 = 3347 | 16#2003/30 | 16#5FB0/2C | 16#71/01/94 = 113/01/148 | - | Identification parameters | R/W | UINT (Unsigned16) | 1 | 0 | 0 ... 65535 |  |  | 226
PAV1 | Controller name (char 1 and 2) | 16#1B45 = 6981 | 16#2027/52 | 16#5FB0/A4 | 16#83/01/B6 = 131/01/182 | - | Identification parameters | R/W | UINT (Unsigned16) | 1 | 0 | 0 ... 65535 |  |  | 227
PAV2 | Controller name (char 3 and 4) | 16#1B46 = 6982 | 16#2027/53 | 16#5FB0/A5 | 16#83/01/B7 = 131/01/183 | - | Identification parameters | R/W | UINT (Unsigned16) | 1 | 0 | 0 ... 65535 |  |  | 228
PAV3 | Controller name (char 5 and 6) | 16#1B47 = 6983 | 16#2027/54 | 16#5FB0/A6 | 16#83/01/B8 = 131/01/184 | - | Identification parameters | R/W | UINT (Unsigned16) | 1 | 0 | 0 ... 65535 |  |  | 229
PAV4 | Controller name (char 7 and 8) | 16#1B48 = 6984 | 16#2027/55 | 16#5FB0/A7 | 16#83/01/B9 = 131/01/185 | - | Identification parameters | R/W | UINT (Unsigned16) | 1 | 0 | 0 ... 65535 |  |  | 230
PAV5 | Controller name (char 9 and 10) | 16#1B49 = 6985 | 16#2027/56 | 16#5FB0/A8 | 16#83/01/BA = 131/01/186 | - | Identification parameters | R/W | UINT (Unsigned16) | 1 | 0 | 0 ... 65535 |  |  | 231
PAV6 | Controller name (char 11 and 12) | 16#1B4A = 6986 | 16#2027/57 | 16#5FB0/A9 | 16#83/01/BB = 131/01/187 | - | Identification parameters | R/W | UINT (Unsigned16) | 1 | 0 | 0 ... 65535 |  |  | 232
PAV7 | Controller name (char 13 and 14) | 16#1B4B = 6987 | 16#2027/58 | 16#5FB0/AA | 16#83/01/BC = 131/01/188 | - | Identification parameters | R/W | UINT (Unsigned16) | 1 | 0 | 0 ... 65535 |  |  | 233
PAV8 | Controller name (char 15 and 16) | 16#1B4C = 6988 | 16#2027/59 | 16#5FB0/AB | 16#83/01/BD = 131/01/189 | - | Identification parameters | R/W | UINT (Unsigned16) | 1 | 0 | 0 ... 65535 |  |  | 234
NC1 | Communication scanner, value of write word 1 | 16#31D9 = 12761 | 16#2061/3E | 16#5FB6/4B | 16#A0/01/A2 = 160/01/162 | - | Communication parameters | R | UINT (Unsigned16) | 1 |  | 0 ... 65535 | [Com Scan Out1 val.] (nC1) | [COM SCAN OUTPUT MAP] (OSA-) | 235
NC2 | Communication scanner, value of write word 2 | 16#31DA = 12762 | 16#2061/3F | 16#5FB6/4C | 16#A0/01/A3 = 160/01/163 | - | Communication parameters | R | UINT (Unsigned16) | 1 |  | 0 ... 65535 | [Com Scan Out2 val.] (nC2) | [COM SCAN OUTPUT MAP] (OSA-) | 236
NC3 | Communication scanner, value of write word 3 | 16#31DB = 12763 | 16#2061/40 | 16#5FB6/4D | 16#A0/01/A4 = 160/01/164 | - | Communication parameters | R | UINT (Unsigned16) | 1 |  | 0 ... 65535 | [Com Scan Out3 val.] (nC3) | [COM SCAN OUTPUT MAP] (OSA-) | 237
NC4 | Communication scanner, value of write word 4 | 16#31DC = 12764 | 16#2061/41 | 16#5FB6/4E | 16#A0/01/A5 = 160/01/165 | - | Communication parameters | R | UINT (Unsigned16) | 1 |  | 0 ... 65535 | [Com Scan Out4 val.] (nC4) | [COM SCAN OUTPUT MAP] (OSA-) | 238
NC5 | Communication scanner, value of write word 5 | 16#31DD = 12765 | 16#2061/42 | 16#5FB6/4F | 16#A0/01/A6 = 160/01/166 | - | Communication parameters | R | UINT (Unsigned16) | 1 |  | 0 ... 65535 | [Com Scan Out5 val.] (nC5) | [COM SCAN OUTPUT MAP] (OSA-) | 239
NC6 | Communication scanner, value of write word 6 | 16#31DE = 12766 | 16#2061/43 | 16#5FB6/50 | 16#A0/01/A7 = 160/01/167 | - | Communication parameters | R | UINT (Unsigned16) | 1 |  | 0 ... 65535 | [Com Scan Out6 val.] (nC6) | [COM SCAN OUTPUT MAP] (OSA-) | 240
NC7 | Communication scanner, value of write word 7 | 16#31DF = 12767 | 16#2061/44 | 16#5FB6/51 | 16#A0/01/A8 = 160/01/168 | - | Communication parameters | R | UINT (Unsigned16) | 1 |  | 0 ... 65535 | [Com Scan Out7 val.] (nC7) | [COM SCAN OUTPUT MAP] (OSA-) | 241
NC8 | Communication scanner, value of write word 8 | 16#31E0 = 12768 | 16#2061/45 | 16#5FB6/52 | 16#A0/01/A9 = 160/01/169 | - | Communication parameters | R | UINT (Unsigned16) | 1 |  | 0 ... 65535 | [Com Scan Out8 val.] (nC8) | [COM SCAN OUTPUT MAP] (OSA-) | 242
NM1 | Communication scanner, value of read word 1 | 16#31C5 = 12741 | 16#2061/2A | 16#5FB6/43 | 16#A0/01/8E = 160/01/142 | - | Communication parameters | R | UINT (Unsigned16) | 1 |  | 0 ... 65535 | [Com Scan In1 val.] (nM1) | [COM. SCANNER INPUT MAP] (ISA-) | 243
NM2 | Communication scanner, value of read word 2 | 16#31C6 = 12742 | 16#2061/2B | 16#5FB6/44 | 16#A0/01/8F = 160/01/143 | - | Communication parameters | R | UINT (Unsigned16) | 1 |  | 0 ... 65535 | [Com Scan In2 val.] (nM2) | [COM. SCANNER INPUT MAP] (ISA-) | 244
NM3 | Communication scanner, value of read word 3 | 16#31C7 = 12743 | 16#2061/2C | 16#5FB6/45 | 16#A0/01/90 = 160/01/144 | - | Communication parameters | R | UINT (Unsigned16) | 1 |  | 0 ... 65535 | [Com Scan In3 val.] (nM3) | [COM. SCANNER INPUT MAP] (ISA-) | 245
NM4 | Communication scanner, value of read word 4 | 16#31C8 = 12744 | 16#2061/2D | 16#5FB6/46 | 16#A0/01/91 = 160/01/145 | - | Communication parameters | R | UINT (Unsigned16) | 1 |  | 0 ... 65535 | [Com Scan In4 val.] (nM4) | [COM. SCANNER INPUT MAP] (ISA-) | 246
NM5 | Communication scanner, value of read word 5 | 16#31C9 = 12745 | 16#2061/2E | 16#5FB6/47 | 16#A0/01/92 = 160/01/146 | - | Communication parameters | R | UINT (Unsigned16) | 1 |  | 0 ... 65535 | [Com Scan In5 val.] (nM5) | [COM. SCANNER INPUT MAP] (ISA-) | 247
NM6 | Communication scanner, value of read word 6 | 16#31CA = 12746 | 16#2061/2F | 16#5FB6/48 | 16#A0/01/93 = 160/01/147 | - | Communication parameters | R | UINT (Unsigned16) | 1 |  | 0 ... 65535 | [Com Scan In6 val.] (nM6) | [COM. SCANNER INPUT MAP] (ISA-) | 248
NM7 | Communication scanner, value of read word 7 | 16#31CB = 12747 | 16#2061/30 | 16#5FB6/49 | 16#A0/01/94 = 160/01/148 | - | Communication parameters | R | UINT (Unsigned16) | 1 |  | 0 ... 65535 | [Com Scan In7 val.] (nM7) | [COM. SCANNER INPUT MAP] (ISA-) | 249
NM8 | Communication scanner, value of read word 8 | 16#31CC = 12748 | 16#2061/31 | 16#5FB6/4A | 16#A0/01/95 = 160/01/149 | - | Communication parameters | R | UINT (Unsigned16) | 1 |  | 0 ... 65535 | [Com Scan In8 val.] (nM8) | [COM. SCANNER INPUT MAP] (ISA-) | 250
ECSA | EtherCAT Second Address | 16#1A23 = 6691 | 16#2024/5C | 16#5FCB/14 | 16#82/01/5C = 130/01/92 | - | Communication parameters | R/W | UINT (Unsigned16) | 1 | 0 | 0 ... 65535 | [EthCat 2nd addr] (ECSA) | [COMMUNICATION CARD] (Cbd-) | 251
O01 | Controller Inside HMI word 1 | 16#1901 = 6401 | 16#2022/2 | 16#5FC8/01 | 16#81/01/02 = 129/01/02 | - | Controller Inside parameters | R/W | UINT (Unsigned16) | 1 | 0 | 0 ... 65535 | (O01) | [CONTROL. INSIDE CARD] (PLC-) | 252
O02 | Controller Inside HMI word 2 | 16#1902 = 6402 | 16#2022/3 | 16#5FC8/02 | 16#81/01/03 = 129/01/03 | - | Controller Inside parameters | R/W | UINT (Unsigned16) | 1 | 0 | 0 ... 65535 | (O02) | [CONTROL. INSIDE CARD] (PLC-) [MONITORING] (SUP-) | 253
O03 | Controller Inside HMI word 3 | 16#1903 = 6403 | 16#2022/4 | 16#5FC8/03 | 16#81/01/04 = 129/01/04 | - | Controller Inside parameters | R/W | UINT (Unsigned16) | 1 | 0 | 0 ... 65535 | (O03) | [CONTROL. INSIDE CARD] (PLC-) [MONITORING] (SUP-) | 254
O04 | Controller Inside HMI word 4 | 16#1904 = 6404 | 16#2022/5 | 16#5FC8/04 | 16#81/01/05 = 129/01/05 | - | Controller Inside parameters | R/W | UINT (Unsigned16) | 1 | 0 | 0 ... 65535 | (O04) | [CONTROL. INSIDE CARD] (PLC-) [MONITORING] (SUP-) | 255
O05 | Controller Inside HMI word 5 | 16#1905 = 6405 | 16#2022/6 | 16#5FC8/05 | 16#81/01/06 = 129/01/06 | - | Controller Inside parameters | R/W | UINT (Unsigned16) | 1 | 0 | 0 ... 65535 | (O05) | [CONTROL. INSIDE CARD] (PLC-) [MONITORING] (SUP-) | 256
O06 | Controller Inside HMI word 6 | 16#1906 = 6406 | 16#2022/7 | 16#5FC8/06 | 16#81/01/07 = 129/01/07 | - | Controller Inside parameters | R/W | UINT (Unsigned16) | 1 | 0 | 0 ... 65535 | (O06) | [CONTROL. INSIDE CARD] (PLC-) [MONITORING] (SUP-) | 257
O07 | Controller Inside HMI word 7 | 16#1907 = 6407 | 16#2022/8 | 16#5FC8/07 | 16#81/01/08 = 129/01/08 | - | Controller Inside parameters | R/W | UINT (Unsigned16) | 1 | 0 | 0 ... 65535 | (O07) | [CONTROL. INSIDE CARD] (PLC-) | 258
O08 | Controller Inside HMI word 8 | 16#1908 = 6408 | 16#2022/9 | 16#5FC8/08 | 16#81/01/09 = 129/01/09 | - | Controller Inside parameters | R/W | UINT (Unsigned16) | 1 | 0 | 0 ... 65535 | (O08) | [CONTROL. INSIDE CARD] (PLC-) | 259
O09 | Controller Inside HMI word 9 | 16#1909 = 6409 | 16#2022/A | 16#5FC8/09 | 16#81/01/0A = 129/01/10 | - | Controller Inside parameters | R/W | UINT (Unsigned16) | 1 | 0 | 0 ... 65535 | (O09) | [CONTROL. INSIDE CARD] (PLC-) | 260
O10 | Controller Inside HMI word 10 | 16#190A = 6410 | 16#2022/B | 16#5FC8/0A | 16#81/01/0B = 129/01/11 | - | Controller Inside parameters | R/W | UINT (Unsigned16) | 1 | 0 | 0 ... 65535 | (O10) | [CONTROL. INSIDE CARD] (PLC-) | 261
O11 | Controller Inside HMI word 11 | 16#190B = 6411 | 16#2022/C | 16#5FC8/0B | 16#81/01/0C = 129/01/12 | - | Controller Inside parameters | R/W | UINT (Unsigned16) | 1 | 0 | 0 ... 65535 | (O11) | [CONTROL. INSIDE CARD] (PLC-) | 262
O12 | Controller Inside HMI word 12 | 16#190C = 6412 | 16#2022/D | 16#5FC8/0C | 16#81/01/0D = 129/01/13 | - | Controller Inside parameters | R/W | UINT (Unsigned16) | 0.1 | 0.0 | 0.0 ... 6553.5 | (O12) | [CONTROL. INSIDE CARD] (PLC-) | 263
O13 | Controller Inside HMI word 13 | 16#190D = 6413 | 16#2022/E | 16#5FC8/0D | 16#81/01/0E = 129/01/14 | - | Controller Inside parameters | R/W | UINT (Unsigned16) | 0.1 | 0.0 | 0.0 ... 6553.5 | (O13) | [CONTROL. INSIDE CARD] (PLC-) | 264
O14 | Controller Inside HMI word 14 | 16#190E = 6414 | 16#2022/F | 16#5FC8/0E | 16#81/01/0F = 129/01/15 | - | Controller Inside parameters | R/W | UINT (Unsigned16) | 0.1 | 0.0 | 0.0 ... 6553.5 | (O14) | [CONTROL. INSIDE CARD] (PLC-) | 265
O15 | Controller Inside HMI word 15 | 16#190F = 6415 | 16#2022/10 | 16#5FC8/0F | 16#81/01/10 = 129/01/16 | - | Controller Inside parameters | R/W | UINT (Unsigned16) | 0.1 | 0.0 | 0.0 ... 6553.5 | (O15) | [CONTROL. INSIDE CARD] (PLC-) | 266
O16 | Controller Inside HMI word 16 | 16#1910 = 6416 | 16#2022/11 | 16#5FC8/10 | 16#81/01/11 = 129/01/17 | - | Controller Inside parameters | R/W | UINT (Unsigned16) | 0.1 | 0.0 | 0.0 ... 6553.5 | (O16) | [CONTROL. INSIDE CARD] (PLC-) | 267
O17 | Controller Inside HMI word 17 | 16#1911 = 6417 | 16#2022/12 | 16#5FC8/11 | 16#81/01/12 = 129/01/18 | - | Controller Inside parameters | R/W | UINT (Unsigned16) | 0.1 | 0.0 | 0.0 ... 6553.5 | (O17) | [CONTROL. INSIDE CARD] (PLC-) | 268
O18 | Controller Inside HMI word 18 | 16#1912 = 6418 | 16#2022/13 | 16#5FC8/12 | 16#81/01/13 = 129/01/19 | - | Controller Inside parameters | R/W | UINT (Unsigned16) | 0.01 | 0.00 | 0.00 ... 655.35 | (O18) | [CONTROL. INSIDE CARD] (PLC-) | 269
O19 | Controller Inside HMI word 19 | 16#1913 = 6419 | 16#2022/14 | 16#5FC8/13 | 16#81/01/14 = 129/01/20 | - | Controller Inside parameters | R/W | UINT (Unsigned16) | 0.01 | 0.00 | 0.00 ... 655.35 | (O19) | [CONTROL. INSIDE CARD] (PLC-) | 270
O20 | Controller Inside HMI word 20 | 16#1914 = 6420 | 16#2022/15 | 16#5FC8/14 | 16#81/01/15 = 129/01/21 | - | Controller Inside parameters | R/W | UINT (Unsigned16) | 0.01 | 0.00 | 0.00 ... 655.35 | (O20) | [CONTROL. INSIDE CARD] (PLC-) | 271
O21 | Controller Inside HMI word 21 | 16#1915 = 6421 | 16#2022/16 | 16#5FC8/15 | 16#81/01/16 = 129/01/22 | - | Controller Inside parameters | R/W | UINT (Unsigned16) | 0.1 | 0.0 | 0.0 ... 6553.5 | (O21) | [CONTROL. INSIDE CARD] (PLC-) | 272
O22 | Controller Inside HMI word 22 | 16#1916 = 6422 | 16#2022/17 | 16#5FC8/16 | 16#81/01/17 = 129/01/23 | - | Controller Inside parameters | R/W | UINT (Unsigned16) | 0.1 | 0.0 | 0.0 ... 6553.5 | (O22) | [CONTROL. INSIDE CARD] (PLC-) | 273
O23 | Controller Inside HMI word 23 | 16#1917 = 6423 | 16#2022/18 | 16#5FC8/17 | 16#81/01/18 = 129/01/24 | - | Controller Inside parameters | R/W | UINT (Unsigned16) | 0.1 | 0.0 | 0.0 ... 6553.5 | (O23) | [CONTROL. INSIDE CARD] (PLC-) | 274
O24 | Controller Inside HMI word 24 | 16#1918 = 6424 | 16#2022/19 | 16#5FC8/18 | 16#81/01/19 = 129/01/25 | - | Controller Inside parameters | R/W | UINT (Unsigned16) | 0.1 | 0.0 | 0.0 ... 6553.5 | (O24) | [CONTROL. INSIDE CARD] (PLC-) | 275
O25 | Controller Inside HMI word 25 | 16#1919 = 6425 | 16#2022/1A | 16#5FC8/19 | 16#81/01/1A = 129/01/26 | - | Controller Inside parameters | R/W | UINT (Unsigned16) | 0.1 | 0.0 | 0.0 ... 6553.5 | (O25) | [CONTROL. INSIDE CARD] (PLC-) | 276
O26 | Controller Inside HMI word 26 | 16#191A = 6426 | 16#2022/1B | 16#5FC8/1A | 16#81/01/1B = 129/01/27 | - | Controller Inside parameters | R/W | UINT (Unsigned16) | 0.1 | 0.0 | 0.0 ... 6553.5 | (O26) | [CONTROL. INSIDE CARD] (PLC-) | 277
O27 | Controller Inside HMI word 27 | 16#191B = 6427 | 16#2022/1C | 16#5FC8/1B | 16#81/01/1C = 129/01/28 | - | Controller Inside parameters | R/W | UINT (Unsigned16) | 0.1 | 0.0 | 0.0 ... 6553.5 | (O27) | [CONTROL. INSIDE CARD] (PLC-) | 278
O28 | Controller Inside HMI word 28 | 16#191C = 6428 | 16#2022/1D | 16#5FC8/1C | 16#81/01/1D = 129/01/29 | - | Controller Inside parameters | R/W | UINT (Unsigned16) | 0.1 | 0.0 | 0.0 ... 6553.5 | (O28) | [CONTROL. INSIDE CARD] (PLC-) | 279
O29 | Controller Inside HMI word 29 | 16#191D = 6429 | 16#2022/1E | 16#5FC8/1D | 16#81/01/1E = 129/01/30 | - | Controller Inside parameters | R/W | UINT (Unsigned16) | 0.1 | 0.0 | 0.0 ... 6553.5 | (O29) | [CONTROL. INSIDE CARD] (PLC-) | 280
O30 | Controller Inside HMI word 30 | 16#191E = 6430 | 16#2022/1F | 16#5FC8/1E | 16#81/01/1F = 129/01/31 | - | Controller Inside parameters | R/W | UINT (Unsigned16) | 0.1 | 0.0 | 0.0 ... 6553.5 | (O30) | [CONTROL. INSIDE CARD] (PLC-) | 281
O31 | Controller Inside HMI word 31 | 16#191F = 6431 | 16#2022/20 | 16#5FC8/1F | 16#81/01/20 = 129/01/32 | - | Controller Inside parameters | R/W | UINT (Unsigned16) | 0.1 | 0.0 | 0.0 ... 6553.5 | (O31) | [CONTROL. INSIDE CARD] (PLC-) | 282
O32 | Controller Inside HMI word 32 | 16#1920 = 6432 | 16#2022/21 | 16#5FC8/20 | 16#81/01/21 = 129/01/33 | - | Controller Inside parameters | R/W | UINT (Unsigned16) | 0.1 | 0.0 | 0.0 ... 6553.5 | (O32) | [CONTROL. INSIDE CARD] (PLC-) | 283
O33 | Controller Inside HMI word 33 | 16#1921 = 6433 | 16#2022/22 | 16#5FC8/21 | 16#81/01/22 = 129/01/34 | - | Controller Inside parameters | R/W | UINT (Unsigned16) | 0.1 | 0.0 | 0.0 ... 6553.5 | (O33) | [CONTROL. INSIDE CARD] (PLC-) | 284
O34 | Controller Inside HMI word 34 | 16#1922 = 6434 | 16#2022/23 | 16#5FC8/22 | 16#81/01/23 = 129/01/35 | - | Controller Inside parameters | R/W | UINT (Unsigned16) | 0.1 | 0.0 | 0.0 ... 6553.5 | (O34) | [CONTROL. INSIDE CARD] (PLC-) | 285
O35 | Controller Inside HMI word 35 | 16#1923 = 6435 | 16#2022/24 | 16#5FC8/23 | 16#81/01/24 = 129/01/36 | - | Controller Inside parameters | R/W | UINT (Unsigned16) | 0.1 | 0.0 | 0.0 ... 6553.5 | (O35) | [CONTROL. INSIDE CARD] (PLC-) | 286
O36 | Controller Inside HMI word 36 | 16#1924 = 6436 | 16#2022/25 | 16#5FC8/24 | 16#81/01/25 = 129/01/37 | - | Controller Inside parameters | R/W | UINT (Unsigned16) | 0.1 | 0.0 | 0.0 ... 6553.5 | (O36) | [CONTROL. INSIDE CARD] (PLC-) | 287
O37 | Controller Inside HMI word 37 | 16#1925 = 6437 | 16#2022/26 | 16#5FC8/25 | 16#81/01/26 = 129/01/38 | - | Controller Inside parameters | R/W | UINT (Unsigned16) | 0.1 | 0.0 | 0.0 ... 6553.5 | (O37) | [CONTROL. INSIDE CARD] (PLC-) | 288
O38 | Controller Inside HMI word 38 | 16#1926 = 6438 | 16#2022/27 | 16#5FC8/26 | 16#81/01/27 = 129/01/39 | - | Controller Inside parameters | R/W | UINT (Unsigned16) | 0.1 | 0.0 | 0.0 ... 6553.5 | (O38) | [CONTROL. INSIDE CARD] (PLC-) | 289
O39 | Controller Inside HMI word 39 | 16#1927 = 6439 | 16#2022/28 | 16#5FC8/27 | 16#81/01/28 = 129/01/40 | - | Controller Inside parameters | R/W | UINT (Unsigned16) | 0.1 | 0.0 | 0.0 ... 6553.5 | (O39) | [CONTROL. INSIDE CARD] (PLC-) | 290
O40 | Controller Inside HMI word 40 | 16#1928 = 6440 | 16#2022/29 | 16#5FC8/28 | 16#81/01/29 = 129/01/41 | - | Controller Inside parameters | R/W | UINT (Unsigned16) | 0.1 | 0.0 | 0.0 ... 6553.5 | (O40) | [CONTROL. INSIDE CARD] (PLC-) | 291
O41 | Controller Inside HMI word 41 | 16#1929 = 6441 | 16#2022/2A | 16#5FC8/29 | 16#81/01/2A = 129/01/42 | - | Controller Inside parameters | R/W | UINT (Unsigned16) | 0.1 | 0.0 | 0.0 ... 6553.5 | (O41) | [CONTROL. INSIDE CARD] (PLC-) | 292
O42 | Controller Inside HMI word 42 | 16#192A = 6442 | 16#2022/2B | 16#5FC8/2A | 16#81/01/2B = 129/01/43 | - | Controller Inside parameters | R/W | UINT (Unsigned16) | 0.1 | 0.0 | 0.0 ... 6553.5 | (O42) | [CONTROL. INSIDE CARD] (PLC-) | 293
O43 | Controller Inside HMI word 43 | 16#192B = 6443 | 16#2022/2C | 16#5FC8/2B | 16#81/01/2C = 129/01/44 | - | Controller Inside parameters | R/W | UINT (Unsigned16) | 0.1 | 0.0 | 0.0 ... 6553.5 | (O43) | [CONTROL. INSIDE CARD] (PLC-) | 294
O44 | Controller Inside HMI word 44 | 16#192C = 6444 | 16#2022/2D | 16#5FC8/2C | 16#81/01/2D = 129/01/45 | - | Controller Inside parameters | R/W | UINT (Unsigned16) | 0.1 | 0.0 | 0.0 ... 6553.5 | (O44) | [CONTROL. INSIDE CARD] (PLC-) | 295
O45 | Controller Inside HMI word 45 | 16#192D = 6445 | 16#2022/2E | 16#5FC8/2D | 16#81/01/2E = 129/01/46 | - | Controller Inside parameters | R/W | UINT (Unsigned16) | 0.1 | 0.0 | 0.0 ... 6553.5 | (O45) | [CONTROL. INSIDE CARD] (PLC-) | 296
O46 | Controller Inside HMI word 46 | 16#192E = 6446 | 16#2022/2F | 16#5FC8/2E | 16#81/01/2F = 129/01/47 | - | Controller Inside parameters | R/W | UINT (Unsigned16) | 0.1 | 0.0 | 0.0 ... 6553.5 | (O46) | [CONTROL. INSIDE CARD] (PLC-) | 297
O47 | Controller Inside HMI word 47 | 16#192F = 6447 | 16#2022/30 | 16#5FC8/2F | 16#81/01/30 = 129/01/48 | - | Controller Inside parameters | R/W | UINT (Unsigned16) | 0.1 | 0.0 | 0.0 ... 6553.5 | (O47) | [CONTROL. INSIDE CARD] (PLC-) | 298
O48 | Controller Inside HMI word 48 | 16#1930 = 6448 | 16#2022/31 | 16#5FC8/30 | 16#81/01/31 = 129/01/49 | - | Controller Inside parameters | R/W | UINT (Unsigned16) | 0.1 | 0.0 | 0.0 ... 6553.5 | (O48) | [CONTROL. INSIDE CARD] (PLC-) | 299
O49 | Controller Inside HMI word 49 | 16#1931 = 6449 | 16#2022/32 | 16#5FC8/31 | 16#81/01/32 = 129/01/50 | - | Controller Inside parameters | R/W | UINT (Unsigned16) | 0.1 | 0.0 | 0.0 ... 6553.5 | (O49) | [CONTROL. INSIDE CARD] (PLC-) | 300
O50 | Controller Inside HMI word 50 | 16#1932 = 6450 | 16#2022/33 | 16#5FC8/32 | 16#81/01/33 = 129/01/51 | - | Controller Inside parameters | R/W | UINT (Unsigned16) | 0.1 | 0.0 | 0.0 ... 6553.5 | (O50) | [CONTROL. INSIDE CARD] (PLC-) | 301
SMAL | Velocity max amount | 16#21A1 = 8609 (lsb) 16#21A2 = 8610 (msb) | 16#6046/02 | 16#6046/02 | 16#8C/01/0A = 140/01/10 | - | CiA 402 settings | R/W | UDINT | 1 rpm |  | 0 rpm ... 65535 rpm |  |  | 302
SMIL | Velocity min amount | 16#219F = 8607 (lsb) 16#21A0 = 8608 (msb) | 16#6046/01 | 16#6046/01 | 16#8C/01/08 = 140/01/08 | - | CiA 402 settings | R/W | UDINT | 1 rpm |  | 0 rpm ... 65535 rpm |  |  | 303
SPAL | Acceleration delta speed | 16#21A3 = 8611 (lsb) 16#21A4 = 8612 (msb) | 16#6048/01 | 16#6048/01 | 16#8C/01/0C = 140/01/12 | - | CiA 402 settings | R/W | UDINT | 1 rpm |  | 1 rpm ... 65535 rpm |  |  | 304
SPAT | Acceleration delta time | 16#21A5 = 8613 | 16#6048/02 | 16#6048/02 | 16#8C/01/0E = 140/01/14 | - | CiA 402 settings | R/W | UINT (Unsigned16) | 1 s |  | 0 s ... 65535 s |  |  | 305
SPDL | Deceleration delta speed | 16#21A6 = 8614 (lsb) 16#21A7 = 8615 (msb) | 16#6049/01 | 16#6049/01 | 16#8C/01/0F = 140/01/15 | - | CiA 402 settings | R/W | UDINT | 1 rpm |  | 1 rpm ... 65535 rpm |  |  | 306
SPDT | Deceleration delta time | 16#21A8 = 8616 | 16#6049/02 | 16#6049/02 | 16#8C/01/11 = 140/01/17 | - | CiA 402 settings | R/W | UINT (Unsigned16) | 1 s |  | 0 s ... 65535 s |  |  | 307
SPFN | Setpoint factor numerator | 16#21C2 = 8642 | 16#604B/01 | 16#5FBC/AE | 16#8C/01/2B = 140/01/43 | - | CiA 402 settings | R/WS | UINT (Unsigned16) | 1 | 1 | 1 ... 65535 |  |  | 308
SPFD | Setpoint factor denominator | 16#21C3 = 8643 | 16#604B/02 | 16#5FBC/AF | 16#8C/01/2C = 140/01/44 | - | CiA 402 settings | R/WS | UINT (Unsigned16) | 1 | 1 | 1 ... 65535 |  |  | 309
DOTD | Disable operation option code | 16#21CC = 8652 | 16#605C/00 | 16#5FBD/99 | 16#8C/01/35 = 140/01/53 | DOTD | CiA 402 settings | R/WS | WORD (Enumeration) | - | [Ramp stop] (rMP) | - | [Dis. operat opt code] (dOtd) | [STOP CONFIGURATION] (Stt-) | 310
QSTD | Quick stop option code | 16#21CB = 8651 | 16#605A/00 | 16#5FBD/98 | 16#8C/01/34 = 140/01/52 | QSTD | CiA 402 settings | R/WS | WORD (Enumeration) | - | (FSt6) | - |  |  | 311
ACCD | ODVA acceleration time | - | - | - | 16#2A/01/12 = 42/1/18 |  | ODVA settings | - | - | - | - | - |  |  | 312
DECD | ODVA deceleration time | - | - | - | 16#2A/01/13 = 42/1/19 |  | ODVA settings | - | - | - | - | - |  |  | 313
LSPD | Low speed limit | - | - | - | 16#2A/01/14 = 42/1/20 |  | ODVA settings | - | - | - | - | - |  |  | 314
HSPD | High speed limit | - | - | - | 16#2A/01/15 = 42/1/21 |  | ODVA settings | - | - | - | - | - |  |  | 315
SCS | Save configuration | 16#1F41 = 8001 | 16#2032/2 | 16#5FBC/9A | 16#89/01/02 = 137/01/02 | SCS | Configuration management | R/WS | WORD (Enumeration) | - | [No] (nO) | - | [Saving config.] (SCS) | [FACTORY SETTINGS] (FCS-) | 316
FCS | Restore configuration | 16#1F42 = 8002 | 16#2032/3 | 16#5FBC/9B | 16#89/01/03 = 137/01/03 | FCS | Configuration management | R/WS | WORD (Enumeration) | - | [NO] (nO) | - | [Restore config.] (FCS) | [FACTORY SETTINGS] (FCS-) | 317
FRY | Factory setting group | 16#0BCE = 3022 | 16#2000/17 | 16#5FBC/06 | 16#70/01/17 = 112/01/23 | FrY | Configuration management | R/WS | WORD (BitString16) | - | 0 | - |  |  | 318
CHA1 | 2 Parameter sets | 16#3266 = 12902 | 16#2063/3 | 16#5FBD/54 | 16#A1/01/67 = 161/01/103 | PSLIN | Parameter set switching | R/WS | WORD (Enumeration) | - | [No] (nO) | - | [2 Parameter sets] (CHA1) | [PARAM. SET SWITCHING] (MLP-) | 319
CHA2 | 3 Parameter sets | 16#3267 = 12903 | 16#2063/4 | 16#5FBD/55 | 16#A1/01/68 = 161/01/104 | PSLIN | Parameter set switching | R/WS | WORD (Enumeration) | - | [No] (nO) | - | [3 Parameter sets] (CHA2) | [PARAM. SET SWITCHING] (MLP-) | 320
CFPS | Active parameter set | 16#3264 = 12900 | 16#2063/1 | 16#5FB9/EC | 16#A1/01/65 = 161/01/101 | CFPS | Parameter set switching | R | WORD (Enumeration) | - |  | - | [Utilised param. set] (CFPS) | [MONITORING] (SUP-) | 321
VAL | Load parameter set command | 16#3265 = 12901 | 16#2063/2 | - | 16#A1/01/66 = 161/01/102 | - | Parameter set switching | R/W | UINT (Unsigned16) | 1 | 0 | 0 ... 1 |  |  | 322
AD01 | Parameter set address 1 | 16#326F = 12911 | 16#2063/C | 16#5FBF/8D | 16#A1/01/70 = 161/01/112 | - | Parameter set switching | R/W | UINT (Unsigned16) | 1 | 0 | 0 ... 65535 |  |  | 323
AD02 | Parameter set address 2 | 16#3270 = 12912 | 16#2063/D | 16#5FBF/8E | 16#A1/01/71 = 161/01/113 | - | Parameter set switching | R/W | UINT (Unsigned16) | 1 | 0 | 0 ... 65535 |  |  | 324
AD03 | Parameter set address 3 | 16#3271 = 12913 | 16#2063/E | 16#5FBF/8F | 16#A1/01/72 = 161/01/114 | - | Parameter set switching | R/W | UINT (Unsigned16) | 1 | 0 | 0 ... 65535 |  |  | 325
AD04 | Parameter set address 4 | 16#3272 = 12914 | 16#2063/F | 16#5FBF/90 | 16#A1/01/73 = 161/01/115 | - | Parameter set switching | R/W | UINT (Unsigned16) | 1 | 0 | 0 ... 65535 |  |  | 326
AD05 | Parameter set address 5 | 16#3273 = 12915 | 16#2063/10 | 16#5FBF/91 | 16#A1/01/74 = 161/01/116 | - | Parameter set switching | R/W | UINT (Unsigned16) | 1 | 0 | 0 ... 65535 |  |  | 327
AD06 | Parameter set address 6 | 16#3274 = 12916 | 16#2063/11 | 16#5FBF/92 | 16#A1/01/75 = 161/01/117 | - | Parameter set switching | R/W | UINT (Unsigned16) | 1 | 0 | 0 ... 65535 |  |  | 328
AD07 | Parameter set address 7 | 16#3275 = 12917 | 16#2063/12 | 16#5FBF/93 | 16#A1/01/76 = 161/01/118 | - | Parameter set switching | R/W | UINT (Unsigned16) | 1 | 0 | 0 ... 65535 |  |  | 329
AD08 | Parameter set address 8 | 16#3276 = 12918 | 16#2063/13 | 16#5FBF/94 | 16#A1/01/77 = 161/01/119 | - | Parameter set switching | R/W | UINT (Unsigned16) | 1 | 0 | 0 ... 65535 |  |  | 330
AD09 | Parameter set address 9 | 16#3277 = 12919 | 16#2063/14 | 16#5FBF/95 | 16#A1/01/78 = 161/01/120 | - | Parameter set switching | R/W | UINT (Unsigned16) | 1 | 0 | 0 ... 65535 |  |  | 331
AD10 | Parameter set address 10 | 16#3278 = 12920 | 16#2063/15 | 16#5FBF/96 | 16#A1/01/79 = 161/01/121 | - | Parameter set switching | R/W | UINT (Unsigned16) | 1 | 0 | 0 ... 65535 |  |  | 332
AD11 | Parameter set address 11 | 16#3279 = 12921 | 16#2063/16 | 16#5FBF/97 | 16#A1/01/7A = 161/01/122 | - | Parameter set switching | R/W | UINT (Unsigned16) | 1 | 0 | 0 ... 65535 |  |  | 333
AD12 | Parameter set address 12 | 16#327A = 12922 | 16#2063/17 | 16#5FBF/98 | 16#A1/01/7B = 161/01/123 | - | Parameter set switching | R/W | UINT (Unsigned16) | 1 | 0 | 0 ... 65535 |  |  | 334
AD13 | Parameter set address 13 | 16#327B = 12923 | 16#2063/18 | 16#5FBF/99 | 16#A1/01/7C = 161/01/124 | - | Parameter set switching | R/W | UINT (Unsigned16) | 1 | 0 | 0 ... 65535 |  |  | 335
AD14 | Parameter set address 14 | 16#327C = 12924 | 16#2063/19 | 16#5FBF/9A | 16#A1/01/7D = 161/01/125 | - | Parameter set switching | R/W | UINT (Unsigned16) | 1 | 0 | 0 ... 65535 |  |  | 336
AD15 | Parameter set address 15 | 16#327D = 12925 | 16#2063/1A | 16#5FBF/9B | 16#A1/01/7E = 161/01/126 | - | Parameter set switching | R/W | UINT (Unsigned16) | 1 | 0 | 0 ... 65535 |  |  | 337
S101 | Parameter set 1 value 1 | 16#3283 = 12931 | 16#2063/20 | 16#5FBF/9C | 16#A1/01/84 = 161/01/132 | - | Parameter set switching | R/W | UINT (Unsigned16) | 1 | 0 | 0 ... 65535 | (S101) | [SET 1] (PS1-) | 338
S102 | Parameter set 1 value 2 | 16#3284 = 12932 | 16#2063/21 | 16#5FBF/9D | 16#A1/01/85 = 161/01/133 | - | Parameter set switching | R/W | UINT (Unsigned16) | 1 | 0 | 0 ... 65535 | (S102) | [SET 1] (PS1-) | 339
S103 | Parameter set 1 value 3 | 16#3285 = 12933 | 16#2063/22 | 16#5FBF/9E | 16#A1/01/86 = 161/01/134 | - | Parameter set switching | R/W | UINT (Unsigned16) | 1 | 0 | 0 ... 65535 | (S103) | [SET 1] (PS1-) | 340
S104 | Parameter set 1 value 4 | 16#3286 = 12934 | 16#2063/23 | 16#5FBF/9F | 16#A1/01/87 = 161/01/135 | - | Parameter set switching | R/W | UINT (Unsigned16) | 1 | 0 | 0 ... 65535 | (S104) | [SET 1] (PS1-) | 341
S105 | Parameter set 1 value 5 | 16#3287 = 12935 | 16#2063/24 | 16#5FBF/A0 | 16#A1/01/88 = 161/01/136 | - | Parameter set switching | R/W | UINT (Unsigned16) | 1 | 0 | 0 ... 65535 | (S105) | [SET 1] (PS1-) | 342
S106 | Parameter set 1 value 6 | 16#3288 = 12936 | 16#2063/25 | 16#5FBF/A1 | 16#A1/01/89 = 161/01/137 | - | Parameter set switching | R/W | UINT (Unsigned16) | 1 | 0 | 0 ... 65535 | (S106) | [SET 1] (PS1-) | 343
S107 | Parameter set 1 value 7 | 16#3289 = 12937 | 16#2063/26 | 16#5FBF/A2 | 16#A1/01/8A = 161/01/138 | - | Parameter set switching | R/W | UINT (Unsigned16) | 1 | 0 | 0 ... 65535 | (S107) | [SET 1] (PS1-) | 344
S108 | Parameter set 1 value 8 | 16#328A = 12938 | 16#2063/27 | 16#5FBF/A3 | 16#A1/01/8B = 161/01/139 | - | Parameter set switching | R/W | UINT (Unsigned16) | 1 | 0 | 0 ... 65535 | (S108) | [SET 1] (PS1-) | 345
S109 | Parameter set 1 value 9 | 16#328B = 12939 | 16#2063/28 | 16#5FBF/A4 | 16#A1/01/8C = 161/01/140 | - | Parameter set switching | R/W | UINT (Unsigned16) | 1 | 0 | 0 ... 65535 | (S109) | [SET 1] (PS1-) | 346
S110 | Parameter set 1 value 10 | 16#328C = 12940 | 16#2063/29 | 16#5FBF/A5 | 16#A1/01/8D = 161/01/141 | - | Parameter set switching | R/W | UINT (Unsigned16) | 1 | 0 | 0 ... 65535 | (S110) | [SET 1] (PS1-) | 347
S111 | Parameter set 1 value 11 | 16#328D = 12941 | 16#2063/2A | 16#5FBF/A6 | 16#A1/01/8E = 161/01/142 | - | Parameter set switching | R/W | UINT (Unsigned16) | 1 | 0 | 0 ... 65535 | (S111) | [SET 1] (PS1-) | 348
S112 | Parameter set 1 value 12 | 16#328E = 12942 | 16#2063/2B | 16#5FBF/A7 | 16#A1/01/8F = 161/01/143 | - | Parameter set switching | R/W | UINT (Unsigned16) | 1 | 0 | 0 ... 65535 | (S112) | [SET 1] (PS1-) | 349
S113 | Parameter set 1 value 13 | 16#328F = 12943 | 16#2063/2C | 16#5FBF/A8 | 16#A1/01/90 = 161/01/144 | - | Parameter set switching | R/W | UINT (Unsigned16) | 1 | 0 | 0 ... 65535 | (S113) | [SET 1] (PS1-) | 350
S114 | Parameter set 1 value 14 | 16#3290 = 12944 | 16#2063/2D | 16#5FBF/A9 | 16#A1/01/91 = 161/01/145 | - | Parameter set switching | R/W | UINT (Unsigned16) | 1 | 0 | 0 ... 65535 | (S114) | [SET 1] (PS1-) | 351
S115 | Parameter set 1 value 15 | 16#3291 = 12945 | 16#2063/2E | 16#5FBF/AA | 16#A1/01/92 = 161/01/146 | - | Parameter set switching | R/W | UINT (Unsigned16) | 1 | 0 | 0 ... 65535 | (S115) | [SET 1] (PS1-) | 352
S201 | Parameter set 2 value 1 | 16#3297 = 12951 | 16#2063/34 | 16#5FBF/AB | 16#A1/01/98 = 161/01/152 | - | Parameter set switching | R/W | UINT (Unsigned16) | 1 | 0 | 0 ... 65535 | (S201) | [SET 2] (PS2-) | 353
S202 | Parameter set 2 value 2 | 16#3298 = 12952 | 16#2063/35 | 16#5FBF/AC | 16#A1/01/99 = 161/01/153 | - | Parameter set switching | R/W | UINT (Unsigned16) | 1 | 0 | 0 ... 65535 | (S202) | [SET 2] (PS2-) | 354
S203 | Parameter set 2 value 3 | 16#3299 = 12953 | 16#2063/36 | 16#5FBF/AD | 16#A1/01/9A = 161/01/154 | - | Parameter set switching | R/W | UINT (Unsigned16) | 1 | 0 | 0 ... 65535 | (S203) | [SET 2] (PS2-) | 355
S204 | Parameter set 2 value 4 | 16#329A = 12954 | 16#2063/37 | 16#5FBF/AE | 16#A1/01/9B = 161/01/155 | - | Parameter set switching | R/W | UINT (Unsigned16) | 1 | 0 | 0 ... 65535 | (S204) | [SET 2] (PS2-) | 356
S205 | Parameter set 2 value 5 | 16#329B = 12955 | 16#2063/38 | 16#5FBF/AF | 16#A1/01/9C = 161/01/156 | - | Parameter set switching | R/W | UINT (Unsigned16) | 1 | 0 | 0 ... 65535 | (S205) | [SET 2] (PS2-) | 357
S206 | Parameter set 2 value 6 | 16#329C = 12956 | 16#2063/39 | 16#5FBF/B0 | 16#A1/01/9D = 161/01/157 | - | Parameter set switching | R/W | UINT (Unsigned16) | 1 | 0 | 0 ... 65535 | (S206) | [SET 2] (PS2-) | 358
S207 | Parameter set 2 value 7 | 16#329D = 12957 | 16#2063/3A | 16#5FBF/B1 | 16#A1/01/9E = 161/01/158 | - | Parameter set switching | R/W | UINT (Unsigned16) | 1 | 0 | 0 ... 65535 | (S207) | [SET 2] (PS2-) | 359
S208 | Parameter set 2 value 8 | 16#329E = 12958 | 16#2063/3B | 16#5FBF/B2 | 16#A1/01/9F = 161/01/159 | - | Parameter set switching | R/W | UINT (Unsigned16) | 1 | 0 | 0 ... 65535 | (S208) | [SET 2] (PS2-) | 360
S209 | Parameter set 2 value 9 | 16#329F = 12959 | 16#2063/3C | 16#5FBF/B3 | 16#A1/01/A0 = 161/01/160 | - | Parameter set switching | R/W | UINT (Unsigned16) | 1 | 0 | 0 ... 65535 | (S209) | [SET 2] (PS2-) | 361
S210 | Parameter set 2 value 10 | 16#32A0 = 12960 | 16#2063/3D | 16#5FBF/B4 | 16#A1/01/A1 = 161/01/161 | - | Parameter set switching | R/W | UINT (Unsigned16) | 1 | 0 | 0 ... 65535 | (S210) | [SET 2] (PS2-) | 362
S211 | Parameter set 2 value 11 | 16#32A1 = 12961 | 16#2063/3E | 16#5FBF/B5 | 16#A1/01/A2 = 161/01/162 | - | Parameter set switching | R/W | UINT (Unsigned16) | 1 | 0 | 0 ... 65535 | (S211) | [SET 2] (PS2-) | 363
S212 | Parameter set 2 value 12 | 16#32A2 = 12962 | 16#2063/3F | 16#5FBF/B6 | 16#A1/01/A3 = 161/01/163 | - | Parameter set switching | R/W | UINT (Unsigned16) | 1 | 0 | 0 ... 65535 | (S212) | [SET 2] (PS2-) | 364
S213 | Parameter set 2 value 13 | 16#32A3 = 12963 | 16#2063/40 | 16#5FBF/B7 | 16#A1/01/A4 = 161/01/164 | - | Parameter set switching | R/W | UINT (Unsigned16) | 1 | 0 | 0 ... 65535 | (S213) | [SET 2] (PS2-) | 365
S214 | Parameter set 2 value 14 | 16#32A4 = 12964 | 16#2063/41 | 16#5FBF/B8 | 16#A1/01/A5 = 161/01/165 | - | Parameter set switching | R/W | UINT (Unsigned16) | 1 | 0 | 0 ... 65535 | (S214) | [SET 2] (PS2-) | 366
S215 | Parameter set 2 value 15 | 16#32A5 = 12965 | 16#2063/42 | 16#5FBF/B9 | 16#A1/01/A6 = 161/01/166 | - | Parameter set switching | R/W | UINT (Unsigned16) | 1 | 0 | 0 ... 65535 | (S215) | [SET 2] (PS2-) | 367
S301 | Parameter set 3 value 1 | 16#32AB = 12971 | 16#2063/48 | 16#5FBF/BA | 16#A1/01/AC = 161/01/172 | - | Parameter set switching | R/W | UINT (Unsigned16) | 1 | 0 | 0 ... 65535 | (S301) | [SET 3] (PS3-) | 368
S302 | Parameter set 3 value 2 | 16#32AC = 12972 | 16#2063/49 | 16#5FBF/BB | 16#A1/01/AD = 161/01/173 | - | Parameter set switching | R/W | UINT (Unsigned16) | 1 | 0 | 0 ... 65535 | (S302) | [SET 3] (PS3-) | 369
S303 | Parameter set 3 value 3 | 16#32AD = 12973 | 16#2063/4A | 16#5FBF/BC | 16#A1/01/AE = 161/01/174 | - | Parameter set switching | R/W | UINT (Unsigned16) | 1 | 0 | 0 ... 65535 | (S303) | [SET 3] (PS3-) | 370
S304 | Parameter set 3 value 4 | 16#32AE = 12974 | 16#2063/4B | 16#5FBF/BD | 16#A1/01/AF = 161/01/175 | - | Parameter set switching | R/W | UINT (Unsigned16) | 1 | 0 | 0 ... 65535 | (S304) | [SET 3] (PS3-) | 371
S305 | Parameter set 3 value 5 | 16#32AF = 12975 | 16#2063/4C | 16#5FBF/BE | 16#A1/01/B0 = 161/01/176 | - | Parameter set switching | R/W | UINT (Unsigned16) | 1 | 0 | 0 ... 65535 | (S305) | [SET 3] (PS3-) | 372
S306 | Parameter set 3 value 6 | 16#32B0 = 12976 | 16#2063/4D | 16#5FBF/BF | 16#A1/01/B1 = 161/01/177 | - | Parameter set switching | R/W | UINT (Unsigned16) | 1 | 0 | 0 ... 65535 | (S306) | [SET 3] (PS3-) | 373
S307 | Parameter set 3 value 7 | 16#32B1 = 12977 | 16#2063/4E | 16#5FBF/C0 | 16#A1/01/B2 = 161/01/178 | - | Parameter set switching | R/W | UINT (Unsigned16) | 1 | 0 | 0 ... 65535 | (S307) | [SET 3] (PS3-) | 374
S308 | Parameter set 3 value 8 | 16#32B2 = 12978 | 16#2063/4F | 16#5FBF/C1 | 16#A1/01/B3 = 161/01/179 | - | Parameter set switching | R/W | UINT (Unsigned16) | 1 | 0 | 0 ... 65535 | (S308) | [SET 3] (PS3-) | 375
S309 | Parameter set 3 value 9 | 16#32B3 = 12979 | 16#2063/50 | 16#5FBF/C2 | 16#A1/01/B4 = 161/01/180 | - | Parameter set switching | R/W | UINT (Unsigned16) | 1 | 0 | 0 ... 65535 | (S309) | [SET 3] (PS3-) | 376
S310 | Parameter set 3 value 10 | 16#32B4 = 12980 | 16#2063/51 | 16#5FBF/C3 | 16#A1/01/B5 = 161/01/181 | - | Parameter set switching | R/W | UINT (Unsigned16) | 1 | 0 | 0 ... 65535 | (S310) | [SET 3] (PS3-) | 377
S311 | Parameter set 3 value 11 | 16#32B5 = 12981 | 16#2063/52 | 16#5FBF/C4 | 16#A1/01/B6 = 161/01/182 | - | Parameter set switching | R/W | UINT (Unsigned16) | 1 | 0 | 0 ... 65535 | (S311) | [SET 3] (PS3-) | 378
S312 | Parameter set 3 value 12 | 16#32B6 = 12982 | 16#2063/53 | 16#5FBF/C5 | 16#A1/01/B7 = 161/01/183 | - | Parameter set switching | R/W | UINT (Unsigned16) | 1 | 0 | 0 ... 65535 | (S312) | [SET 3] (PS3-) | 379
S313 | Parameter set 3 value 13 | 16#32B7 = 12983 | 16#2063/54 | 16#5FBF/C6 | 16#A1/01/B8 = 161/01/184 | - | Parameter set switching | R/W | UINT (Unsigned16) | 1 | 0 | 0 ... 65535 | (S313) | [SET 3] (PS3-) | 380
S314 | Parameter set 3 value 14 | 16#32B8 = 12984 | 16#2063/55 | 16#5FBF/C7 | 16#A1/01/B9 = 161/01/185 | - | Parameter set switching | R/W | UINT (Unsigned16) | 1 | 0 | 0 ... 65535 | (S314) | [SET 3] (PS3-) | 381
S315 | Parameter set 3 value 15 | 16#32B9 = 12985 | 16#2063/56 | 16#5FBF/C8 | 16#A1/01/BA = 161/01/186 | - | Parameter set switching | R/W | UINT (Unsigned16) | 1 | 0 | 0 ... 65535 | (S315) | [SET 3] (PS3-) | 382
CFG | Macro configuration | 16#0BEC = 3052 | 16#2000/35 | 16#5FBC/07 | 16#70/01/35 = 112/01/53 | CFG | Configuration and settings | R/WS | WORD (Enumeration) | - | [Start/Stop] (StS) | - | [Macro configuration] (CFG) | [SIMPLY START] (SIM-) | 383
CCFG | Customized macro | 16#0BED = 3053 | 16#2000/36 | 16#5FB9/02 | 16#70/01/36 = 112/01/54 | N_Y | Configuration and settings | R | WORD (Enumeration) | - |  | - | [Customized macro] (CCFG) | [SIMPLY START] (SIM-) | 384
LSP | Low speed | 16#0C21 = 3105 | 16#2001/6 | 16#5FBF/04 | 16#70/01/6A = 112/01/106 | - | Configuration and settings | R/W | UINT (Unsigned16) | 0.1 Hz | Refer to programming manual | 0.0 Hz ... 1600.0 Hz | [Low speed] (LSP) | [SIMPLY START] (SIM-) [SETTINGS] (SEt-) | 385
HSP | High speed | 16#0C20 = 3104 | 16#2001/5 | 16#5FBF/03 | 16#70/01/69 = 112/01/105 | - | Configuration and settings | R/W | UINT (Unsigned16) | 0.1 Hz | Refer to programming manual | 0.0 Hz ... 1600.0 Hz | [High speed] (HSP) | [SIMPLY START] (SIM-) [SETTINGS] (SEt-) | 386
ITH | Mot. therm. current | 16#2596 = 9622 | 16#2042/17 | 16#5FC2/0D | 16#2A/01/0A = 42/1/10 (messaging) 16#91/01/17 = 145/1/23 (assembly) | - | Configuration and settings | R/W | UINT (Unsigned16) | Refer to programming manual | Depends of rating | - | [Mot. therm. current] (ItH) | [SIMPLY START] (SIM-) [SETTINGS] (SEt-) | 387
SPG | Speed prop. gain | 16#238F = 9103 | 16#203D/4 | 16#5FBF/27 | 16#8E/01/68 = 142/01/104 | - | Configuration and settings | R/W | UINT (Unsigned16) | 1 % | 40 % | 0 % ... 1000 % | [Speed prop. gain] (SPG) | [SETTINGS] (SEt-) | 388
SIT | Speed time integral | 16#2390 = 9104 | 16#203D/5 | 16#5FBF/28 | 16#8E/01/69 = 142/01/105 | - | Configuration and settings | R/W | UINT (Unsigned16) | 1 % | 100 % | 1 % ... 1000 % | [Speed time integral] (SIt) | [SETTINGS] (SEt-) | 389
SFC | K speed loop filter | 16#2391 = 9105 | 16#203D/6 | 16#5FBF/29 | 16#8E/01/6A = 142/01/106 | - | Configuration and settings | R/W | UINT (Unsigned16) | 1 | 0 | 0 ... 100 | [K speed loop filter] (SFC) | [SETTINGS] (SEt-) | 390
CTD | Current threshold | 16#2AF9 = 11001 | 16#2050/2 | 16#5FBF/48 | 16#98/01/02 = 152/01/02 | - | Configuration and settings | R/W | UINT (Unsigned16) | Refer to programming manual | INV | Refer to programming manual | [Current threshold] (Ctd) | [SETTINGS] (SEt-) | 391
TTH | High torque thd. | 16#2B08 = 11016 | 16#2050/11 | 16#5FC0/56 | 16#98/01/11 = 152/01/17 | - | Configuration and settings | R/W | INT (Signed16) | 1 % | 100 % | -300 % ... 300 % | [High torque thd.] (ttH) | [SETTINGS] (SEt-) | 392
TTL | Low torque thd. | 16#2B07 = 11015 | 16#2050/10 | 16#5FC0/55 | 16#98/01/10 = 152/01/16 | - | Configuration and settings | R/W | INT (Signed16) | 1 % | 50 % | -300 % ... 300 % | [Low torque thd.] (ttL) | [SETTINGS] (SEt-) | 393
FQL | Pulse warning thd. | 16#3911 = 14609 | 16#2074/A | 16#5FBD/B2 | 16#AA/01/0A = 170/01/10 | - | Configuration and settings | R/WS | UINT (Unsigned16) | 1 Hz | 0 Hz | 0 Hz ... 30000 Hz | [Pulse warning thd.] (FqL) | [SETTINGS] (SEt-) | 394
FTD | Freq. threshold | 16#2AFB = 11003 | 16#2050/4 | 16#5FBF/4A | 16#98/01/04 = 152/01/04 | - | Configuration and settings | R/W | UINT (Unsigned16) | 0.1 Hz | Refer to programming manual | 0.0 Hz ... 1600.0 Hz | [Freq. threshold] (Ftd) | [SETTINGS] (SEt-) | 395
F2D | Freq. threshold 2 | 16#2AFC = 11004 | 16#2050/5 | 16#5FBF/4B | 16#98/01/05 = 152/01/05 | - | Configuration and settings | R/W | UINT (Unsigned16) | 0.1 Hz | Refer to programming manual | 0.0 Hz ... 1600.0 Hz | [Freq. threshold 2] (F2d) | [SETTINGS] (SEt-) | 396
JF2 | Skip Frequency 2 | 16#2C26 = 11302 | 16#2053/3 | 16#5FBF/57 | 16#99/01/67 = 153/01/103 | - | Configuration and settings | R/W | UINT (Unsigned16) | 0.1 Hz | 0.0 Hz | 0.0 Hz ... 1600.0 Hz | [Skip Frequency 2] (JF2) | [SETTINGS] (SEt-) | 397
JPF | Skip Frequency | 16#2C25 = 11301 | 16#2053/2 | 16#5FBF/56 | 16#99/01/66 = 153/01/102 | - | Configuration and settings | R/W | UINT (Unsigned16) | 0.1 Hz | 0.0 Hz | 0.0 Hz ... 1600.0 Hz | [Skip Frequency] (JPF) | [SETTINGS] (SEt-) | 398
JFH | Skip.Freq.Hysteresis | 16#2C2F = 11311 | 16#2053/C | 16#5FC0/5B | 16#99/01/70 = 153/01/112 | - | Configuration and settings | R/W | UINT (Unsigned16) | 0.1 Hz | 1.0 Hz | 0.1 Hz ... 10.0 Hz | [Skip.Freq.Hysteresis] (JFH) | [SETTINGS] (SEt-) | 399
JF3 | 3rd Skip Frequency | 16#2C27 = 11303 | 16#2053/4 | 16#5FC0/5A | 16#99/01/68 = 153/01/104 | - | Configuration and settings | R/W | UINT (Unsigned16) | 0.1 Hz | 0.0 Hz | 0.0 Hz ... 1600.0 Hz | [3rd Skip Frequency] (JF3) | [SETTINGS] (SEt-) | 400
BFR | Standard mot. freq | 16#0BC7 = 3015 | 16#2000/10 | 16#5FBC/05 | 16#70/01/10 = 112/01/16 | BFR | Configuration and settings | R/WS | WORD (Enumeration) | - | Depends of rating | - | [Standard mot. freq] (bFr) | [SIMPLY START] (SIM-) [MOTOR CONTROL] (drC-) | 401
NPR | Rated motor power | 16#258D = 9613 | 16#2042/E | 16#5FC2/0A | 16#91/01/0E = 145/01/14 | - | Configuration and settings | R/WS | UINT (Unsigned16) | Refer to programming manual | Depends of rating | - | [Rated motor power] (nPr) | [SIMPLY START] (SIM-) [MOTOR CONTROL] (drC-) | 402
UNS | Rated motor volt. | 16#2581 = 9601 | 16#2042/2 | 16#5FC2/01 | 16#28/01/07 = 40/1/7 (messaging) 16#91/01/02 = 145/1/2 (assembly) | - | Configuration and settings | R/WS | UINT (Unsigned16) | 1 V | Depends of rating | 100 V ... 690 V | [Rated motor volt.] (UnS) | [SIMPLY START] (SIM-) [MOTOR CONTROL] (drC-) | 403
NCR | Rated mot. current | 16#2583 = 9603 | 16#2042/4 | 16#5FC2/03 | 16#28/01/06 = 40/1/6 (messaging) 16#91/01/04 = 145/1/4 (assembly) | - | Configuration and settings | R/WS | UINT (Unsigned16) | Refer to programming manual | Depends of rating | - | [Rated mot. current] (nCr) | [SIMPLY START] (SIM-) [MOTOR CONTROL] (drC-) | 404
FRS | Rated motor freq. | 16#2582 = 9602 | 16#2042/3 | 16#5FC2/02 | 16#28/01/09 = 40/1/9 (messaging) 16#91/01/03 = 145/1/3 (assembly) | - | Configuration and settings | R/WS | UINT (Unsigned16) | 0.1 Hz | Refer to programming manual | 10.0 Hz ... 1600.0 Hz | [Rated motor freq.] (FrS) | [SIMPLY START] (SIM-) [MOTOR CONTROL] (drC-) | 405
INSP | rpm increment | 16#2580 = 9600 | 16#2042/1 | 16#5FC2/29 | 16#91/01/01 = 145/01/01 | INSP | Configuration and settings | R/W | WORD (Enumeration) | - | [x1 rpm] (1) | - | [rpm increment] (InSP) | [MOTOR CONTROL] (drC-) | 406
NSP | Rated motor speed | 16#2584 = 9604 | 16#2042/5 | 16#5FC2/04 | 16#28/01/0F = 40/1/15 (messaging) 16#91/01/05 = 145/1/5 (assembly) | - | Configuration and settings | R/WS | UINT (Unsigned16) | Refer to programming manual | Depends of rating | Refer to programming manual | [Rated motor speed] (nSP) | [SIMPLY START] (SIM-) [MOTOR CONTROL] (drC-) | 407
TFR | Max frequency | 16#0C1F = 3103 | 16#2001/4 | 16#5FBC/08 | 16#70/01/68 = 112/01/104 | - | Configuration and settings | R/WS | UINT (Unsigned16) | 0.1 Hz | Refer to programming manual | 10.0 Hz ... 1600.0 Hz | [Max frequency] (tFr) | [SIMPLY START] (SIM-) [MOTOR CONTROL] (drC-) | 408
TUN | Auto tuning | 16#2588 = 9608 | 16#2042/9 | 16#5FC2/07 | 16#91/01/09 = 145/01/09 | TUN | Configuration and settings | R/WS | WORD (Enumeration) | - | [No] (nO) | - | [Auto tuning] (tUn) | [SIMPLY START] (SIM-) [MOTOR CONTROL] (drC-) | 409
AUT | Automatic autotune | 16#258F = 9615 | 16#2042/10 | 16#5FC2/0B | 16#91/01/10 = 145/01/16 | N_Y | Configuration and settings | R/W | WORD (Enumeration) | - | [No] (nO) | - | [Automatic autotune] (AUt) | [MOTOR CONTROL] (drC-) | 410
TUS | Auto tuning state | 16#2589 = 9609 | 16#2042/A | 16#5FC2/08 | 16#91/01/0A = 145/01/10 | ACT | Configuration and settings | R | WORD (Enumeration) | - | [Not done] (tAb) | - | [Auto tuning state] (tUS) | [SIMPLY START] (SIM-) [MOTOR CONTROL] (drC-) | 411
PHR | Output Ph rotation | 16#3459 = 13401 | 16#2068/2 | 16#5FBD/5F | 16#A4/01/02 = 164/01/02 | PHR | Configuration and settings | R/WS | WORD (Enumeration) | - | [ABC] (AbC) | - | [Output Ph rotation] (PHr) | [SIMPLY START] (SIM-) [MOTOR CONTROL] (drC-) | 412
CTT | Motor control type | 16#2587 = 9607 | 16#2042/8 | 16#5FC2/06 | 16#91/01/08 = 145/01/08 | CTT | Configuration and settings | R/WS | WORD (Enumeration) | - | Refer to programming manual | - | [Motor control type] (Ctt) | [MOTOR CONTROL] (drC-) | 413
U0 | U0 | 16#3071 = 12401 | 16#205E/2 | 16#5FBD/2A | 16#9F/01/02 = 159/01/02 | - | Configuration and settings | R/WS | UINT (Unsigned16) | Refer to programming manual | Refer to programming manual | Refer to programming manual | [U0] (U0) | [MOTOR CONTROL] (drC-) | 414
U1 | U1 | 16#3073 = 12403 | 16#205E/4 | 16#5FBD/2B | 16#9F/01/04 = 159/01/04 | - | Configuration and settings | R/WS | UINT (Unsigned16) | Refer to programming manual | Refer to programming manual | Refer to programming manual | [U1] (U1) | [MOTOR CONTROL] (drC-) | 415
F1 | F1 | 16#3074 = 12404 | 16#205E/5 | 16#5FBD/2C | 16#9F/01/05 = 159/01/05 | - | Configuration and settings | R/WS | UINT (Unsigned16) | 0.1 Hz | 0.0 Hz | 0.0 Hz ... 1600.0 Hz | [F1] (F1) | [MOTOR CONTROL] (drC-) | 416
U2 | U2 | 16#3075 = 12405 | 16#205E/6 | 16#5FBD/2D | 16#9F/01/06 = 159/01/06 | - | Configuration and settings | R/WS | UINT (Unsigned16) | Refer to programming manual | Refer to programming manual | Refer to programming manual | [U2] (U2) | [MOTOR CONTROL] (drC-) | 417
F2 | F2 | 16#3076 = 12406 | 16#205E/7 | 16#5FBD/2E | 16#9F/01/07 = 159/01/07 | - | Configuration and settings | R/WS | UINT (Unsigned16) | 0.1 Hz | 0.0 Hz | 0.0 Hz ... 1600.0 Hz | [F2] (F2) | [MOTOR CONTROL] (drC-) | 418
U3 | U3 | 16#3077 = 12407 | 16#205E/8 | 16#5FBD/2F | 16#9F/01/08 = 159/01/08 | - | Configuration and settings | R/WS | UINT (Unsigned16) | Refer to programming manual | Refer to programming manual | Refer to programming manual | [U3] (U3) | [MOTOR CONTROL] (drC-) | 419
F3 | F3 | 16#3078 = 12408 | 16#205E/9 | 16#5FBD/30 | 16#9F/01/09 = 159/01/09 | - | Configuration and settings | R/WS | UINT (Unsigned16) | 0.1 Hz | 0.0 Hz | 0.0 Hz ... 1600.0 Hz | [F3] (F3) | [MOTOR CONTROL] (drC-) | 420
U4 | U4 | 16#3079 = 12409 | 16#205E/A | 16#5FBD/31 | 16#9F/01/0A = 159/01/10 | - | Configuration and settings | R/WS | UINT (Unsigned16) | Refer to programming manual | Refer to programming manual | Refer to programming manual | [U4] (U4) | [MOTOR CONTROL] (drC-) | 421
F4 | F4 | 16#307A = 12410 | 16#205E/B | 16#5FBD/32 | 16#9F/01/0B = 159/01/11 | - | Configuration and settings | R/WS | UINT (Unsigned16) | 0.1 Hz | 0.0 Hz | 0.0 Hz ... 1600.0 Hz | [F4] (F4) | [MOTOR CONTROL] (drC-) | 422
U5 | U5 | 16#307B = 12411 | 16#205E/C | 16#5FBD/33 | 16#9F/01/0C = 159/01/12 | - | Configuration and settings | R/WS | UINT (Unsigned16) | Refer to programming manual | Refer to programming manual | Refer to programming manual | [U5] (U5) | [MOTOR CONTROL] (drC-) | 423
F5 | F5 | 16#307C = 12412 | 16#205E/D | 16#5FBD/34 | 16#9F/01/0D = 159/01/13 | - | Configuration and settings | R/WS | UINT (Unsigned16) | 0.1 Hz | 0.0 Hz | 0.0 Hz ... 1600.0 Hz | [F5] (F5) | [MOTOR CONTROL] (drC-) | 424
VC2 | Vector Control 2pt | 16#3779 = 14201 | 16#2070/2 | 16#5FBD/80 | 16#A8/01/02 = 168/01/02 | N_Y | Configuration and settings | R/WS | WORD (Enumeration) | - | [No] (nO) | - | [Vector Control 2pt] (UC2) | [MOTOR CONTROL] (drC-) | 425
UCP | V. constant power | 16#377A = 14202 | 16#2070/3 | 16#5FBD/81 | 16#A8/01/03 = 168/01/03 | - | Configuration and settings | R/WS | UINT (Unsigned16) | 1 V | Depends of rating | 100 V ... 800 V | [V. constant power] (UCP) | [MOTOR CONTROL] (drC-) | 426
FCP | Freq. Const Power | 16#377B = 14203 | 16#2070/4 | 16#5FBD/82 | 16#A8/01/04 = 168/01/04 | - | Configuration and settings | R/WS | UINT (Unsigned16) | 0.1 Hz | Refer to programming manual | 10.0 Hz ... 1600.0 Hz | [Freq. Const Power] (FCP) | [MOTOR CONTROL] (drC-) | 427
NCRS | Nominal I sync. | 16#25C6 = 9670 | 16#2042/47 | 16#5FC2/1E | 16#91/01/47 = 145/01/71 | - | Configuration and settings | R/WS | UINT (Unsigned16) | Refer to programming manual | Depends of rating | - | [Nominal I sync.] (nCrS) | [MOTOR CONTROL] (drC-) | 428
NSPS | Nom motor spdsync | 16#25C7 = 9671 | 16#2042/48 | 16#5FC2/1F | 16#91/01/48 = 145/01/72 | - | Configuration and settings | R/WS | UINT (Unsigned16) | 1 rpm | Depends of rating | 0 rpm ... 60000 rpm | [Nom motor spdsync] (nSPS) | [MOTOR CONTROL] (drC-) | 429
PPNS | Pole pairs | 16#25C8 = 9672 | 16#2042/49 | 16#5FC2/20 | 16#91/01/49 = 145/01/73 | - | Configuration and settings | R/WS | UINT (Unsigned16) | 1 | Depends of rating | 1 ... 50 | [Pole pairs] (PPnS) | [MOTOR CONTROL] (drC-) | 430
PHS | Syn. EMF constant | 16#25C9 = 9673 | 16#2042/4A | 16#5FC2/21 | 16#91/01/4A = 145/01/74 | - | Configuration and settings | R/WS | UINT (Unsigned16) | 0.1 mV/rpm | Depends of rating | 0.0 mV/rpm ... 6553.5 mV/rpm | [Syn. EMF constant] (PHS) | [MOTOR CONTROL] (drC-) | 431
LDS | Autotune L d-axis | 16#25CA = 9674 | 16#2042/4B | 16#5FC2/22 | 16#91/01/4B = 145/01/75 | - | Configuration and settings | R/WS | UINT (Unsigned16) | Refer to programming manual | Depends of rating | Depends of rating | [Autotune L d-axis] (LdS) | [MOTOR CONTROL] (drC-) | 432
LQS | Autotune L q-axis | 16#25CB = 9675 | 16#2042/4C | 16#5FC2/23 | 16#91/01/4C = 145/01/76 | - | Configuration and settings | R/WS | UINT (Unsigned16) | Refer to programming manual | Depends of rating | Depends of rating | [Autotune L q-axis] (LqS) | [MOTOR CONTROL] (drC-) | 433
RSAS | Cust. stator R syn | 16#25D2 = 9682 | 16#2042/53 | 16#5FC2/26 | 16#91/01/53 = 145/01/83 | - | Configuration and settings | R/WS | UINT (Unsigned16) | Refer to programming manual | Depends of rating | Depends of rating | [Cust. stator R syn] (rSAS) | [MOTOR CONTROL] (drC-) | 434
UFR | IR compensation | 16#2597 = 9623 | 16#2042/18 | 16#5FC2/0E | 16#91/01/18 = 145/01/24 | - | Configuration and settings | R/W | UINT (Unsigned16) | 1 % | 100 % | 25 % ... 200 % | [IR compensation] (UFr) | [MOTOR CONTROL] (drC-) [SETTINGS] (SEt-) | 435
SLP | Slip compensation | 16#2599 = 9625 | 16#2042/1A | 16#5FC2/0F | 16#91/01/1A = 145/01/26 | - | Configuration and settings | R/W | UINT (Unsigned16) | 1 % | 100 % | 0 % ... 300 % | [Slip compensation] (SLP) | [MOTOR CONTROL] (drC-) [SETTINGS] (SEt-) | 436
RSM | Stator R measured | 16#25A8 = 9640 | 16#2042/29 | 16#5FB9/DF | 16#91/01/29 = 145/01/41 | - | Configuration and settings | R | UINT (Unsigned16) | Refer to programming manual |  | Depends of rating | [Stator R measured] (rSM) | [MOTOR CONTROL] (drC-) | 437
IDM | Magnetizing current | 16#25B2 = 9650 | 16#2042/33 | 16#5FB9/E0 | 16#91/01/33 = 145/01/51 | - | Configuration and settings | R | UINT (Unsigned16) | Refer to programming manual |  | Refer to programming manual | [Idr] (IdM) | [MOTOR CONTROL] (drC-) | 438
LFM | Leakage inductance | 16#25BC = 9660 | 16#2042/3D | 16#5FB9/E1 | 16#91/01/3D = 145/01/61 | - | Configuration and settings | R | UINT (Unsigned16) | Refer to programming manual |  | Depends of rating | [Lfr] (LFM) | [MOTOR CONTROL] (drC-) | 439
TRM | Rotor time constant | 16#25C1 = 9665 | 16#2042/42 | 16#5FB9/E2 | 16#91/01/42 = 145/01/66 | - | Configuration and settings | R | UINT (Unsigned16) | 1 ms |  | 0 ms ... 65535 ms | [T2r] (trM) | [MOTOR CONTROL] (drC-) | 440
NSL | Nominal motor slip | 16#2585 = 9605 | 16#2042/6 | 16#5FB9/DD | 16#91/01/06 = 145/01/06 | - | Configuration and settings | R | UINT (Unsigned16) | 0.1 Hz |  | 0.0 Hz ... 6553.5 Hz | [Nominal motor slip] (nSL) | [MOTOR CONTROL] (drC-) | 441
PPN | Number of pairs of poles calculated | 16#2592 = 9618 | 16#2042/13 | 16#5FC2/0C | 16#91/01/13 = 145/01/19 | - | Configuration and settings | R | UINT (Unsigned16) | 1 | Depends of rating | 1 ... 100 | [Poles pair number] (PPn) | [MOTOR CONTROL] (drC-) | 442
RSA | Cust stator resist. | 16#25AA = 9642 | 16#2042/2B | 16#5FC2/11 | 16#91/01/2B = 145/01/43 | - | Configuration and settings | R/WS | UINT (Unsigned16) | Refer to programming manual |  | Depends of rating | [Cust stator resist.] (rSA) | [MOTOR CONTROL] (drC-) | 443
IDA | Idw | 16#25B4 = 9652 | 16#2042/35 | 16#5FC2/15 | 16#91/01/35 = 145/01/53 | - | Configuration and settings | R/WS | UINT (Unsigned16) | Refer to programming manual | Refer to programming manual | Refer to programming manual | [Idw] (IdA) | [MOTOR CONTROL] (drC-) | 444
LFA | Lfw | 16#25BE = 9662 | 16#2042/3F | 16#5FC2/19 | 16#91/01/3F = 145/01/63 | - | Configuration and settings | R/WS | UINT (Unsigned16) | Refer to programming manual | Depends of rating | Depends of rating | [Lfw] (LFA) | [MOTOR CONTROL] (drC-) | 445
TRA | Rotor time constant | 16#25C3 = 9667 | 16#2042/44 | 16#5FC2/1C | 16#91/01/44 = 145/01/68 | - | Configuration and settings | R/WS | UINT (Unsigned16) | 1 ms | 0 ms | 0 ms ... 65535 ms | [Cust. rotor t const.] (trA) | [MOTOR CONTROL] (drC-) | 446
RSMS | Cold state stator resistance | 16#25D0 = 9680 | 16#2042/51 | 16#5FB9/E3 | 16#91/01/51 = 145/01/81 | - | Configuration and settings | R | UINT (Unsigned16) | Refer to programming manual |  | Depends of rating | [R1rS] (rSMS) | [MOTOR CONTROL] (drC-) | 447
FRSS | Nominal freq sync. | 16#25CF = 9679 | 16#2042/50 | 16#5FC2/24 | 16#91/01/50 = 145/01/80 | - | Configuration and settings | R | UINT (Unsigned16) | 0.1 Hz | Refer to programming manual | 10.0 Hz ... 500.0 Hz | [Nominal freq sync.] (FrSS) | [MOTOR CONTROL] (drC-) | 448
ENS | Encoder type | 16#15E8 = 5608 | 16#201A/9 | 16#5FBC/75 | 16#7D/01/09 = 125/01/09 | ENS | Configuration and settings | R/WS | WORD (Enumeration) | - | Refer to programming manual | - | [Encoder type] (EnS) | [ENCODER CONFIGURATION] (IEn-) [MOTOR CONTROL] (drC-) | 449
PGI | Encoder resolution | 16#15E4 = 5604 | 16#201A/5 | 16#5FBC/71 | 16#7D/01/05 = 125/01/05 | - | Configuration and settings | R/WS | UINT (Unsigned16) | 1 | 1024 | 100 ... 5000 | [Number of pulses] (PGI) | [ENCODER CONFIGURATION] (IEn-) [MOTOR CONTROL] (drC-) | 450
ENC | Encoder check | 16#15E5 = 5605 | 16#201A/6 | 16#5FBC/72 | 16#7D/01/06 = 125/01/06 | ENC | Configuration and settings | R/WS | WORD (Enumeration) | - | [Not done] (nO) | - | [Encoder check] (EnC) | [ENCODER CONFIGURATION] (IEn-) [MOTOR CONTROL] (drC-) | 451
ENU | Encoder usage | 16#15E6 = 5606 | 16#201A/7 | 16#5FBC/73 | 16#7D/01/07 = 125/01/07 | ENU | Configuration and settings | R/WS | WORD (Enumeration) | - | Refer to programming manual | - | [Encoder usage] (EnU) | [ENCODER CONFIGURATION] (IEn-) [MOTOR CONTROL] (drC-) | 452
ENA | ENA system | 16#2F45 = 12101 | 16#205B/2 | 16#5FBD/23 | 16#9D/01/66 = 157/01/102 | N_Y | Configuration and settings | R/WS | WORD (Enumeration) | - | [No] (nO) | - | [ENA system] (EnA) | [MOTOR CONTROL] (drC-) | 453
GPE | ENA prop.gain | 16#2F47 = 12103 | 16#205B/4 | 16#5FBF/7C | 16#9D/01/68 = 157/01/104 | - | Configuration and settings | R/W | UINT (Unsigned16) | 1 | 250 | 1 ... 9999 | [ENA prop.gain] (GPE) | [MOTOR CONTROL] (drC-) [SETTINGS] (SEt-) | 454
GIE | ENA integral gain | 16#2F48 = 12104 | 16#205B/5 | 16#5FBF/7D | 16#9D/01/69 = 157/01/105 | - | Configuration and settings | R/W | UINT (Unsigned16) | 1 | 100 | 0 ... 9999 | [ENA integral gain] (GIE) | [MOTOR CONTROL] (drC-) [SETTINGS] (SEt-) | 455
RAP | Reduction ratio | 16#2F49 = 12105 | 16#205B/6 | 16#5FBF/7E | 16#9D/01/6A = 157/01/106 | - | Configuration and settings | R/W | UINT (Unsigned16) | 0.1 | 10.0 | 10.0 ... 999.9 | [Reduction ratio] (rAP) | [MOTOR CONTROL] (drC-) | 456
OFI | Sinus filter | 16#0C25 = 3109 | 16#2001/A | 16#5FBC/0B | 16#70/01/6E = 112/01/110 | N_Y | Configuration and settings | R/WS | WORD (Enumeration) | - | [No] (nO) | - | [Sinus filter] (OFI) | [MOTOR CONTROL] (drC-) | 457
SFR | Switching freq. | 16#0C1E = 3102 | 16#2001/3 | 16#5FBF/02 | 16#70/01/67 = 112/01/103 | - | Configuration and settings | R/W | UINT (Unsigned16) | 0.1 kHz | Refer to programming manual | 1.0 kHz ... 16.0 kHz | [Switching freq.] (SFr) | [MOTOR CONTROL] (drC-) [SETTINGS] (SEt-) | 458
CLI | Current Limitation | 16#23F1 = 9201 | 16#203E/2 | 16#5FBF/2A | 16#8F/01/02 = 143/01/02 | - | Configuration and settings | R/W | UINT (Unsigned16) | Refer to programming manual | Depends of rating | Refer to programming manual | [Current Limitation] (CLI) | [MOTOR CONTROL] (drC-) [SETTINGS] (SEt-) | 459
NRD | Noise reduction | 16#0C23 = 3107 | 16#2001/8 | 16#5FBC/09 | 16#70/01/6C = 112/01/108 | N_Y | Configuration and settings | R/WS | WORD (Enumeration) | - | Refer to programming manual | - | [Noise reduction] (nrd) | [MOTOR CONTROL] (drC-) | 460
SVL | Motor surge limit. | 16#3139 = 12601 | 16#2060/2 | 16#5FBD/3C | 16#A0/01/02 = 160/01/02 | N_Y | Configuration and settings | R/WS | WORD (Enumeration) | - | [No] (nO) | - | [Motor surge limit.] (SUL) | [MOTOR CONTROL] (drC-) | 461
SOP | Volt surge limit. opt | 16#313A = 12602 | 16#2060/3 | 16#5FBD/3D | 16#A0/01/03 = 160/01/03 | SOP | Configuration and settings | R/WS | WORD (Enumeration) | - | [10 µs] (10) | - | [Volt surge limit. opt] (SOP) | [MOTOR CONTROL] (drC-) | 462
VBR | Braking level | 16#3715 = 14101 | 16#206F/2 | 16#5FBF/D4 | 16#A7/01/66 = 167/01/102 | - | Configuration and settings | R/W | UINT (Unsigned16) | 1 V | Depends of rating | 305 V ... 1127 V | [Braking level] (Ubr) | [MOTOR CONTROL] (drC-) | 463
BBA | Braking balance | 16#3716 = 14102 | 16#206F/3 | 16#5FBD/7B | 16#A7/01/67 = 167/01/103 | N_Y | Configuration and settings | R/WS | WORD (Enumeration) | - | [No] (nO) | - | [Braking balance] (bbA) | [MOTOR CONTROL] (drC-) | 464
LBA | Load sharing | 16#37DD = 14301 | 16#2071/2 | 16#5FBD/83 | 16#A8/01/66 = 168/01/102 | N_Y | Configuration and settings | R/WS | WORD (Enumeration) | - | [No] (nO) | - | [Load sharing] (LbA) | [MOTOR CONTROL] (drC-) | 465
LBC | Load correction | 16#37DE = 14302 | 16#2071/3 | 16#5FBF/D5 | 16#A8/01/67 = 168/01/103 | - | Configuration and settings | R/W | UINT (Unsigned16) | 0.1 Hz | 0.0 Hz | 0.0 Hz ... 1000.0 Hz | [Load correction] (LbC) | [MOTOR CONTROL] (drC-) [SETTINGS] (SEt-) | 466
LBC1 | Correction min spd | 16#37DF = 14303 | 16#2071/4 | 16#5FBF/D6 | 16#A8/01/68 = 168/01/104 | - | Configuration and settings | R/W | UINT (Unsigned16) | 0.1 Hz | 0.0 Hz | 0.0 Hz ... 999.9 Hz | [Correction min spd] (LbC1) | [MOTOR CONTROL] (drC-) | 467
LBC2 | Correction max spd | 16#37E0 = 14304 | 16#2071/5 | 16#5FBF/D7 | 16#A8/01/69 = 168/01/105 | - | Configuration and settings | R/W | UINT (Unsigned16) | 0.1 Hz | 0.1 Hz | 0.1 Hz ... 1000.0 Hz | [Correction max spd] (LbC2) | [MOTOR CONTROL] (drC-) | 468
LBC3 | Torque offset | 16#37E1 = 14305 | 16#2071/6 | 16#5FBF/D8 | 16#A8/01/6A = 168/01/106 | - | Configuration and settings | R/W | UINT (Unsigned16) | 1 % | 0 % | 0 % ... 300 % | [Torque offset] (LbC3) | [MOTOR CONTROL] (drC-) | 469
LBF | Sharing filter | 16#37E2 = 14306 | 16#2071/7 | 16#5FBF/D9 | 16#A8/01/6B = 168/01/107 | - | Configuration and settings | R/W | UINT (Unsigned16) | 1 ms | 100 ms | 100 ms ... 20000 ms | [Sharing filter] (LbF) | [MOTOR CONTROL] (drC-) | 470
TCC | 2/3 wire control | 16#2B5D = 11101 | 16#2051/2 | 16#5FBC/FA | 16#98/01/66 = 152/01/102 | TCC | Configuration and settings | R/WS | WORD (Enumeration) | - | [2 wire] (2C) | - | [2/3 wire control] (tCC) | [SIMPLY START] (SIM-) [INPUTS / OUTPUTS CFG] (I_O-) | 471
TCT | 2 wire type | 16#2B5E = 11102 | 16#2051/3 | 16#5FBC/FB | 16#98/01/67 = 152/01/103 | TCT | Configuration and settings | R/WS | WORD (Enumeration) | - | [Transition] (trn) | - | [2 wire type] (tCt) | [INPUTS / OUTPUTS CFG] (I_O-) | 472
RRS | Reverse assign. | 16#2B61 = 11105 | 16#2051/6 | 16#5FBC/FE | 16#98/01/6A = 152/01/106 | PSLIN | Configuration and settings | R/WS | WORD (Enumeration) | - | Refer to programming manual | - | [Reverse assign.] (rrS) | [INPUTS / OUTPUTS CFG] (I_O-) | 473
BSP | Reference template | 16#0C22 = 3106 | 16#2001/7 | 16#5FBF/05 | 16#70/01/6B = 112/01/107 | BSP | Configuration and settings | R/W | WORD (Enumeration) | - | [Standard] (bSd) | - | [Reference template] (bSP) | [INPUTS / OUTPUTS CFG] (I_O-) | 474
L10D | LI10 On Delay | 16#0FAA = 4010 | 16#200A/B | 16#5FBC/17 | 16#75/01/0B = 117/01/11 | - | Configuration and settings | R/WS | UINT (Unsigned16) | 1 ms | 0 ms | 0 ms ... 200 ms | [LI10 On Delay] (L10d) | [LI10 CONFIGURATION] (L10-) | 475
L11D | LI11 On Delay | 16#0FAB = 4011 | 16#200A/C | 16#5FBC/18 | 16#75/01/0C = 117/01/12 | - | Configuration and settings | R/WS | UINT (Unsigned16) | 1 ms | 0 ms | 0 ms ... 200 ms | [LI11 On Delay] (L11d) | [LI11 CONFIGURATION] (L11-) | 476
L12D | LI12 On Delay | 16#0FAC = 4012 | 16#200A/D | 16#5FBC/19 | 16#75/01/0D = 117/01/13 | - | Configuration and settings | R/WS | UINT (Unsigned16) | 1 ms | 0 ms | 0 ms ... 200 ms | [LI12 On Delay] (L12d) | [LI12 CONFIGURATION] (L12-) | 477
L13D | LI13 On Delay | 16#0FAD = 4013 | 16#200A/E | 16#5FBC/1A | 16#75/01/0E = 117/01/14 | - | Configuration and settings | R/WS | UINT (Unsigned16) | 1 ms | 0 ms | 0 ms ... 200 ms | [LI13 On Delay] (L13d) | [LI13 CONFIGURATION] (L13-) | 478
L14D | LI14 On Delay | 16#0FAE = 4014 | 16#200A/F | 16#5FBC/1B | 16#75/01/0F = 117/01/15 | - | Configuration and settings | R/WS | UINT (Unsigned16) | 1 ms | 0 ms | 0 ms ... 200 ms | [LI14 On Delay] (L14d) | [LI14 CONFIGURATION] (L14-) | 479
AI1T | AI1 Type | 16#1132 = 4402 | 16#200E/3 | 16#5FBC/34 | 16#77/01/03 = 119/01/03 | AIOT | Configuration and settings | R/WS | WORD (Enumeration) | - | [Voltage] (10U) | - | [AI1 Type] (AI1t) | [AI1 CONFIGURATION] (AI1-) | 480
UIL1 | AI1 min value | 16#113C = 4412 | 16#200E/D | 16#5FBC/38 | 16#77/01/0D = 119/01/13 | - | Configuration and settings | R/WS | UINT (Unsigned16) | 0.1 V | 0.0 V | 0.0 V ... 10.0 V | [AI1 min value] (UIL1) | [AI1 CONFIGURATION] (AI1-) | 481
UIH1 | AI1 max value | 16#1146 = 4422 | 16#200E/17 | 16#5FBC/3B | 16#77/01/17 = 119/01/23 | - | Configuration and settings | R/WS | UINT (Unsigned16) | 0.1 V | 10.0 V | 0.0 V ... 10.0 V | [AI1 max value] (UIH1) | [AI1 CONFIGURATION] (AI1-) | 482
AI1F | AI1 filter | 16#1164 = 4452 | 16#200E/35 | 16#5FBC/44 | 16#77/01/35 = 119/01/53 | - | Configuration and settings | R/WS | UINT (Unsigned16) | 0.01 s | 0.00 s | 0.00 s ... 10.00 s | [AI1 filter] (AI1F) | [AI1 CONFIGURATION] (AI1-) | 483
AI1E | AI1 Interm. point X | 16#116E = 4462 | 16#200E/3F | 16#5FBC/48 | 16#77/01/3F = 119/01/63 | - | Configuration and settings | R/WS | UINT (Unsigned16) | 1 % | 0 % | 0 % ... 100 % | [AI1 Interm. point X] (AI1E) | [AI1 CONFIGURATION] (AI1-) | 484
AI1S | AI1 Interm. point Y | 16#1178 = 4472 | 16#200E/49 | 16#5FBC/4C | 16#77/01/49 = 119/01/73 | - | Configuration and settings | R/WS | UINT (Unsigned16) | 1 % | 0 % | 0 % ... 100 % | [AI1 Interm. point Y] (AI1S) | [AI1 CONFIGURATION] (AI1-) | 485
AI2T | AI2 Type | 16#1133 = 4403 | 16#200E/4 | 16#5FBC/35 | 16#77/01/04 = 119/01/04 | AIOT | Configuration and settings | R/WS | WORD (Enumeration) | - | [Current] (0A) | - | [AI2 Type] (AI2t) | [AI2 CONFIGURATION] (AI2-) | 486
CRL2 | AI2 min. value | 16#1151 = 4433 | 16#200E/22 | 16#5FBC/3E | 16#77/01/22 = 119/01/34 | - | Configuration and settings | R/WS | UINT (Unsigned16) | 0.1 mA | 0.0 mA | 0.0 mA ... 20.0 mA | [AI2 min. value] (CrL2) | [AI2 CONFIGURATION] (AI2-) | 487
UIL2 | AI2 min value | 16#113D = 4413 | 16#200E/E | 16#5FBC/39 | 16#77/01/0E = 119/01/14 | - | Configuration and settings | R/WS | UINT (Unsigned16) | 0.1 V | 0.0 V | 0.0 V ... 10.0 V | [AI2 min value] (UIL2) | [AI2 CONFIGURATION] (AI2-) | 488
CRH2 | AI2 max. value | 16#115B = 4443 | 16#200E/2C | 16#5FBC/41 | 16#77/01/2C = 119/01/44 | - | Configuration and settings | R/WS | UINT (Unsigned16) | 0.1 mA | 20.0 mA | 0.0 mA ... 20.0 mA | [AI2 max. value] (CrH2) | [AI2 CONFIGURATION] (AI2-) | 489
UIH2 | AI2 max value | 16#1147 = 4423 | 16#200E/18 | 16#5FBC/3C | 16#77/01/18 = 119/01/24 | - | Configuration and settings | R/WS | UINT (Unsigned16) | 0.1 V | 10.0 V | 0.0 V ... 10.0 V | [AI2 max value] (UIH2) | [AI2 CONFIGURATION] (AI2-) | 490
AI2F | AI2 filter | 16#1165 = 4453 | 16#200E/36 | 16#5FBC/45 | 16#77/01/36 = 119/01/54 | - | Configuration and settings | R/WS | UINT (Unsigned16) | 0.01 s | 0.00 s | 0.00 s ... 10.00 s | [AI2 filter] (AI2F) | [AI2 CONFIGURATION] (AI2-) | 491
AI2L | AI2 range | 16#1183 = 4483 | 16#200E/54 | 16#5FBC/50 | 16#77/01/54 = 119/01/84 | AIOL | Configuration and settings | R/WS | WORD (Enumeration) | - | [0 - 100%] (POS) | - | [AI2 range] (AI2L) | [AI2 CONFIGURATION] (AI2-) | 492
AI2E | AI2 Interm. point X | 16#116F = 4463 | 16#200E/40 | 16#5FBC/49 | 16#77/01/40 = 119/01/64 | - | Configuration and settings | R/WS | UINT (Unsigned16) | 1 % | 0 % | 0 % ... 100 % | [AI2 Interm. point X] (AI2E) | [AI2 CONFIGURATION] (AI2-) | 493
AI2S | AI2 Interm. point Y | 16#1179 = 4473 | 16#200E/4A | 16#5FBC/4D | 16#77/01/4A = 119/01/74 | - | Configuration and settings | R/WS | UINT (Unsigned16) | 1 % | 0 % | 0 % ... 100 % | [AI2 Interm. point Y] (AI2S) | [AI2 CONFIGURATION] (AI2-) | 494
AI3T | AI3 Type | 16#1134 = 4404 | 16#200E/5 | 16#5FBC/36 | 16#77/01/05 = 119/01/05 | AIOT | Configuration and settings | R/WS | WORD (Enumeration) | - | [Current] (0A) | - | [AI3 Type] (AI3t) | [AI3 CONFIGURATION] (AI3-) | 495
CRL3 | AI3 min. value | 16#1152 = 4434 | 16#200E/23 | 16#5FBC/3F | 16#77/01/23 = 119/01/35 | - | Configuration and settings | R/WS | UINT (Unsigned16) | 0.1 mA | 0.0 mA | 0.0 mA ... 20.0 mA | [AI3 min. value] (CrL3) | [AI3 CONFIGURATION] (AI3-) | 496
CRH3 | AI3 max. value | 16#115C = 4444 | 16#200E/2D | 16#5FBC/42 | 16#77/01/2D = 119/01/45 | - | Configuration and settings | R/WS | UINT (Unsigned16) | 0.1 mA | 20.0 mA | 0.0 mA ... 20.0 mA | [AI3 max. value] (CrH3) | [AI3 CONFIGURATION] (AI3-) | 497
AI3F | AI3 filter | 16#1166 = 4454 | 16#200E/37 | 16#5FBC/46 | 16#77/01/37 = 119/01/55 | - | Configuration and settings | R/WS | UINT (Unsigned16) | 0.01 s | 0.00 s | 0.00 s ... 10.00 s | [AI3 filter] (AI3F) | [AI3 CONFIGURATION] (AI3-) | 498
AI3L | AI3 range | 16#1184 = 4484 | 16#200E/55 | 16#5FBC/51 | 16#77/01/55 = 119/01/85 | AIOL | Configuration and settings | R/WS | WORD (Enumeration) | - | [0 - 100%] (POS) | - | [AI3 range] (AI3L) | [AI3 CONFIGURATION] (AI3-) | 499
AI3E | AI3 Interm. point X | 16#1170 = 4464 | 16#200E/41 | 16#5FBC/4A | 16#77/01/41 = 119/01/65 | - | Configuration and settings | R/WS | UINT (Unsigned16) | 1 % | 0 % | 0 % ... 100 % | [AI3 Interm. point X] (AI3E) | [AI3 CONFIGURATION] (AI3-) | 500
AI3S | AI3 Interm. point Y | 16#117A = 4474 | 16#200E/4B | 16#5FBC/4E | 16#77/01/4B = 119/01/75 | - | Configuration and settings | R/WS | UINT (Unsigned16) | 1 % | 0 % | 0 % ... 100 % | [AI3 Interm. point Y] (AI3S) | [AI3 CONFIGURATION] (AI3-) | 501
AI4T | AI4 Type | 16#1135 = 4405 | 16#200E/6 | 16#5FBC/37 | 16#77/01/06 = 119/01/06 | AIOT | Configuration and settings | R/WS | WORD (Enumeration) | - | [Voltage] (10U) | - | [AI4 Type] (AI4t) | [AI4 CONFIGURATION] (AI4-) | 502
CRL4 | AI4 min. value | 16#1153 = 4435 | 16#200E/24 | 16#5FBC/40 | 16#77/01/24 = 119/01/36 | - | Configuration and settings | R/WS | UINT (Unsigned16) | 0.1 mA | 0.0 mA | 0.0 mA ... 20.0 mA | [AI4 min. value] (CrL4) | [AI4 CONFIGURATION] (AI4-) | 503
UIL4 | AI4 min value | 16#113F = 4415 | 16#200E/10 | 16#5FBC/3A | 16#77/01/10 = 119/01/16 | - | Configuration and settings | R/WS | UINT (Unsigned16) | 0.1 V | 0.0 V | 0.0 V ... 10.0 V | [AI4 min value] (UIL4) | [AI4 CONFIGURATION] (AI4-) | 504
CRH4 | AI4 max. value | 16#115D = 4445 | 16#200E/2E | 16#5FBC/43 | 16#77/01/2E = 119/01/46 | - | Configuration and settings | R/WS | UINT (Unsigned16) | 0.1 mA | 20.0 mA | 0.0 mA ... 20.0 mA | [AI4 max. value] (CrH4) | [AI4 CONFIGURATION] (AI4-) | 505
UIH4 | AI4 max value | 16#1149 = 4425 | 16#200E/1A | 16#5FBC/3D | 16#77/01/1A = 119/01/26 | - | Configuration and settings | R/WS | UINT (Unsigned16) | 0.1 V | 10.0 V | 0.0 V ... 10.0 V | [AI4 max value] (UIH4) | [AI4 CONFIGURATION] (AI4-) | 506
AI4F | AI4 filter | 16#1167 = 4455 | 16#200E/38 | 16#5FBC/47 | 16#77/01/38 = 119/01/56 | - | Configuration and settings | R/WS | UINT (Unsigned16) | 0.01 s | 0.00 s | 0.00 s ... 10.00 s | [AI4 filter] (AI4F) | [AI4 CONFIGURATION] (AI4-) | 507
AI4L | AI4 range | 16#1185 = 4485 | 16#200E/56 | 16#5FBC/52 | 16#77/01/56 = 119/01/86 | AIOL | Configuration and settings | R/WS | WORD (Enumeration) | - | [0 - 100%] (POS) | - | [AI4 range] (AI4L) | [AI4 CONFIGURATION] (AI4-) | 508
AI4E | AI4 Interm.point X | 16#1171 = 4465 | 16#200E/42 | 16#5FBC/4B | 16#77/01/42 = 119/01/66 | - | Configuration and settings | R/WS | UINT (Unsigned16) | 1 % | 0 % | 0 % ... 100 % | [AI4 Interm.point X] (AI4E) | [AI4 CONFIGURATION] (AI4-) | 509
AI4S | AI4 Interm.point Y | 16#117B = 4475 | 16#200E/4C | 16#5FBC/4F | 16#77/01/4C = 119/01/76 | - | Configuration and settings | R/WS | UINT (Unsigned16) | 1 % | 0 % | 0 % ... 100 % | [AI4 Interm.point Y] (AI4S) | [AI4 CONFIGURATION] (AI4-) | 510
PIL | RP min value | 16#33F6 = 13302 | 16#2067/3 | 16#5FBD/59 | 16#A3/01/67 = 163/01/103 | - | Configuration and settings | R/WS | INT (Signed16) | 0.01 kHz | 0.00 kHz | -30.00 kHz ... 30.00 kHz |  |  | 511
PFR | RP max value | 16#33F7 = 13303 | 16#2067/4 | 16#5FBD/5A | 16#A3/01/68 = 163/01/104 | - | Configuration and settings | R/WS | UINT (Unsigned16) | 0.01 kHz | 30.00 kHz | 0.00 kHz ... 30.00 kHz | [RP max value] (PFr) | [RP CONFIGURATION] (PLI-) | 512
PFI | RP filter | 16#33F8 = 13304 | 16#2067/5 | 16#5FBD/5B | 16#A3/01/69 = 163/01/105 | - | Configuration and settings | R/WS | UINT (Unsigned16) | 1 ms | 0 ms | 0 ms ... 1000 ms | [RP filter] (PFI) | [RP CONFIGURATION] (PLI-) | 513
PGA | Reference type | 16#33F5 = 13301 | 16#2067/2 | 16#5FBD/58 | 16#A3/01/66 = 163/01/102 | PGA | Configuration and settings | R/WS | WORD (Enumeration) | - | [Encoder] (EnC) | - | [Reference type] (PGA) | [ENCODER CONFIGURATION] (IEn-) | 514
EIL | Freq. min. value | 16#33FE = 13310 | 16#2067/B | 16#5FBD/5C | 16#A3/01/6F = 163/01/111 | - | Configuration and settings | R/WS | INT (Signed16) | 0.01 kHz | 0.00 kHz | -300.00 kHz ... 300.00 kHz | [Freq. min. value] (EIL) | [ENCODER CONFIGURATION] (IEn-) | 515
EFR | Freq. max value | 16#33FF = 13311 | 16#2067/C | 16#5FBD/5D | 16#A3/01/70 = 163/01/112 | - | Configuration and settings | R/WS | UINT (Unsigned16) | 0.01 kHz | 300.00 kHz | 0.00 kHz ... 300.00 kHz | [Freq. max value] (EFr) | [ENCODER CONFIGURATION] (IEn-) | 516
EFI | Freq. signal filter | 16#3400 = 13312 | 16#2067/D | 16#5FBD/5E | 16#A3/01/71 = 163/01/113 | - | Configuration and settings | R/WS | UINT (Unsigned16) | 1 ms | 0 ms | 0 ms ... 1000 ms | [Freq. signal filter] (EFI) | [ENCODER CONFIGURATION] (IEn-) | 517
PDI | Encoder counter divisor | 16#15EA = 5610 | 16#201A/B | 16#5FBC/76 | 16#7D/01/0B = 125/01/11 | - | Configuration and settings | R/WS | UINT (Unsigned16) | 1 | 1 | - |  |  | 518
LO1 | LO1 assignment | 16#1391 = 5009 | 16#2014/A | 16#5FBC/69 | 16#7A/01/0A = 122/01/10 | PSL | Configuration and settings | R/WS | WORD (Enumeration) | - | [No] (nO) | - | [LO1 assignment] (LO1) | [LO1 CONFIGURATION] (LO1-) | 519
LO1D | LO1 delay time | 16#1099 = 4249 | 16#200C/32 | 16#5FBC/30 | 16#76/01/32 = 118/01/50 | - | Configuration and settings | R/WS | UINT (Unsigned16) | 1 ms | 0 ms | 0 ms ... 60000 ms | [LO1 delay time] (LO1d) | [LO1 CONFIGURATION] (LO1-) | 520
LO1S | LO1 active at | 16#1071 = 4209 | 16#200C/A | 16#5FBC/20 | 16#76/01/0A = 118/01/10 | NPL | Configuration and settings | R/WS | WORD (Enumeration) | - | [1] (POS) | - | [LO1 active at] (LO1S) | [LO1 CONFIGURATION] (LO1-) | 521
LO1H | LO1 holding time | 16#1085 = 4229 | 16#200C/1E | 16#5FBC/28 | 16#76/01/1E = 118/01/30 | - | Configuration and settings | R/WS | UINT (Unsigned16) | 1 ms | 0 ms | 0 ms ... 9999 ms | [LO1 holding time] (LO1H) | [LO1 CONFIGURATION] (LO1-) | 522
LO2 | LO2 assignment | 16#1392 = 5010 | 16#2014/B | 16#5FBC/6A | 16#7A/01/0B = 122/01/11 | PSL | Configuration and settings | R/WS | WORD (Enumeration) | - | [No] (nO) | - | [LO2 assignment] (LO2) | [LO2 CONFIGURATION] (LO2-) | 523
LO2D | LO2 delay time | 16#109A = 4250 | 16#200C/33 | 16#5FBC/31 | 16#76/01/33 = 118/01/51 | - | Configuration and settings | R/WS | UINT (Unsigned16) | 1 ms | 0 ms | 0 ms ... 60000 ms | [LO2 delay time] (LO2d) | [LO2 CONFIGURATION] (LO2-) | 524
LO2S | LO2 active at | 16#1072 = 4210 | 16#200C/B | 16#5FBC/21 | 16#76/01/0B = 118/01/11 | NPL | Configuration and settings | R/WS | WORD (Enumeration) | - | [1] (POS) | - | [LO2 active at] (LO2S) | [LO2 CONFIGURATION] (LO2-) | 525
LO2H | LO2 holding time | 16#1086 = 4230 | 16#200C/1F | 16#5FBC/29 | 16#76/01/1F = 118/01/31 | - | Configuration and settings | R/WS | UINT (Unsigned16) | 1 ms | 0 ms | 0 ms ... 9999 ms | [LO2 holding time] (LO2H) | [LO2 CONFIGURATION] (LO2-) | 526
LO3 | LO3 assignment | 16#1393 = 5011 | 16#2014/C | 16#5FBC/6B | 16#7A/01/0C = 122/01/12 | PSL | Configuration and settings | R/WS | WORD (Enumeration) | - | [No] (nO) | - | [LO3 assignment] (LO3) | [LO3 CONFIGURATION] (LO3-) | 527
LO3D | LO3 delay time | 16#109B = 4251 | 16#200C/34 | 16#5FBC/32 | 16#76/01/34 = 118/01/52 | - | Configuration and settings | R/WS | UINT (Unsigned16) | 1 ms | 0 ms | 0 ms ... 60000 ms | [LO3 delay time] (LO3d) | [LO3 CONFIGURATION] (LO3-) | 528
LO3S | LO3 active at | 16#1073 = 4211 | 16#200C/C | 16#5FBC/22 | 16#76/01/0C = 118/01/12 | NPL | Configuration and settings | R/WS | WORD (Enumeration) | - | [1] (POS) | - | [LO3 active at] (LO3S) | [LO3 CONFIGURATION] (LO3-) | 529
LO3H | LO3 holding time | 16#1087 = 4231 | 16#200C/20 | 16#5FBC/2A | 16#76/01/20 = 118/01/32 | - | Configuration and settings | R/WS | UINT (Unsigned16) | 1 ms | 0 ms | 0 ms ... 9999 ms | [LO3 holding time] (LO3H) | [LO3 CONFIGURATION] (LO3-) | 530
LO4 | LO4 assignment | 16#1394 = 5012 | 16#2014/D | 16#5FBC/6C | 16#7A/01/0D = 122/01/13 | PSL | Configuration and settings | R/WS | WORD (Enumeration) | - | [No] (nO) | - | [LO4 assignment] (LO4) | [LO4 CONFIGURATION] (LO4-) | 531
LO4D | LO4 delay time | 16#109C = 4252 | 16#200C/35 | 16#5FBC/33 | 16#76/01/35 = 118/01/53 | - | Configuration and settings | R/WS | UINT (Unsigned16) | 1 ms | 0 ms | 0 ms ... 60000 ms | [LO4 delay time] (LO4d) | [LO4 CONFIGURATION] (LO4-) | 532
LO4S | LO4 active at | 16#1074 = 4212 | 16#200C/D | 16#5FBC/23 | 16#76/01/0D = 118/01/13 | NPL | Configuration and settings | R/WS | WORD (Enumeration) | - | [1] (POS) | - | [LO4 active at] (LO4S) | [LO4 CONFIGURATION] (LO4-) | 533
LO4H | LO4 holding time | 16#1088 = 4232 | 16#200C/21 | 16#5FBC/2B | 16#76/01/21 = 118/01/33 | - | Configuration and settings | R/WS | UINT (Unsigned16) | 1 ms | 0 ms | 0 ms ... 9999 ms | [LO4 holding time] (LO4H) | [LO4 CONFIGURATION] (LO4-) | 534
DO1 | DO1 assignment | 16#13A7 = 5031 | 16#2014/20 | 16#5FBD/94 | 16#7A/01/20 = 122/01/32 | PSL | Configuration and settings | R/WS | WORD (Enumeration) | - | [No] (nO) | - | [DO1 assignment] (dO1) | [DO1 CONFIGURATION] (dO1-) | 535
DO1D | DO1 delay time | 16#10B9 = 4281 | 16#200C/52 | 16#5FBD/8D | 16#76/01/52 = 118/01/82 | - | Configuration and settings | R/WS | UINT (Unsigned16) | 1 ms | 0 ms | 0 ms ... 60000 ms | [DO1 delay time] (dO1d) | [DO1 CONFIGURATION] (dO1-) | 536
DO1H | DO1 holding time | 16#10AF = 4271 | 16#200C/48 | 16#5FBD/8C | 16#76/01/48 = 118/01/72 | - | Configuration and settings | R/WS | UINT (Unsigned16) | 1 ms | 0 ms | 0 ms ... 9999 ms | [DO1 holding time] (dO1H) | [DO1 CONFIGURATION] (dO1-) | 537
DO1S | DO1 active at | 16#10A5 = 4261 | 16#200C/3E | 16#5FBD/8B | 16#76/01/3E = 118/01/62 | NPL | Configuration and settings | R/WS | WORD (Enumeration) | - | [1] (POS) | - | [DO1 active at] (dO1S) | [DO1 CONFIGURATION] (dO1-) | 538
AO1 | AO1 assignment | 16#139D = 5021 | 16#2014/16 | 16#5FBC/6D | 16#7A/01/16 = 122/01/22 | PSA | Configuration and settings | R/WS | WORD (Enumeration) | - | [No] (nO) | - | [AO1 assignment] (AO1) | [AO1 CONFIGURATION] (AO1-) | 539
AO1T | AO1 Type | 16#11F9 = 4601 | 16#2010/2 | 16#5FBC/53 | 16#78/01/02 = 120/01/02 | AIOT | Configuration and settings | R/WS | WORD (Enumeration) | - | [Current] (0A) | - | [AO1 Type] (AO1t) | [AO1 CONFIGURATION] (AO1-) | 540
AOL1 | AO1 min output | 16#1221 = 4641 | 16#2010/2A | 16#5FBC/5F | 16#78/01/2A = 120/01/42 | - | Configuration and settings | R/WS | UINT (Unsigned16) | 0.1 mA | 0.0 mA | 0.0 mA ... 20.0 mA | [AO1 min output] (AOL1) | [AO1 CONFIGURATION] (AO1-) | 541
AOH1 | AO1 max output | 16#122B = 4651 | 16#2010/34 | 16#5FBC/62 | 16#78/01/34 = 120/01/52 | - | Configuration and settings | R/WS | UINT (Unsigned16) | 0.1 mA | 20.0 mA | 0.0 mA ... 20.0 mA | [AO1 max output] (AOH1) | [AO1 CONFIGURATION] (AO1-) | 542
UOL1 | AO1 min Output | 16#120D = 4621 | 16#2010/16 | 16#5FBC/59 | 16#78/01/16 = 120/01/22 | - | Configuration and settings | R/WS | UINT (Unsigned16) | 0.1 V | 0.0 V | 0.0 V ... 10.0 V | [AO1 min Output] (UOL1) | [AO1 CONFIGURATION] (AO1-) | 543
UOH1 | AO1 max Output | 16#1217 = 4631 | 16#2010/20 | 16#5FBC/5C | 16#78/01/20 = 120/01/32 | - | Configuration and settings | R/WS | UINT (Unsigned16) | 0.1 V | 10.0 V | 0.0 V ... 10.0 V | [AO1 max Output] (UOH1) | [AO1 CONFIGURATION] (AO1-) | 544
ASL1 | Scaling AO1 min | 16#1235 = 4661 | 16#2010/3E | 16#5FBD/8E | 16#78/01/3E = 120/01/62 | - | Configuration and settings | R/WS | UINT (Unsigned16) | 0.1 % | 0.0 % | 0.0 % ... 100.0 % | [Scaling AO1 min] (ASL1) | [AO1 CONFIGURATION] (AO1-) | 545

Sheet: Enumerations
Code | Values | Display | Description
ACT | 0 | [Not done] (tAb)
 | 1 | [Pending] (PEnd)
 | 2 | [In Progress] (PrOG)
 | 3 | [Failed] (FAIL)
 | 4 | [Done] (dOnE)
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
