SebKuzminsky/MazakVQC1540/bon-wiring/bon-wiring.sch

## KiCad design bon-wiring/bon-wiring.sch (2022-07-02)

Schematic: bon-wiring.sch

Parts:
J: CAM1
Q1, Q2, Q3: 2N5551; TO-92_Inline
R1, R2, R3: 22k

Notes on the sheet:
External Relay Board
