SebKuzminsky/MazakVQC1540/MAZAK-VQC1540-20170501/MAZAK-VQC1540.ini

# This config file was created 2022-06-14 13:55:44.558510 by the update_ini script
# The original config files may be found in the /home/linuxcnc/src/MazakVQC1540/MAZAK-VQC1540-20170501/MAZAK-VQC1540.old directory

# PRIMARY INITIALIZATION PARAMETERS - MAZAK-VQC1540 mill
# Author: Timothy Snowden / Solid Rock Development
#         (modified from 5i25/7i77 configuration by PNCConf)
# !!! DO NOT MODIFY WITH PNCCONF - FILE WILL BE RUINED !!!

[EMC]
# The version string for this INI file.
VERSION = 1.1

MACHINE = Mazak VQC 15/40
DEBUG = 0

[DISPLAY]
#DISPLAY = gmoccapy
DISPLAY = axis
PREFERENCE_FILE_PATH = MAZAK-VQC1540.pref
POSITION_OFFSET = RELATIVE
POSITION_FEEDBACK = ACTUAL
MAX_FEED_OVERRIDE = 2.000000
MAX_SPINDLE_OVERRIDE = 1.000000
MIN_SPINDLE_OVERRIDE = 0.500000
DEFAULT_SPINDLE_SPEED = 500
INTRO_GRAPHIC = linuxcnc.gif
INTRO_TIME = 5
PROGRAM_PREFIX = ../nc-files
INCREMENTS = 200mm 100mm 50mm 30mm 20mm 10mm 5mm 2mm 1mm 0.1mm 0.01mm
POSITION_FEEDBACK = ACTUAL
# FIXME Reduce default jog speed when done testing, originally 42 mm/s, not 500 mm/s
DEFAULT_LINEAR_VELOCITY = 42
MAX_LINEAR_VELOCITY = 100
MIN_LINEAR_VELOCITY = 0.25
DEFAULT_SPINDLE_SPEED = 500
DEFAULT_ANGULAR_VELOCITY = 0.250000
MAX_ANGULAR_VELOCITY = 1.000000
MIN_ANGULAR_VELOCITY = 0.010000
EDITOR = geany
GEOMETRY = xyz

# Custom Messages, used by gmoccapy
#MESSAGE_BOLDTEXT = OVERHEAT
#MESSAGE_TEXT = Main transformer overheat
#MESSAGE_TYPE = okdialog
#MESSAGE_PINNAME = overheat-main-transf

#MESSAGE_BOLDTEXT = LUBE SYSTEM FAULT
#MESSAGE_TEXT = Head lube pressure alarm 1
#MESSAGE_TYPE = okdialog
#MESSAGE_PINNAME = lube-head-pressure-1

#MESSAGE_BOLDTEXT = LUBE SYSTEM FAULT
#MESSAGE_TEXT = Head lube pressure alarm 2
#MESSAGE_TYPE = okdialog
#MESSAGE_PINNAME = lube-head-pressure-2

#MESSAGE_BOLDTEXT = OVERHEAT
#MESSAGE_TEXT = Thermal trip alarm
#MESSAGE_TYPE = okdialog
#MESSAGE_PINNAME = overheat-thermal-trip

#MESSAGE_BOLDTEXT = SPINDLE ALARM
#MESSAGE_TEXT = Spindle controller abnormal
#MESSAGE_TYPE = okdialog
#MESSAGE_PINNAME = spindle-cntrlr-alarm

#MESSAGE_BOLDTEXT = MACHINE POWER
#MESSAGE_TEXT = Machine power fault
#MESSAGE_TYPE = okdialog
#MESSAGE_PINNAME = machine-power-fault

#MESSAGE_BOLDTEXT = LUBE SYSTEM FAULT
#MESSAGE_TEXT = Way lube fault
#MESSAGE_TYPE = okdialog
#MESSAGE_PINNAME = lube-waylube

[FILTER]
PROGRAM_EXTENSION = .png,.gif,.jpg Greyscale Depth Image
PROGRAM_EXTENSION = .py Python Script
png = image-to-gcode
gif = image-to-gcode
jpg = image-to-gcode
py = python

[TASK]
TASK = milltask
CYCLE_TIME = 0.010

[PYTHON]
TOPLEVEL = python/MAZAK-VQC1540.py
PATH_APPEND = python

[RS274NGC]
# i.e. standards-compliant GCode, & changes thereto

# Define startup modes:
# - G17 = Plane XY
# - G20 = Units in INCHES
# - G40 = Cutter compensation OFF
# - G49 = Cancel (clear out any) TOOL LENGTH compensation
# - G64 = Path blending, P (tolerance) 0.001 inches
# - G80 = Cancel (any) canned cycle motion
# - G90 = ABSOLUTE distance mode
# - G92 = Restore previous Coordinate System offset
# - G94 = F-- = feed in UNITS/MINUTE (e.g. inches/minute)
# - G97 = Spindle control in RPM
# - G98 = In canned cycles, retract Z at least to pre-cycle Z position 
#RS274NGC_STARTUP_CODE = G17 G20 G40 G49 G64 P0.001 G80 G90 G92 G94 G97 G98
# - M64 P1 = worklight on
RS274NGC_STARTUP_CODE = M64 P0
# Define features enabled (bitmask ... add option values together to set value):
# - 4 = enable reading (only) of ini variables by: #<_ini[section]var_name>
# - 8 = enable reading (only) of hal variables by: #<_hal[Hal item]>
PARAMETER_FILE = MAZAK-VQC1540.var
SUBROUTINE_PATH = macros
ON_ABORT_COMMAND=O <on_abort> call
# Remap M6 (toolchange) to customize toolchange action
# Requirements:
# 1) Create remap.py file in current config folder
# 2) Add "from stdglue import *" (minus quotes) to remap.py
# 3) Add [PYTHON]TOPLEVEL=<your-top-level.py> to .ini
# 4) Add "import remap" (minus quotes) to your-top-level.py file
# 5) Add [PYTHON]PATH_APPEND=<path-to-config-python-directory> to .ini
#	 Suggestion: Create python folder in current config folder & use above
# 6) Copy stdglue.py (from /usr/share/linuxcnc/ncfiles/remap_lib/python-stdglue/stdglue.py) to local python folder
#REMAP = M6 modalgroup=6 prolog=change_prolog ngc=atc epilog=change_epilog
# Where:
# - modalgroup=6 ... toolchange group
# - prolog & epilog (python scripts before & after g-code) - use defaults for standard remaps
# - ngc = custom g-code macro for toolchange
RETAIN_G43 = 0
INI_VARS = 1
HAL_PIN_VARS = 0

[EMCMOT]
EMCMOT = motmod
COMM_TIMEOUT = 1.0
SERVO_PERIOD = 1000000
NUM_DIO = 8
NUM_AIO = 4

[HOSTMOT2]
# **** This is for info only ****
# DRIVER0=hm2_eth
# BOARD0=7i80
# BOARD1=7i49
# BOARD2=7i84(1)
# BOARD3=7i84(2)
# BOARD4=7i73

[HAL]
HALUI = halui
HALFILE = MAZAK-VQC1540.hal
HALFILE = spindle.hal
#HALFILE = atc.hal
HALFILE = plc.hal
HALFILE = /usr/share/linuxcnc/hallib/xhc-hb04.tcl
POSTGUI_HALFILE = postgui_call_list.hal
SHUTDOWN = shutdown.hal

[HALUI]

[XHC_HB04_CONFIG]
#       (required: 1|2 are supported)
layout = 2
coords = x y z
#coefs  = 1 1 1 1 (optional, filter coefs, 0 < coef < 1, not usually reqd)
#scales = 1 1 1 1 (optional)
#mpg_accels = 50 75 30 75 (optional, less than axis max accel)
threadname = servo-thread
# (optional: 1|2)
sequence = 1
# (optional: normal|vnormal)
jogmode = normal
require_pendant = no (optional: yes|no)
#inch_or_mm = in  (optional: in|mm, default is mm)

[XHC_HB04_BUTTONS]
#   (connect button to hal pin)
#name = pin
#name = ""   (no connect button)
#special cases:
start-pause = std_start_pause
step = xhc-hb04.stepsize-up

[TRAJ]

COORDINATES = XYZ
LINEAR_UNITS = mm
ANGULAR_UNITS = degree
DEFAULT_LINEAR_VELOCITY = 8.5
MAX_LINEAR_VELOCITY = 500
POSITION_FILE = position.txt
NO_FORCE_HOMING = 1

[EMCIO]
EMCIO = iov2
CYCLE_TIME = 0.100
TOOL_TABLE = tool.tbl

#********************
#********************
# AXES
#********************
#********************
[AXES]
RESOLVER_EXC_FREQ = 2.5

[KINS]
KINEMATICS = trivkins coordinates=XYZ
#This is a best-guess at the number of joints, it should be checked
JOINTS = 3

#********************
# Axis X
#********************

[AXIS_X]
MIN_LIMIT = -464
MAX_LIMIT = 50
MAX_VELOCITY = 400
MAX_ACCELERATION = 3000

[JOINT_0]
TYPE = LINEAR
# FIXME reduce *FERROR after testing
FERROR = 100
MIN_FERROR = 100
MAX_VELOCITY = 400
MAX_ACCELERATION = 3000
P = 20
I = 0
D = 0
FF0 = 0
FF1 = 1
FF2 = 0
BIAS = 0
DEADBAND = 0
MAX_ERROR = 0
MAX_OUTPUT = 0
RESOLVER_SCALE = 4
RESOLVER_VELOCITY_SCALE = 1.818182
RESOLVER_INDEX_DIVISOR = 5
OUTPUT_SCALE = -930
OUTPUT_MIN_LIMIT = -9
OUTPUT_MAX_LIMIT = 9
MIN_LIMIT = -464
MAX_LIMIT = 50
HOME = 0
HOME_OFFSET = 50.5
HOME_SEARCH_VEL = 100
HOME_LATCH_VEL = -0.50
HOME_FINAL_VEL = -100
HOME_USE_INDEX = NO
HOME_IGNORE_LIMITS = YES
HOME_SEQUENCE = 1

#********************
# Axis Y
#********************
[AXIS_Y]
MIN_LIMIT = -50
MAX_LIMIT = 295.0
MAX_VELOCITY = 400
MAX_ACCELERATION = 3000

[JOINT_1]
TYPE = LINEAR
# FIXME reduce *FERROR after testing
FERROR = 100
MIN_FERROR = 100
MAX_VELOCITY = 400
MAX_ACCELERATION = 3000
P = 20
I = 0
D = 0
FF0 = 0
FF1 = 1
FF2 = 0
BIAS = 0
DEADBAND = 0
MAX_ERROR = 0
MAX_OUTPUT = 0
RESOLVER_SCALE = 4
RESOLVER_VELOCITY_SCALE = 1.818182
RESOLVER_INDEX_DIVISOR = 5
OUTPUT_SCALE = -450
OUTPUT_MIN_LIMIT = -9
OUTPUT_MAX_LIMIT = 9
MIN_LIMIT = -50
MAX_LIMIT = 295
HOME = 0
HOME_OFFSET = 295.5
HOME_SEARCH_VEL = 100
HOME_LATCH_VEL = -0.5
HOME_FINAL_VEL = -100
HOME_USE_INDEX = NO
HOME_IGNORE_LIMITS = YES
HOME_SEQUENCE = 1

#********************
# Axis Z
#********************
[AXIS_Z]
MIN_LIMIT = -345
MAX_LIMIT = 0
MAX_VELOCITY = 200
MAX_ACCELERATION = 3000

[JOINT_2]
TYPE = LINEAR
FERROR = 100
MIN_FERROR = 100
MAX_VELOCITY = 200
MAX_ACCELERATION = 3000
P = 20
I = 0
D = 0
FF0 = 0
FF1 = 1
FF2 = 0
BIAS = 0
DEADBAND = 0
MAX_ERROR = 0
MAX_OUTPUT = 0
RESOLVER_SCALE = 2
RESOLVER_VELOCITY_SCALE = 0.8658953
RESOLVER_INDEX_DIVISOR = 5
OUTPUT_SCALE = 330
OUTPUT_MIN_LIMIT = -9
OUTPUT_MAX_LIMIT = 9
MIN_LIMIT = -345
MAX_LIMIT = 0
HOME = -2
HOME_OFFSET = 3
HOME_SEARCH_VEL = 100
HOME_LATCH_VEL = -0.7
HOME_FINAL_VEL = -10
HOME_USE_INDEX = NO
HOME_IGNORE_LIMITS = YES
HOME_SEQUENCE = 0

#********************
# Spindle 
#********************
[SPINDLE_9]
P = 0
I = 0
D = 0
FF0 = 1
FF1 = 0
FF2 = 0
BIAS = 0
DEADBAND = 0
MAX_ERROR = 0
MAX_OUTPUT = 0
OUTPUT_SCALE = 6000
# Number of ticks per RPM
ENCODER_SCALE = 4096
# Consider spindle at speed when it is within 10% of the commanded speed.
ATSPEED = 1.1

[SPINDLE_ORIENT]
P = 0
I = 0
D = 0
FF0 = 0
FF1 = 0
FF2 = 0
BIAS = 0
DEADBAND = 0
MAX_ERROR = 0
MAX_OUTPUT = 0
OUTPUT_SCALE = 500

#********************
# TOOL CHANGE 
#********************
[ATC]
#ALL ATC-RELATED POSITIONS IN **MACHINE COORDINATES (USE G53)!**
#X-axis in position to allow movement into ATC
X_ATC = 0
#Y-axis position to enter ATC magazine without engaging tool chain
Y_ATC_MAG = 3
#Y-axis position to engage tool chain
Y_ATC = 547
#Y soft limit for normal machining
Y_MAX_NORM = 340
 #Y soft limit for tool change
Y_MAX_ATC = 547.5
#Y-axis position to be safely clear of ATC magazine
Y_SAFE = 290
#Z-axis in highest position = max clearance / safety
Z_UP = 40
#Z-axis in position to clamp or unclamp tool in ATC
Z_ATC = -55.6
#Z soft limit for normal machining
Z_MAX_NORM = 0
#Z soft limit for tool change
Z_MAX_ATC = 42
