SebKuzminsky/MazakVQC1540/MAZAK-VQC1540-20170501/spindle.hal

# SPINDLE - MAZAK-VQC1540 mill
# Author: Timothy Snowden / Solid Rock Development
#         (modified from 5i25/7i77 configuration by PNCConf)
# Notes: All spindle-related functions connected in this file

#=============================
# MODULES/FUNCTIONS
#=============================
#-------------------
# LOAD MODULES
#-------------------
# PID Realtime Loop Component - add spindle
# already loaded in main hal file

# load a near component for at-speed discovery and attach it to a thread
loadrt near

# Make sure to not ramp down Altivar VDF too fast
loadrt limit2

loadrt orient names=spindleorient
loadrt scale names=spindleorientscale
loadrt or2 names=spindleactive,spindleforward

loadrt abs names=spindlespeed
addf spindlespeed servo-thread

#-------------------
# LOAD FUNCTIONS
#-------------------
# Every servo thread cycle:
# - Update the PID calculations for the spindle:
addf pid.s.do-pid-calcs servo-thread
addf pid.so.do-pid-calcs servo-thread

# - Update near calculation
addf near.0 servo-thread

# - Update limit2 calculation
addf limit2.0 servo-thread

# - Update orientation calculation
addf spindleorient servo-thread
addf spindleorientscale servo-thread
addf spindleactive servo-thread
addf spindleforward servo-thread

#=============================
# EXTERNAL SIGNALS
#=============================
# Connected in PLC


#=============================
# SPINDLE ORIENTATION CONTROL
#=============================

# SET PID-LOOP PARAMETERS (from .ini file variables):
setp   pid.so.Pgain     [SPINDLE_ORIENT]P
setp   pid.so.Igain     [SPINDLE_ORIENT]I
setp   pid.so.Dgain     [SPINDLE_ORIENT]D
setp   pid.so.bias      [SPINDLE_ORIENT]BIAS
setp   pid.so.FF0       [SPINDLE_ORIENT]FF0
setp   pid.so.FF1       [SPINDLE_ORIENT]FF1
setp   pid.so.FF2       [SPINDLE_ORIENT]FF2
setp   pid.so.deadband  [SPINDLE_ORIENT]DEADBAND
setp   pid.so.maxoutput [SPINDLE_ORIENT]MAX_OUTPUT
setp   pid.so.error-previous-target true
setp   pid.so.maxerror  [SPINDLE_ORIENT]MAX_ERROR

net spindle-revs hm2_7i80.0.encoder.00.position => spindleorient.position pid.so.feedback

setp spindleorientscale.gain [SPINDLE_ORIENT]OUTPUT_SCALE

net spindle-orient-enable      spindle.0.orient => spindleorient.enable pid.so.enable
net spindle-orient-position    spindle.0.orient-angle => spindleorient.angle
net spindle-orient-cmd 	       spindleorient.command => pid.so.command
net spindle-orient-cmd-scaled  pid.so.output => spindleorientscale.in
net spindle-orient-output      <= spindleorientscale.out

#=============================
# SPINDLE MOTION CONTROL
#=============================
# PWM GENERATOR SETUP
# Set PWMGen type for 7i49 (2 = up/down) - x-axis
setp 	hm2_7i80.0.pwmgen.03.output-type 2

# Set x-axis PWMGen scale - from .ini file
setp hm2_7i80.0.pwmgen.03.scale  			[SPINDLE_9]OUTPUT_SCALE

# Connect Signals:
# - Analog servo drive command signal to Mesa board analog-out
net spindle-mode-output  	hm2_7i80.0.pwmgen.03.value

# SET PID-LOOP PARAMETERS (from .ini file variables):
setp   pid.s.Pgain     [SPINDLE_9]P
setp   pid.s.Igain     [SPINDLE_9]I
setp   pid.s.Dgain     [SPINDLE_9]D
setp   pid.s.bias      [SPINDLE_9]BIAS
setp   pid.s.FF0       [SPINDLE_9]FF0
setp   pid.s.FF1       [SPINDLE_9]FF1
setp   pid.s.FF2       [SPINDLE_9]FF2
setp   pid.s.deadband  [SPINDLE_9]DEADBAND
setp   pid.s.maxoutput [SPINDLE_9]MAX_OUTPUT
setp   pid.s.error-previous-target true
setp   pid.s.maxerror  [SPINDLE_9]MAX_ERROR

setp   hm2_7i80.0.encoder.00.scale [SPINDLE_9]ENCODER_SCALE

# Connect Virtual Pins between Modules:
net spindle-index-enable        pid.s.index-enable
net spindle-rotate-enable       => pid.s.enable
net spindle-vel-cmd-rpm         => limit2.0.in
net spindle-rpm-lim             limit2.0.out => spindlespeed.in
net spindle-rpm-lin             spindlelin.out => pid.s.command
net spindle-vel-fb-rpm          pid.s.feedback
net spindle-vel-output          pid.s.output

net spindle-rpm-dir-split       spindlespeed.out => spindlelin.in
net spindle-reverse             <= spindlespeed.is-negative
net spindle-rotate-forward      <= spindlespeed.is-positive

# Setup Spindle Control Signals
net spindle-vel-cmd-rps		spindle.0.speed-out-rps
net spindle-vel-cmd-rps-abs	spindle.0.speed-out-rps-abs
net spindle-vel-cmd-rpm		spindle.0.speed-out
net spindle-vel-cmd-rpm-abs	spindle.0.speed-out-abs
# FIXME enable when spindle is working
net spindle-rotate-enable		<=	spindle.0.on
#net spindle-rotate-forward	spindle.0.forward
#net spindle-reverse		spindle.0.reverse
net spindle-brake		spindle.0.brake
net spindle-revs		spindle.0.revs
net spindle-at-speed		spindle.0.at-speed
net spindle-vel-fb-rps		spindle.0.speed-in
net spindle-index-enable	spindle.0.index-enable
net spindle-index-enable	hm2_7i80.0.encoder.00.index-enable

# Setup VFD ramp speed limitation, to avoid erroring out the Altivar
setp limit2.0.maxv 120

# Setup 'Spindle at Speed' Signals
# Connect near component to commanded and current speed to signal
# spindle-at-speed
net spindle-vel-cmd-rpm		=> near.0.in1
net spindle-vel-fb-rpm 		hm2_7i80.0.encoder.00.velocity-rpm  => near.0.in2
net spindle-at-speed 		spindle.0.at-speed <= near.0.out
net spindle-vel-fb-rps		hm2_7i80.0.encoder.00.velocity

# set the spindle speed inputs to agree if within 10% (from .ini file)
setp near.0.scale [SPINDLE_9]ATSPEED

#=============================
# Select vel/pos mode
#=============================

net spindle-orient-enable	=> spindlemode.sel
net spindle-vel-output 		=> spindlemode.in0
net spindle-orient-output	=> spindlemode.in1
net spindle-mode-output		<= spindlemode.out

net spindle-rotate-enable	=> spindleactive.in0
net spindle-orient-enable	=> spindleactive.in1
net spindle-enable		<= spindleactive.out

net spindle-forward		spindleforward.out
net spindle-rotate-forward 	=> spindleforward.in0
net spindle-orient-enable	=> spindleforward.in1

#=============================
# INTERNAL SIGNALS
#=============================
net spindle-manual-cw     	halui.spindle.0.forward
net spindle-manual-ccw    	halui.spindle.0.reverse
net spindle-manual-stop   	halui.spindle.0.stop

# Observed with Altivar 71 3kW
# requested - rpm
#   10 -  112
#   25 -  119
#   50 -  130
#  100 -  143
#  200 -  199
#  500 -  498
# 1000 -  995
# 2000 - 1983
# 3000 - 2968
# 4000 - 3960
# 5000 - 4960
# 6000 - 5980

setp spindlelin.x-val-00    0
setp spindlelin.y-val-00    0
setp spindlelin.x-val-01  112
setp spindlelin.y-val-01   10
setp spindlelin.x-val-02  119
setp spindlelin.y-val-02   25
setp spindlelin.x-val-03  130
setp spindlelin.y-val-03   50
setp spindlelin.x-val-04  143
setp spindlelin.y-val-04  100
setp spindlelin.x-val-05  199
setp spindlelin.y-val-05  200
setp spindlelin.x-val-06  498
setp spindlelin.y-val-06  500
setp spindlelin.x-val-07  995
setp spindlelin.y-val-07 1000
setp spindlelin.x-val-08 1983
setp spindlelin.y-val-08 2000
setp spindlelin.x-val-09 2968
setp spindlelin.y-val-09 3000
setp spindlelin.x-val-10 3960
setp spindlelin.y-val-10 4000
setp spindlelin.x-val-11 4960
setp spindlelin.y-val-11 5000
setp spindlelin.x-val-12 5980
setp spindlelin.y-val-12 6000
setp spindlelin.x-val-13 6000
setp spindlelin.y-val-13 6000
