SebKuzminsky/MazakVQC1540/(commit log)

2022-06-15 add a note on the ATX power supply
2022-06-15 use an external "8 channel 5V relay module" to enable servo amps
2022-06-15 I believe the spindle controller is marked FR-SE.
2022-06-15 The 24V power supply is Mean Well HDR-60-24.
2022-06-15 Document connector type next to each connector name.
2022-06-16 move external relay wiring to the `wires` doc
2022-06-16 Mention what is run on hydraulic and air pressure.
2022-06-16 all 3 axes limit switches are hooked up
    [plc.hal]
2022-06-16 wires: better table headers
2022-06-16 wires: some more notes on the servo drive interface
2022-06-16 fixup servos-ready net
    [plc.hal]
2022-06-16 remove redundant net (its in plc.hal)
    [MAZAK-VQC1540.hal]
2022-06-16 switch from gmoccapy to axis, disable M6 remap for now
    [postgui.hal]
2022-06-16 Mark connector names as titles in wire list for visual separation.
2022-06-16 Correct connector type for CND5 (MR-50 -> MR-20).
2022-06-16 hooked up some more wires
2022-06-16 rename estop signal to be clearer
    [plc.hal]
2022-06-16 start moving IO nets into main HAL file from PLC hal file
    [MAZAK-VQC1540.hal, plc.hal]
2022-06-16 move more nets from plc.hal to MAZAK.hal
    [MAZAK-VQC1540.hal, plc.hal]
2022-06-16 move servoN-on nets to Mazak.hal
    [MAZAK-VQC1540.hal, plc.hal]
2022-06-16 added some more nets
    [MAZAK-VQC1540.hal]
2022-06-17 add notes on servo amps
2022-06-17 fix startup procedure: don't release the brake until after the servos are enabled
2022-06-17 wires: oops, Servo On is an input to the amp from linuxcnc
2022-06-17 make "servo-on" outputs, and add commented-out nets for unused IO pins
    [MAZAK-VQC1540.hal]
2022-06-17 add notes on limit switches
2022-06-17 hook up limit & home switches to motion controller
    [MAZAK-VQC1540.hal]
2022-06-17 Add detail on servo amp.
2022-06-17 update notes on dealing with the Z brake
2022-06-17 wired up the servo amp control voltages from the 7i49
2022-06-17 oops, fix a type in a net name
    [MAZAK-VQC1540.hal]
2022-06-17 add notes on servo control voltage polarity
2022-06-18 readme: move NC connectors into the "hardware" section
2022-06-18 disconnect PID outputs from pwmgen inputs for testing
    [MAZAK-VQC1540.hal, spindle.hal]
2022-06-18 break servo-on-?
    [MAZAK-VQC1540.hal]
2022-06-18 note our secondary 24V power supply is always on
2022-06-18 note behavior of servo amp Alarm pins
2022-06-18 add notes on axis brakes
2022-06-18 add some FIXMEs for unknown servo amp pins
2022-06-18 comment out some currently-unused inputs
    [MAZAK-VQC1540.hal]
2022-06-18 disconnect the plc from the home and limit nets
    [plc.hal]
2022-06-18 fix pwmgen 0 scale to be intuitive (positive pwmgen value moves tool in +X direction)
    [MAZAK-VQC1540.ini]
2022-06-18 fix pwmgen.01 scale to be intuitive (positive value moves tool in +Y direction)
    [MAZAK-VQC1540.ini]
2022-06-18 fix comments for Z brake
    [MAZAK-VQC1540.hal]
2022-06-18 note that the Z pwmgen has intuitive behavior with scale 1
2022-06-18 add manual for our spindle drive
2022-06-18 fix spindle pins
2022-06-18 identify spindle drive more completely
2022-06-18 start documenting limit & home switches better, incomplete
    [MAZAK-VQC1540.hal]
2022-06-21 More on probe and servo tuning.
2022-06-22 add some notes on the external relay board
2022-06-23 Added image of the cutting board with mesa cards.
2022-06-23 More on the spindle.
2022-06-24 Mention ATX and GND for relevant resolver pins.
2022-06-25 Bring resolver scale for X and Y closer to reality.
    [MAZAK-VQC1540.ini]
2022-06-26 Tried to figure out the Spindle Controller CON1 pinout.
2022-06-26 Connected pin 20 of resolvers to 7i49 GND.
2022-06-26 describe external relay board connections better
2022-06-28 Adjust Z axis RESOLVER_SCALE to be closer to reality.
    [MAZAK-VQC1540.ini]
2022-06-28 A bit more on limit switches.
2022-07-01 Get X axis moving from LinuxCNC (very small moves, PID need tuning).
    [MAZAK-VQC1540.hal]
2022-07-01 Switch to mm as default unit and step sizes.
2022-07-02 Do not enable spindle for now.
    [spindle.hal]
2022-07-02 Do not connect home switches to joint pos-lim-sw-in.
    This disable motion.motion-enabled when homing, which is not
    something I want.
    [MAZAK-VQC1540.hal]
2022-07-02 Disable lube and hydraulic connection to motion.motion-enabled.
    This did not work
    [MAZAK-VQC1540.hal]
2022-07-02 Adjust X and Y resolver scale, pid.P and output scale for mm setup.
    [MAZAK-VQC1540.ini]
2022-07-02 Enable PID drive for X and Y now.
    [MAZAK-VQC1540.hal]
2022-07-02 Switch X and Y resolvers to scale 4 and Z to scale 2, after doing more measurements.
    [MAZAK-VQC1540.ini]
2022-07-02 Add logic AND gate to only release Z axis brake when Z axis is ready and ON
    This make sure the axis is not dropping when an error occur.
    [MAZAK-VQC1540.hal]
2022-07-02 start a new wiring diagram
    [bon-wiring.sch]
2022-07-03 Enable hydraulic pump and lube system is lube is requested or the axis are enabled.
    [MAZAK-VQC1540.hal]
2022-07-03 Comment X and Y activation pins alongside Z comment.
    [MAZAK-VQC1540.hal]
2022-07-03 Fixed typo, needed OR logic, not AND logic, for lube setup.
    Fixes 91efea995a4a1055d9f9d51da6f7768fddaf015a.
    [MAZAK-VQC1540.hal]
2022-07-03 Correct wires comment and servo AOUT GND.
2022-07-03 Fix typo in Z brake handling (break->brake).
    [MAZAK-VQC1540.hal]
2022-07-03 Get Z axis limping along. Need more tuning.
    [MAZAK-VQC1540.hal]
2022-07-03 Make sure power-on net is true when linuxcnc start.
    [MAZAK-VQC1540.hal]
2022-07-03 Connect GUI overtravel release with OTR pin.
    [MAZAK-VQC1540.hal]
2022-07-03 Wired and tested tool clamp/unclamp.
2022-07-04 Correct (and convert to mm) MAX/MIN limits after measuring.
    [MAZAK-VQC1540.ini]
2022-07-04 Document current estop setup.
    [MAZAK-VQC1540.hal]
2022-07-05 Reorder ini file to match order of file in master.
    This make it easier to compare the two.
    [MAZAK-VQC1540.hal]
2022-07-05 Remove changes commited by mistake.
    [MAZAK-VQC1540.hal]
2022-07-05 Add tool selection logic using the carousel HAL component.
    [MAZAK-VQC1540.hal]
2022-07-05 Make axis net connection arrows consistent with pid(9) directions.
    [MAZAK-VQC1540.hal]
2022-07-05 Document that spindle-set need to be true when unclamping tools.
2022-07-05 Use more correct and detailed machine name.
    [MAZAK-VQC1540.ini]
2022-07-05 Hook tool changer up to iocontrol machinery.
    Stop including atc.hal, not used at the moment. Might be needed
    to do the tool change itself.
    Use iov2 instead of io to get access to
    iocontrol.0.tool-prep-pocket.
    [MAZAK-VQC1540.hal]
2022-07-06 Re-enable home switch as limit switch
    This work better now the overtravel-release signal is connected
    to the user interface, allowing homing to work as it should.
    [MAZAK-VQC1540.hal]
2022-07-06 Increase X and Y max accelleration to 7000 mm/s^2.
    Testing confirmed that this work.
2022-07-08 Disable magazine jog button when in auto mode.
    Avoid messing up the magazine position in case a automatic tool change
    is in progress.
    [MAZAK-VQC1540.hal]
2022-07-09 Wired up tool eject door.
    [MAZAK-VQC1540.hal]
2022-07-09 Change manual tool jog and door handling
    Block jog button from moving carousel in auto mode, and block automatic
    carousel movement when tool eject door is open. Only allow the jog
    button to move the carousel when the door is open.
    Changed tool changer handling from using logic component to lut5
    component to reduce the number of nets and connections.
    [MAZAK-VQC1540.hal]
2022-07-09 Make sure X control voltage stay under +-10V.
2022-07-09 Bring RESOLVER_VELOCITY_SCALE for XYZ closer to reality
    [MAZAK-VQC1540.ini]
2022-07-09 Fixed typo in comment.
    [MAZAK-VQC1540.hal]
2022-07-10 Fix typo ERR3 is CMD 3 Ground.
2022-07-10 Dropped forced homing until Z axis behave better.
2022-07-10 Reduce max velocity and acceleration (and convert Z values to mm/s)
2022-07-10 SWitch to homing X and Y in paralell.
2022-07-10 Switch to at_pid generated PID parameters for X, Y and Z.
    Also increase the Z FERROR to 100 mm.
2022-07-10 Try reducing OUTPUT to 9V to avoid over current errors.
    [MAZAK-VQC1540.ini]
2022-07-10 Get Z homing limping along.
2022-07-10 Document the murder of the spindle controller
    And add some info on the motor and encoder.
2022-07-12 Drop Classicladder GUI at the start.
    [plc.hal]
2022-07-13 Add first draft of PID auto-tuning script.
2022-07-13 Add MAX_LIMIT=10 to Y and Z for auto-tuning to find mid-point
    The default MAX_LIMIT is a number with 93 digits, which gave bogus
    results when scripts/run-auto-pid-tuner tried to move to the mid-point
    of the Y and Z axis.
2022-07-13 Generated new Y PID values based on longer cycle time.
2022-07-15 Y axis really have a positive limit switch, 50.5mm behind the home switch.
    [MAZAK-VQC1540.hal]
2022-07-15 Reduce Z speed and acceleration and insert PID values from autotuning
2022-07-15 Correct info for hydraulic/lube pump wire.
2022-07-15 Convert logic components to named ones to avoid renaming in the future.
    [MAZAK-VQC1540.hal]
2022-07-15 Correct info about spindle motor.
2022-08-20 Fix software ESTOP
    Using setup from Hans Unzner.
    [MAZAK-VQC1540.hal]
2023-03-18 Added documentation for possible spindle VFD.
2023-06-18 Adjusted some wiring from this weekends improvements.
2023-06-18 Change to tool changer related wires.
2023-06-18 Connected Renishaw probe start pin.
2023-06-18 Changed PID settings from Rene Hopf
    Using scale instaed of I and D values to simplify the setup.
2023-06-18 Comment out wire removed on test machine.
2023-06-18 Switched Z axis PWM to 04 as 02 is broken.
    [MAZAK-VQC1540.hal]
2023-06-18 Document where the work probe enabler pin is connected.
    [MAZAK-VQC1540.hal]
2023-06-18 Several improvements from Andy
    Switched to VFD as spindle controller. Corrected tool changer positioning.
    Improved limit switch handling and tool changer limits.
    [MAZAK-VQC1540.hal, postgui.hal, spindle.hal]
2023-06-25 Change homing sequence, Z first to lift spindle and tool away from work piece as the first operation.
2023-06-25 Restructure digital out pins and add Renishaw probe start pin.
    [MAZAK-VQC1540.hal]
2023-06-25 Adjusted Y limit to reach tool height probe without releasing limits.
2023-07-02 Moved worklight to digital out 00.
    [MAZAK-VQC1540.hal]
2023-07-02 Allocate digital out 07 to select tool height switch.
    [MAZAK-VQC1540.hal]
2023-07-02 Get tool height probe working.
    Rewritten to take work space Z offset into account both when measuring
    spindle height and when calculating tool trigger height. Also changed
    from G43.1 which I could not figure out how to check if did what it should,
    to use G10 L1 where the measured and used height ended up in the tool table.
    Also clean up the GUI output.
2023-07-09 Remove unwanted printout at startup.
    [postgui.hal]
2024-07-07 Added Altivar 71 parameter doc from https://www.se.com/us/en/download/document/1755861/.
    [ATV71_communication_parameters_EN_V5.7_IE67.xls, readme_atv71_parameters_en.txt]
2025-07-06 Adjusted spindle speed setting to better work with Altivar VFD.
    Used linear interpolation to more accurately hit the requested RPM,
    as measured by the spindle encoder.
    [MAZAK-VQC1540.hal, spindle.hal]
2025-07-06 Added experimental spindle-at-speed calculation using encoder.
    Using borrowed Mesa 7k92 card and the near component to consider speed
    within 10% of the commanded RPM to be at speed.
    [MAZAK-VQC1540.hal, spindle.hal]
2025-07-06 Adjusted Z axis minimum limit to better match realities.
2025-07-06 Adjusted linear interpolation values for spindle speed setting.
    [MAZAK-VQC1540.hal, spindle.hal]
2025-07-06 Converted spindle encoding setup to work with less hardware.
    Adust setup from ba397a3af4c4c374b2acd99493a38e24e17c1b35 to work with
    my 7i80HD-25 instead of the borrowed 7i92.
    This require firmware 7i80hd_25_rmsvsspkt_6_4.bit with encoder support
    on the 7i44 card.
    [MAZAK-VQC1540.hal, spindle.hal]
2025-07-06 Document current Mesa firmware.
2025-07-07 Added more documentation on the spindle motor and controller.
2025-07-13 Indented IF blocks in tool-length-probe.ngc for easier readability.
2025-07-13 Introduced variables for constants in tool-length-probe.ngc.
2025-07-13 Measure tool height at the edge of the tool.
    Move the spindle to the side by the radius of the tool before taking
    measurements, to get the enge of larger tools.
2025-07-13 Speed up tool-length-probe.ngc and use correct Z clearance height.
2025-07-13 Reduced G90/G91 switches and clean up code in tool-length-probe.ngc.
2025-07-13 Fix bug in tool-length-probe.ngc, use required G90.
2025-07-24 Started on split PID control over spindel speed and position.
    This need more work and tuning to work with the VFD, but sketches how
    two different controllers can be used for speed and position control.
    Based on <URL: http://wiki.linuxcnc.org/uploads/orient.svg >
    and <URL: http://wiki.linuxcnc.org/cgi-bin/wiki.pl?SpindleOrient >.
    [MAZAK-VQC1540.hal, spindle.hal]
2025-07-24 Document smartserial encoder connections.
2025-08-09 Adjusted spindle.hal to get G33 and friends to work.
    Made sure spindle encoder position is connected to spindle.0.revs by
    renaming the spindle-orient-fb net to spindle-revs.
    [spindle.hal]
2025-08-10 Feed current spindle speed back into spindle.0.speed-in.
    Not sure if it help with spindle coordinated motion, but it did not
    seem to do any harm either.
    [spindle.hal]
2025-08-10 Corrected spindle speed linear curve to better match Altivar 71.
    Measured various speeds for given commanded speeds, and adjusted
    linear curve to closer match observed values. Was able to go to
    slower speeds by starting higher and bringing the speed down. Trying
    to go to speeds around 500 and lower directly caused the VFD to error
    out.
    [spindle.hal]
2025-08-10 More corrections for Altivar 71 spindle speed.
    Leftovers from 9582166393da52f6fbc46b1475773f32842ec222.
    [MAZAK-VQC1540.hal]
2025-08-10 Correct handling of spindle direction, get in flight direction change working.
    This get G33.1 working as expected, at the risk of erroring out the VFD at low speeds.
    [spindle.hal]
